Ajakovski/GrowHub/Documentation/growhub_design_v2.pdf

: : dts, g V\ : v.2 : : : : : ; | · · · · · · . . . . -~ . . . . f. -0~ l : n t W t( _i S t J ~ { ~0:--C :v f£ J:

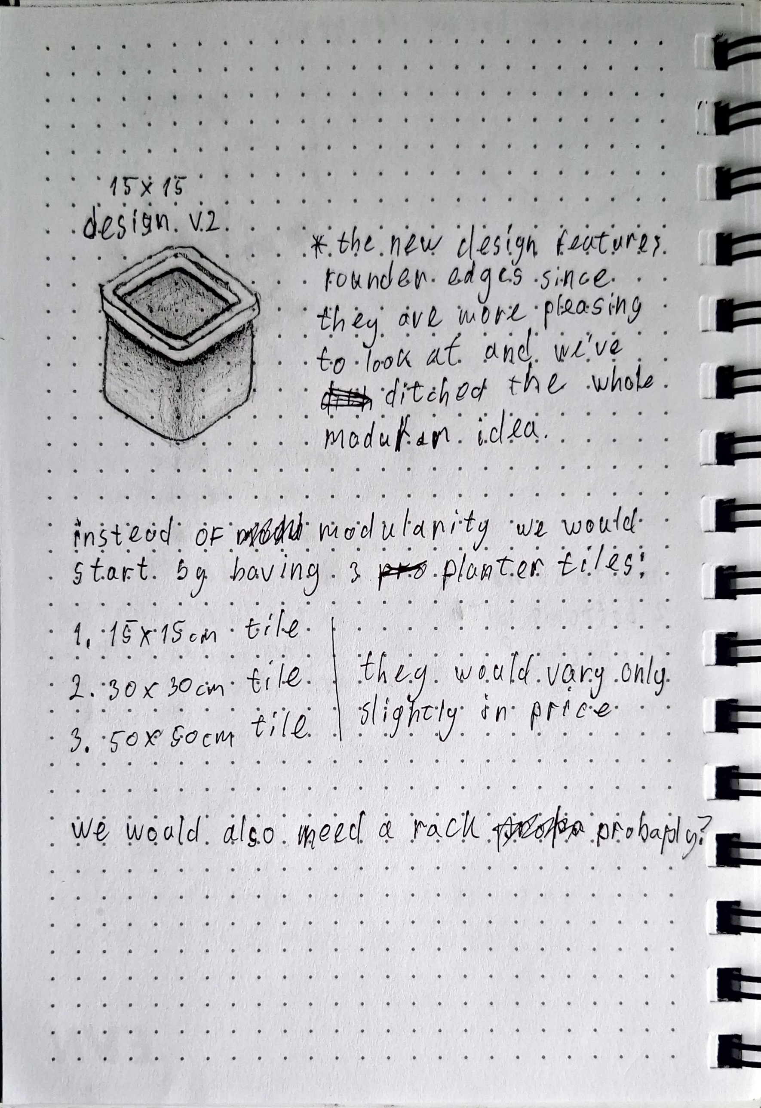
[picture p10: page 1]

- | t | • | t | • | | • • • •
I | • | • | I | •
- | a | • | I | e | t | I | 4 | I | ' | • • • • • • •
| ' | , . . . . • | • | • | • | • | • | • | • | • | It | • | • | • | • • • • • • • , . . . .
- · · 1s-x1t- · · · · · · · · · · · · · · · · · · ·
- • r-ot;_nJtt'• a-J3 LS .5;.ne,e,, . ..
. . | ' : t,h ?:i ~v ~ °W ~ rf, : rr~~£ 1:h~ : . . -f:-o . I o-rJ t{ (/..,t ,cl. n { \11 ,( V f . .
: : . | · k •di-tch 12rf tn t,; -W~ri!A .

## | ·~- ... . : ivi;d~f.Lrt : i:dJ~. : : : : : I

# . ~~0c~t: ~: ~~v:n~ :~ r.:P'.tJ~~~~~1:I?'. : -~

# 1 f • f f x• 15 G ~ • fJ / r~ • ' • • • ~ • , |

" | • | I | • | • | •

~ j
~-J

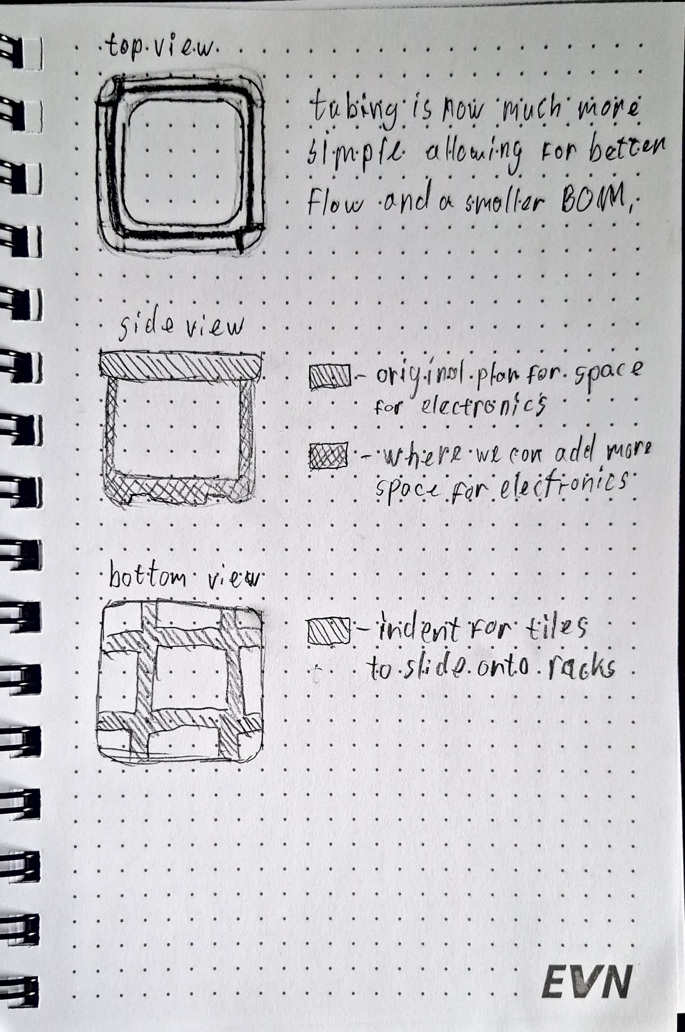
[picture p11: page 2]

~J
J
LI
~ ]
~
~
t:.11
~
~
~
~
t;a
t;;1
~

- • • • • • • • • • • • • • • • • •
| , . . . . ' . . . . .
t~ ~t~.'j J ~ ~Do/ : ri1:u ~~ :~or,: ~ i ·(Vl· p r 1- Q /.fr,~ i-Yl J tor b tt"t."fl F,:~ :0-~J; ~:V'1~1;.1; 66~,: | | . | . | J. | . | . | . | . | . | . | . | . | .
t | I

### - 5• .Q v,~vJ · · ·

. ~~~~ . . .

,;
·-
~-- oti ~-[ riof -p/,,-~ f '1 r - fipo.a
- • ' f o ( fZ( l C-f f C>' nf cf |
ml · -· \V ~:t ¥' t · Wt t' o V{ ad el, r'4 6 r I
: : : : ffO~-L :f~r-<e{t (f~a~ t~S: |
- · bo t ·tol'-'I · v: t t.Jr · |

### ~ ·:-}~d ~~"t :r~r: ~H ~ ~ . . . . '~ . . i a -sf.; Jp. onto . fLtG~

. . . | | EVN

I
