Ajakovski/GrowHub/Firmware/website/frontend/assets/img/growhub_render_v2.png

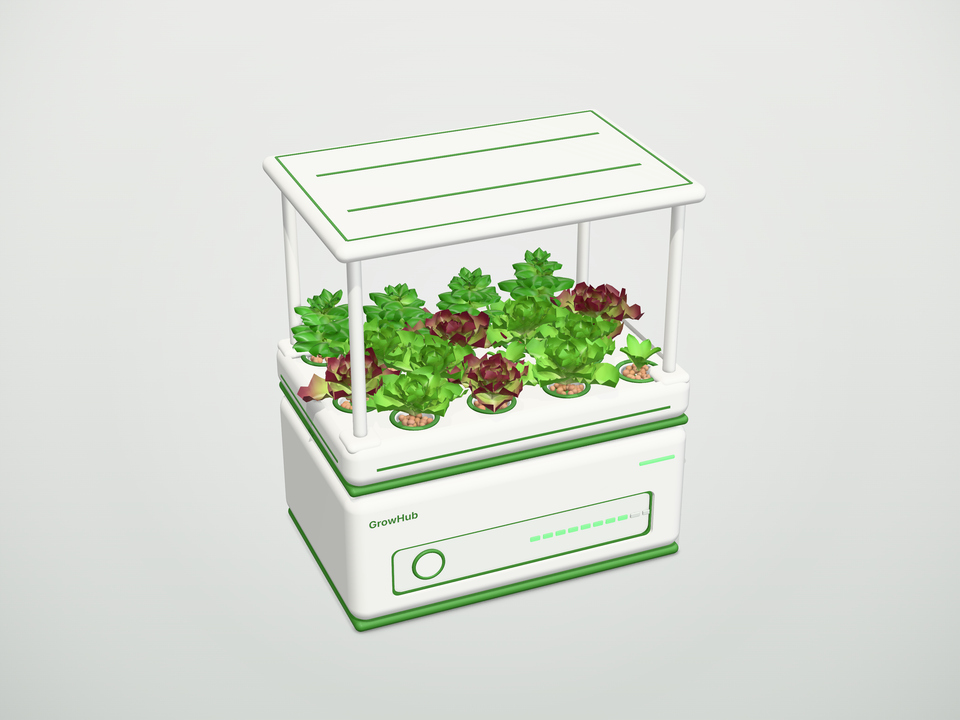
Firmware/website/frontend/assets/img/growhub_render_v2.png
