Ajakovski/GrowHub/Firmware/website/frontend/assets/img/growhub_tile_render_v1.png

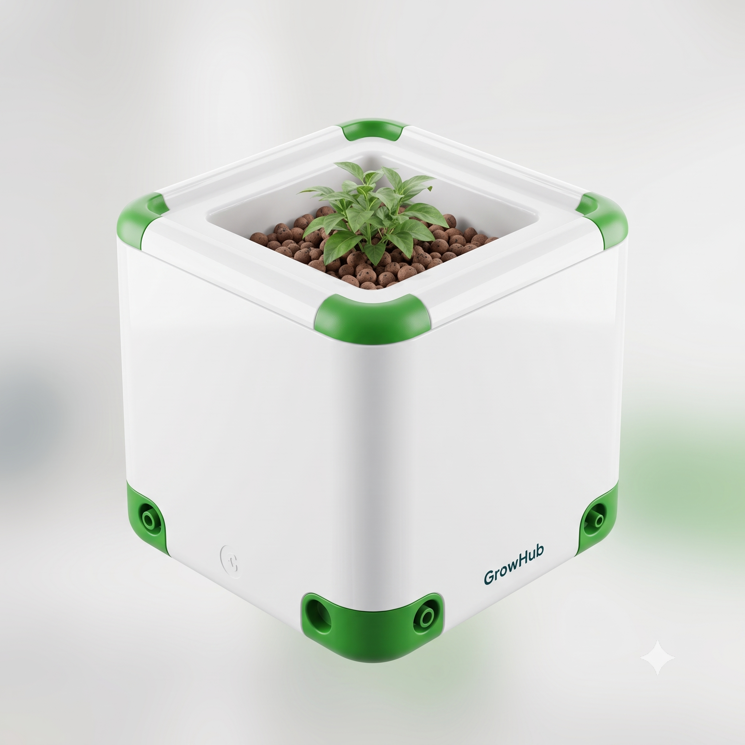
Firmware/website/frontend/assets/img/growhub_tile_render_v1.png
