Ajakovski/GrowHub/Software/website/frontend/assets/img/growhub_stack_poster.jpg

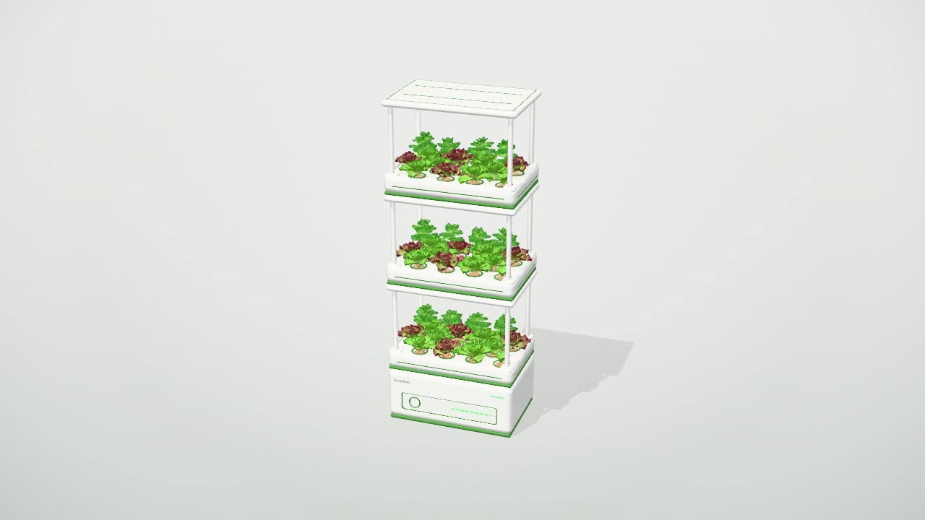
Software/website/frontend/assets/img/growhub_stack_poster.jpg
