Ajakovski/GrowHub/BOM/Floor.csv

'Reference' | 'Qty' | 'Value' | 'DNP' | 'Exclude from BOM' | 'Exclude from Board' | 'Footprint' | 'Datasheet'
'C21' | '1' | '10uF' | '' | '' | '' | 'Capacitor_SMD:C_0805_2012Metric' | ''
'C55,C60,C65,C67,C69,C71' | '6' | '1uF' | '' | '' | '' | 'Capacitor_SMD:C_0603_1608Metric' | ''
'C56,C64' | '2' | '10nF' | '' | '' | '' | 'Capacitor_SMD:C_0603_1608Metric' | ''
'C58,C59,C68,C70,C72,C77,C78,C85' | '8' | '100nF' | '' | '' | '' | 'Capacitor_SMD:C_0603_1608Metric' | ''
'C73,C74' | '2' | '220uF' | '' | '' | '' | 'Capacitor_SMD:CP_Elec_10x10.5' | ''
'C75,C76' | '2' | '1uF' | '' | '' | '' | 'Capacitor_SMD:C_0805_2012Metric' | ''
'D24,D25,D26,D45' | '4' | 'ESD5Z3.3T1G' | '' | '' | '' | 'Diode_SMD:D_SOD-523' | 'https://www.onsemi.com/pdf/datasheet/esd5z2.5t1-d.pdf'
'D27,D28,D29' | '3' | 'ESD5Z6.0T1G' | '' | '' | '' | 'Diode_SMD:D_SOD-523' | 'https://www.onsemi.com/pdf/datasheet/esd5z2.5t1-d.pdf'
'D30,D31' | '2' | 'SS25' | '' | '' | '' | 'Diode_SMD:D_SMA' | 'https://www.vishay.com/docs/88748/ss22.pdf'
'D32,D33' | '2' | 'SS25' | 'DNP' | '' | '' | 'Diode_SMD:D_SMA' | 'https://www.vishay.com/docs/88748/ss22.pdf'
'FB1' | '1' | 'Ferrite 0603 (or 0R)' | '' | '' | '' | 'Inductor_SMD:L_0603_1608Metric' | ''
'J3' | '1' | 'Light plate (Micro-Fit 1x5)' | '' | '' | '' | 'Connector_Molex:Molex_Micro-Fit_3.0_43650-0500_1x05_P3.00mm_Horizontal' | ''
'J6' | '1' | 'Micro-Fit 3.0 2x6 (43045-1213)' | '' | '' | '' | 'GrowHub:0430451213' | 'https://www.digikey.co.uk/en/product-highlight/m/molex-connector/micro-fit-3-interconnect-system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 | amp | amp | gad_source=1&amp | amp | amp | gad_campaignid=23539656616&amp | amp | amp | gbraid=0AAAAADrbLlhEA6_HtBJubkeKUiYNoxpfo&amp | amp | amp | gclid=CjwKCAiAt'
'J7' | '1' | 'Tray electrode (JST PH 2p)' | '' | '' | '' | 'Connector_JST:JST_PH_B2B-PH-K_1x02_P2.00mm_Vertical' | ''
'J20' | '1' | 'AS7341 breakout (Adafruit 4698)' | '' | '' | '' | 'GrowHub:Adafruit_4698_AS7341_Breakout' | ''
'Q12,Q13' | '2' | 'BSS138BK-215' | '' | '' | '' | 'Package_TO_SOT_SMD:SOT-23' | 'https://assets.nexperia.com/documents/data-sheet/BSS138BK.pdf'
'Q14,Q15' | '2' | 'DMN4035L-7' | '' | '' | '' | 'Package_TO_SOT_SMD:SOT-23' | 'https://www.diodes.com/assets/Datasheets/DMN4035L.pdf'
'Q16,Q17' | '2' | 'DMN4035L-7' | 'DNP' | '' | '' | 'Package_TO_SOT_SMD:SOT-23' | 'https://www.diodes.com/assets/Datasheets/DMN4035L.pdf'
'R96' | '1' | '47K' | '' | '' | '' | 'Resistor_SMD:R_0603_1608Metric' | ''
'R99,R105,R125,R126' | '4' | '10K' | '' | '' | '' | 'Resistor_SMD:R_0603_1608Metric' | ''
'R101,R113,R114,R127,R128,R129,R130' | '7' | '100K' | '' | '' | '' | 'Resistor_SMD:R_0603_1608Metric' | ''
'R103' | '1' | '1K' | '' | '' | '' | 'Resistor_SMD:R_0603_1608Metric' | ''
'R104,R106' | '2' | '2.2K' | '' | '' | '' | 'Resistor_SMD:R_0603_1608Metric' | ''
'R107,R108' | '2' | '0' | 'DNP' | '' | '' | 'Resistor_SMD:R_0603_1608Metric' | ''
'R109,R110' | '2' | '4.7K' | '' | '' | '' | 'Resistor_SMD:R_0603_1608Metric' | ''
'R111,R112' | '2' | '33' | '' | '' | '' | 'Resistor_SMD:R_0603_1608Metric' | ''
'R115,R116' | '2' | '33' | 'DNP' | '' | '' | 'Resistor_SMD:R_0603_1608Metric' | ''
'R117,R118' | '2' | '100K' | 'DNP' | '' | '' | 'Resistor_SMD:R_0603_1608Metric' | ''
'U13' | '1' | 'SHT4XI-DIGITAL' | '' | '' | '' | 'GrowHub:SHT4XI-DIGITAL' | ''
'U14,U17' | '2' | 'TPS7A2033PDBVR' | '' | '' | '' | 'Package_TO_SOT_SMD:SOT-23-5' | ''
'U15' | '1' | '74AHCT125' | '' | '' | '' | 'Package_SO:SOIC-14_3.9x8.7mm_P1.27mm' | 'https://www.ti.com/lit/ds/symlink/sn74ahct125.pdf'
'U16' | '1' | 'ADS1115IDGSR' | '' | '' | '' | 'ADS1115IDGSR:SOP50P490X110-10N' | ''
'U18' | '1' | 'DS28E07Q_T' | '' | '' | '' | 'Package_DFN_QFN:Maxim_TDFN-6-1EP_3x3mm_P0.95mm_EP1.5x2.3mm' | ''
'U19' | '1' | 'PCA9685BS_118' | '' | '' | '' | 'Package_DFN_QFN:QFN-28-1EP_6x6mm_P0.65mm_EP4.25x4.25mm' | ''
'U20' | '1' | 'P82B96D' | '' | '' | '' | 'Package_SO:SOIC-8_3.9x4.9mm_P1.27mm' | ''
