Ajakovski/GrowHub/BOM/GrowHub_Elec.csv

'Reference' | 'Qty' | 'Value' | 'DNP' | 'Exclude from BOM' | 'Exclude from Board' | 'Footprint' | 'Datasheet' | 'STANDARD' | 'SnapEDA_Link' | 'THERMAL_PAD' | 'UNIT'
'C1,C5,C7,C10,C12,C15,C17,C22,C26,C27,C28,C35,C37,C47,C48,C49,C50,C79,C80,C81,C83,C84' | '22' | '100nF' | '' | '' | '' | 'Capacitor_SMD:C_0603_1608Metric' | '' | '' | '' | '' | ''
'C2,C9,C14,C33,C46' | '5' | '1uF' | '' | '' | '' | 'Capacitor_SMD:C_0603_1608Metric' | '' | '' | '' | '' | ''
'C3,C38,C39,C41,C42,C51,C52,C53,C54' | '9' | '22uF' | '' | '' | '' | 'Capacitor_SMD:C_1206_3216Metric' | '' | '' | '' | '' | ''
'C4,C6,C16,C18,C20,C57' | '6' | '10nF' | '' | '' | '' | 'Capacitor_SMD:C_0603_1608Metric' | '' | '' | '' | '' | ''
'C8,C44' | '2' | '10uF' | '' | '' | '' | 'Capacitor_SMD:C_0805_2012Metric' | '' | '' | '' | '' | ''
'C11' | '1' | '330pF' | '' | '' | '' | 'Capacitor_SMD:C_0603_1608Metric' | '' | '' | '' | '' | ''
'C13,C34,C40' | '3' | '47nF' | '' | '' | '' | 'Capacitor_SMD:C_0603_1608Metric' | '' | '' | '' | '' | ''
'C19' | '1' | '1nF' | '' | '' | '' | 'Capacitor_SMD:C_0603_1608Metric' | '' | '' | '' | '' | ''
'C23,C32,C45' | '3' | '220nF' | '' | '' | '' | 'Capacitor_SMD:C_0603_1608Metric' | '' | '' | '' | '' | ''
'C24' | '1' | '4.7nF' | '' | '' | '' | 'Capacitor_SMD:C_0603_1608Metric' | '' | '' | '' | '' | ''
'C25' | '1' | '22nF' | '' | '' | '' | 'Capacitor_SMD:C_0603_1608Metric' | '' | '' | '' | '' | ''
'C29' | '1' | '10uF' | '' | '' | '' | 'Capacitor_SMD:C_1210_3225Metric' | '' | '' | '' | '' | ''
'C30,C43' | '2' | '100nF' | '' | '' | '' | 'Capacitor_SMD:C_0805_2012Metric' | '' | '' | '' | '' | ''
'C31' | '1' | '4.7uF' | '' | '' | '' | 'Capacitor_SMD:C_1210_3225Metric' | '' | '' | '' | '' | ''
'C36' | '1' | '220uF' | '' | '' | '' | 'Capacitor_SMD:CP_Elec_10x10.5' | '' | '' | '' | '' | ''
'C82' | '1' | '10uF' | '' | '' | '' | 'Capacitor_SMD:C_1206_3216Metric' | '' | '' | '' | '' | ''
'D1,D2,D5,D6,D7,D17,D18,D39,D40,D42,D43' | '11' | 'ESD5Z3.3T1G' | '' | '' | '' | 'Diode_SMD:D_SOD-523' | 'https://www.onsemi.com/pdf/datasheet/esd5z2.5t1-d.pdf' | '' | '' | '' | ''
'D3' | '1' | 'SS34' | '' | '' | '' | 'Diode_SMD:D_SMA' | 'https://www.vishay.com/docs/88751/ss32.pdf' | '' | '' | '' | ''
'D4,D37,D38' | '3' | 'SK6812' | '' | '' | '' | 'GrowHub:LED_SK6812' | '' | 'Manufacturer Recommendations' | 'https://www.snapeda.com/parts/SK6812/Opsco/view-part/?ref=snap' | '' | ''
'D8,D9,D13,D14,D19,D20,D22,D41,D44' | '9' | 'ESD5Z6.0T1G' | '' | '' | '' | 'Diode_SMD:D_SOD-523' | 'https://www.onsemi.com/pdf/datasheet/esd5z2.5t1-d.pdf' | '' | '' | '' | ''
'D16,D34,D35,D36' | '4' | 'SS16' | '' | '' | '' | 'Diode_SMD:D_SMA' | 'https://www.vishay.com/docs/88746/ss12.pdf' | '' | '' | '' | ''
'D21' | '1' | '1N4148W' | '' | '' | '' | 'Diode_SMD:D_SOD-123' | 'https://www.vishay.com/docs/85748/1n4148w.pdf' | '' | '' | '' | ''
'D23' | '1' | 'SMBJ33A' | '' | '' | '' | 'Diode_SMD:D_SMB' | '' | 'IPC 7351B' | 'https://www.snapeda.com/parts/SMBJ33A-13-F/Diodes+Inc./view-part/?ref=snap' | '' | ''
'F1' | '1' | '3A Slo-Blo 125V' | '' | '' | '' | 'Fuse:Fuse_Littelfuse-NANO2-451_453' | '' | '' | '' | '' | ''
'IC1' | '1' | '74AHCT125D,118' | '' | '' | '' | 'Package_SO:SOIC-14_3.9x8.7mm_P1.27mm' | 'https://assets.nexperia.com/documents/data-sheet/74AHC_AHCT125.pdf' | '' | '' | '' | ''
'J1' | '1' | 'USB-C 2495155-1' | '' | '' | '' | 'GrowHub:TE_2495155-1' | '' | 'Manufacturer Recommendations' | 'https://www.snapeda.com/parts/2495155-1/TE+Connectivity/view-part/?ref=snap' | '' | 'mm'
'J2' | '1' | 'Pump P1 (Micro-Fit 1x4)' | '' | '' | '' | 'Connector_Molex:Molex_Micro-Fit_3.0_43650-0400_1x04_P3.00mm_Horizontal' | '' | '' | '' | '' | ''
'J4,J14,J15' | '3' | 'Micro-Fit 3.0 2x6 (43045-1213)' | '' | '' | '' | 'GrowHub:0430451213' | 'https://www.digikey.co.uk/en/product-highlight/m/molex-connector/micro-fit-3-interconnect-system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 | amp | amp | gad_source=1&amp | amp | amp | gad_campaignid=23539656616&amp | amp | amp | gbraid=0AAAAADrbLlhEA6_HtBJubkeKUiYNoxpfo&amp | amp | amp | gclid=CjwKCAiAt' | '' | '' | '' | ''
'J5' | '1' | 'KPJX-4S (PSU DIN)' | '' | '' | '' | 'GrowHub:KYCON_KPJX-4S' | '' | 'Manufacturer Recommendations' | 'https://www.snapeda.com/parts/KPJX-4S/Kycon/view-part/?ref=snap' | '' | ''
'J8,J9,J10' | '3' | 'VALVE(G88MPB02002C1EU)' | '' | '' | '' | 'GrowHub:AMPHENOL_G88MPB02002C1EU' | '' | 'Manufacturer Recommendations' | 'https://www.snapeda.com/parts/G88MPB02002C1EU/Amphenol/view-part/?ref=snap' | '' | ''
'J11' | '1' | 'Load cell (JST PH 5p)' | '' | '' | '' | 'Connector_JST:JST_PH_B5B-PH-K_1x05_P2.00mm_Vertical' | '' | '' | '' | '' | ''
'J12' | '1' | 'Base leak electrode (JST PH 2p)' | '' | '' | '' | 'Connector_JST:JST_PH_B2B-PH-K_1x02_P2.00mm_Vertical' | '' | '' | '' | '' | ''
'J13' | '1' | 'Float S11 (JST PH 2p)' | '' | '' | '' | 'Connector_JST:JST_PH_B2B-PH-K_1x02_P2.00mm_Vertical' | '' | '' | '' | '' | ''
'L1' | '1' | '8.2uH' | '' | '' | '' | 'Inductor_SMD:L_Coilcraft_XAL1010-XXX' | '' | '' | '' | '' | ''
'L2' | '1' | '6.8uH' | '' | '' | '' | 'Inductor_SMD:L_Coilcraft_XAL7070-XXX' | '' | '' | '' | '' | ''
'PS1' | '1' | 'LMR33610ADDAR' | '' | '' | '' | 'Package_SO:Texas_HSOP-8-1EP_3.9x4.9mm_P1.27mm_ThermalVias' | 'http://www.ti.com/lit/ds/symlink/lmr33610.pdf' | '' | '' | '' | ''
'Q1,Q2,Q3,Q4,Q5,Q6,Q7,Q8,Q9' | '9' | 'BSS138BK-215' | '' | '' | '' | 'Package_TO_SOT_SMD:SOT-23' | 'https://assets.nexperia.com/documents/data-sheet/BSS138BK.pdf' | '' | '' | '' | ''
'Q10' | '1' | 'FDB3632' | '' | '' | '' | 'GrowHub:TO254P1524X483-3N' | '' | 'IPC-7351B' | 'https://www.snapeda.com/parts/FDB3632/Onsemi/view-part/?ref=snap' | '' | ''
'Q11' | '1' | 'FDMS86101' | '' | '' | '' | 'GrowHub:FDMS86252' | 'https://www.onsemi.com/pub/Collateral/FDMS86101-D.PDF' | '' | '' | '' | ''
'Q18,Q19,Q20' | '3' | 'AO3422' | '' | '' | '' | 'Package_TO_SOT_SMD:SOT-23' | 'http://aosmd.com/res/data_sheets/AO3422.pdf' | '' | '' | '' | ''
'Q21' | '1' | 'N-FET 60V >=10A <=20mR@4.5V' | '' | '' | '' | 'GrowHub:FDMS86252' | 'https://www.onsemi.com/pdf/datasheet/fdms86500l-d.pdf' | '' | '' | '' | ''
'R3,R16,R21,R24,R29,R30,R31,R48,R61,R80,R82,R88,R89,R90,R95,R96,R131,R134,R135,R136,R137,R138,R139' | '23' | '10K' | '' | '' | '' | 'Resistor_SMD:R_0603_1608Metric' | '' | '' | '' | '' | ''
'R4,R9,R40,R42,R51,R84,R85' | '7' | '4.7K' | '' | '' | '' | 'Resistor_SMD:R_0603_1608Metric' | '' | '' | '' | '' | ''
'R5,R6' | '2' | '0' | '' | '' | '' | 'Resistor_SMD:R_0603_1608Metric' | '' | '' | '' | '' | ''
'R10,R11,R12,R18,R19,R20,R27,R33,R44,R66,R75,R78,R83,R93,R97,R122,R123,R124,R132' | '19' | '100K' | '' | '' | '' | 'Resistor_SMD:R_0603_1608Metric' | '' | '' | '' | '' | ''
'R13,R14,R81,R119,R120,R121' | '6' | '100' | '' | '' | '' | 'Resistor_SMD:R_0603_1608Metric' | '' | '' | '' | '' | ''
'R15,R23' | '2' | '5.1K' | '' | '' | '' | 'Resistor_SMD:R_0603_1608Metric' | '' | '' | '' | '' | ''
'R17,R67,R91,R92' | '4' | '10' | '' | '' | '' | 'Resistor_SMD:R_0603_1608Metric' | '' | '' | '' | '' | ''
'R22' | '1' | '47' | '' | '' | '' | 'Resistor_SMD:R_0603_1608Metric' | '' | '' | '' | '' | ''
'R25' | '1' | '220' | '' | '' | '' | 'Resistor_SMD:R_0603_1608Metric' | '' | '' | '' | '' | ''
'R26,R32,R35,R36,R37,R38,R39,R54,R63,R133' | '10' | '1K' | '' | '' | '' | 'Resistor_SMD:R_0603_1608Metric' | '' | '' | '' | '' | ''
'R28' | '1' | '8.2K' | '' | '' | '' | 'Resistor_SMD:R_0603_1608Metric' | '' | '' | '' | '' | ''
'R34' | '1' | '5.6K' | '' | '' | '' | 'Resistor_SMD:R_0603_1608Metric' | '' | '' | '' | '' | ''
'R41' | '1' | '1.2K' | '' | '' | '' | 'Resistor_SMD:R_0603_1608Metric' | '' | '' | '' | '' | ''
'R43' | '1' | '820' | '' | '' | '' | 'Resistor_SMD:R_0603_1608Metric' | '' | '' | '' | '' | ''
'R45' | '1' | '4.87K' | '' | '' | '' | 'Resistor_SMD:R_0603_1608Metric' | '' | '' | '' | '' | ''
'R46,R47,R55,R56,R68,R69' | '6' | '22K' | '' | '' | '' | 'Resistor_SMD:R_0603_1608Metric' | '' | '' | '' | '' | ''
'R49,R50,R57,R58,R71,R72' | '6' | '0' | 'DNP' | '' | '' | 'Resistor_SMD:R_0603_1608Metric' | '' | '' | '' | '' | ''
'R52,R53,R64,R65,R76,R77' | '6' | '2.2K' | '' | '' | '' | 'Resistor_SMD:R_0603_1608Metric' | '' | '' | '' | '' | ''
'R59' | '1' | '243K' | '' | '' | '' | 'Resistor_SMD:R_0603_1608Metric' | '' | '' | '' | '' | ''
'R60' | '1' | '6.04K' | '' | '' | '' | 'Resistor_SMD:R_0603_1608Metric' | '' | '' | '' | '' | ''
'R62' | '1' | '1M' | '' | '' | '' | 'Resistor_SMD:R_0603_1608Metric' | '' | '' | '' | '' | ''
'R70' | '1' | '5m 1% 1W' | '' | '' | '' | 'Resistor_SMD:R_Shunt_Vishay_WSK2512_6332Metric_T1.19mm' | '' | '' | '' | '' | ''
'R73' | '1' | '115K' | '' | '' | '' | 'Resistor_SMD:R_0603_1608Metric' | '' | '' | '' | '' | ''
'R74' | '1' | '4.99K' | '' | '' | '' | 'Resistor_SMD:R_0603_1608Metric' | '' | '' | '' | '' | ''
'R79' | '1' | '24.9K' | '' | '' | '' | 'Resistor_SMD:R_0603_1608Metric' | '' | '' | '' | '' | ''
'R94' | '1' | '43.2K' | '' | '' | '' | 'Resistor_SMD:R_0603_1608Metric' | '' | '' | '' | '' | ''
'R140,R141,R142,R143,R144,R145' | '6' | '1K' | '' | '' | '' | 'Resistor_SMD:R_2010_5025Metric' | '' | '' | '' | '' | ''
'SW1' | '1' | 'RESET (optional)' | '' | '' | '' | 'Button_Switch_SMD:SW_SPST_TL3342' | '' | '' | '' | '' | ''
'SW2' | '1' | 'BOOT/SETUP (optional)' | '' | '' | '' | 'Button_Switch_SMD:SW_SPST_TL3342' | '' | '' | '' | '' | ''
'TP1' | '1' | 'IO-0' | '' | '' | '' | 'TestPoint:TestPoint_Pad_D1.5mm' | '' | '' | '' | '' | ''
'TP2' | '1' | 'U0TXD' | '' | '' | '' | 'TestPoint:TestPoint_Pad_D1.5mm' | '' | '' | '' | '' | ''
'TP3' | '1' | 'U0RXD' | '' | '' | '' | 'TestPoint:TestPoint_Pad_D1.5mm' | '' | '' | '' | '' | ''
'TP4' | '1' | 'EN' | '' | '' | '' | 'TestPoint:TestPoint_Pad_D1.5mm' | '' | '' | '' | '' | ''
'TP5' | '1' | 'IO3' | '' | '' | '' | 'TestPoint:TestPoint_Pad_D1.5mm' | '' | '' | '' | '' | ''
'TP6' | '1' | 'IO10' | '' | '' | '' | 'TestPoint:TestPoint_Pad_D1.5mm' | '' | '' | '' | '' | ''
'TP7' | '1' | 'LED_DOUT' | '' | '' | '' | 'TestPoint:TestPoint_Pad_D1.5mm' | '' | '' | '' | '' | ''
'TP8' | '1' | 'MUX_SD3-7' | '' | '' | '' | 'TestPoint:TestPoint_Pad_D1.5mm' | '' | '' | '' | '' | ''
'TP9' | '1' | 'MUX_SC3-7' | '' | '' | '' | 'TestPoint:TestPoint_Pad_D1.5mm' | '' | '' | '' | '' | ''
'TP10,TP11' | '2' | 'GND' | '' | '' | '' | 'TestPoint:TestPoint_Pad_D1.5mm' | '' | '' | '' | '' | ''
'TP12' | '1' | '+3V3' | '' | '' | '' | 'TestPoint:TestPoint_Pad_D1.5mm' | '' | '' | '' | '' | ''
'TP13' | '1' | '+5V' | '' | '' | '' | 'TestPoint:TestPoint_Pad_D1.5mm' | '' | '' | '' | '' | ''
'TP14' | '1' | '+24V' | '' | '' | '' | 'TestPoint:TestPoint_Pad_D1.5mm' | '' | '' | '' | '' | ''
'TP15' | '1' | 'VIN' | '' | '' | '' | 'TestPoint:TestPoint_Pad_D1.5mm' | '' | '' | '' | '' | ''
'U1' | '1' | 'USBLC6-2P6' | '' | '' | '' | 'Package_TO_SOT_SMD:SOT-666' | '' | 'IPC 7351B' | 'https://www.snapeda.com/parts/USBLC6-2P6/STMicroelectronics/view-part/?ref=snap' | '' | ''
'U2' | '1' | 'VEML7700-TT' | '' | '' | '' | 'GrowHub:XDCR_VEML7700-TT' | '' | 'Manufacturer Recommendations' | 'https://www.snapeda.com/parts/VEML7700-TT/Vishay/view-part/?ref=snap' | '' | ''
'U3' | '1' | 'NAU7802SGI' | '' | '' | '' | 'Package_SO:SOIC-16_3.9x9.9mm_P1.27mm' | '' | 'IPC-7.51B' | 'https://www.snapeda.com/parts/NAU7802SGI/Nuvoton/view-part/?ref=snap' | '' | ''
'U4' | '1' | 'TPS27S100BPWPR' | '' | '' | '' | 'GrowHub:IC_TPS27S100BPWPR' | '' | '' | 'https://www.snapeda.com/parts/TPS27S100BPWPR/Texas+Instruments/view-part/?ref=snap' | '' | ''
'U5,U7,U9' | '3' | 'PCA9600DPZ' | '' | '' | '' | 'Package_SO:TSSOP-8_3x3mm_P0.65mm' | 'PCA9600DPZ' | '' | '' | '' | ''
'U6' | '1' | 'ESP32-S3-WROOM-1U-N16R8' | '' | '' | '' | 'GrowHub:XCVR_ESP32-S3-WROOM-1U-N16R8' | '' | 'Manufacturer Recommendations' | 'https://www.snapeda.com/parts/ESP32-S3-WROOM-1U-N16R8/Espressif+Systems/view-part/?ref=snap' | '' | ''
'U8' | '1' | 'LTC4364IS-2_PBF' | '' | '' | '' | 'Package_SO:SOIC-16_3.9x9.9mm_P1.27mm' | '' | '' | 'https://www.snapeda.com/parts/LTC4364IS-2%23PBF/Analog+Devices/view-part/?ref=snap' | '' | ''
'U10' | '1' | 'LMR33630ADDA' | '' | '' | '' | 'Package_SO:Texas_HSOP-8-1EP_3.9x4.9mm_P1.27mm_ThermalVias' | '' | '' | 'https://www.snapeda.com/parts/LMR33630ADDA/Texas+Instruments/view-part/?ref=snap' | '' | ''
'U11' | '1' | 'INA226AIDGSR' | '' | '' | '' | 'Package_SO:TSSOP-10_3x3mm_P0.5mm' | '' | 'IPC-7351B' | 'https://www.snapeda.com/parts/INA226AIDGSR/Texas+Instruments/view-part/?ref=snap' | '' | ''
'U12' | '1' | 'TCA9548APWR' | '' | '' | '' | 'Package_SO:TSSOP-24_4.4x7.8mm_P0.65mm' | '' | 'IPC-7351B' | 'https://www.snapeda.com/parts/TCA9548APWR/Texas+Instruments/view-part/?ref=snap' | '' | ''
'Z1,Z2' | '2' | 'DDZ9702T-7' | '' | '' | '' | 'Diode_SMD:D_SOD-523' | 'https://www.diodes.com/assets/Datasheets/ds30553.pdf' | '' | '' | '' | ''
