Ajakovski/GrowHub/Hardware/CAD_designs/growhub_design_v4.1-main_pcb_compartment.stl.step

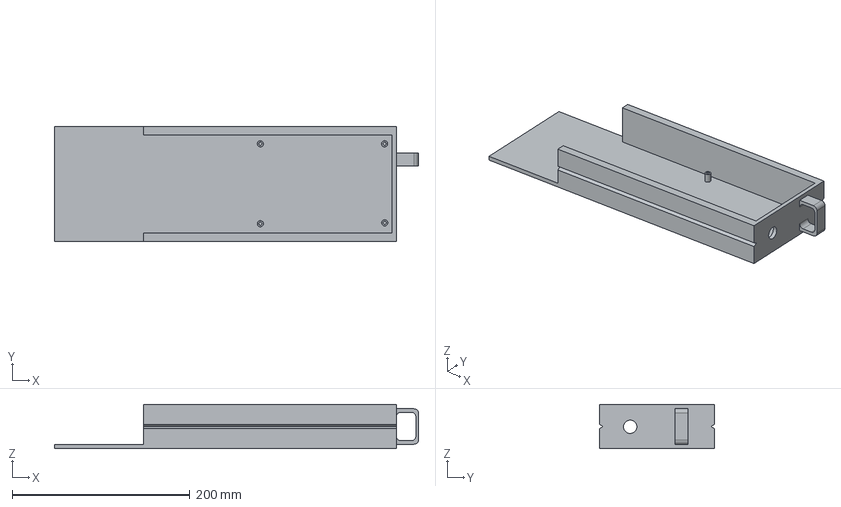
[picture p15: CAD file, 2026-11-08]
Hardware/CAD_designs/growhub_design_v4.1-main_pcb_compartment.stl.step
410.0 x 130.0 x 50.0 mm
