Ajakovski/GrowHub/Hardware/CAD_designs/Main_PCB.step

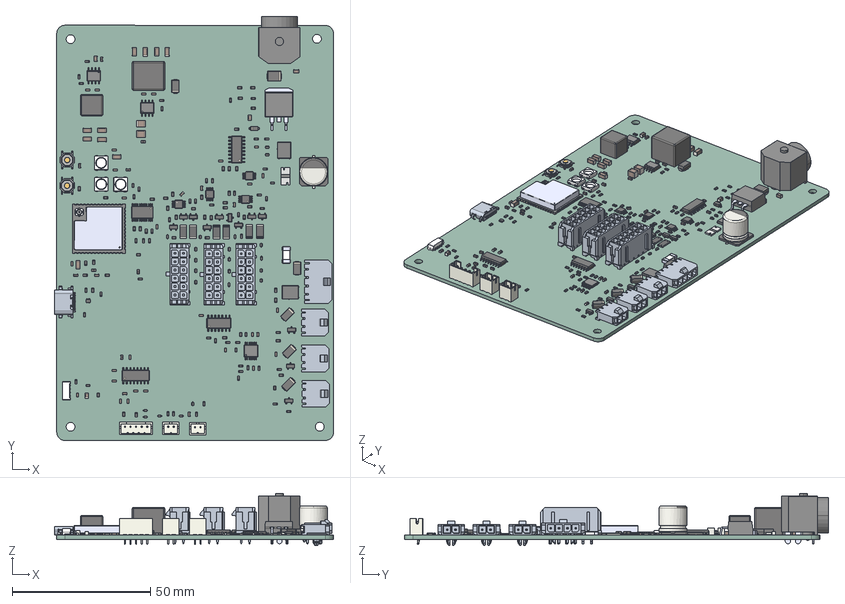
[picture p16: CAD file, 2026-11-07]
Hardware/CAD_designs/Main_PCB.step
100.8 x 153.1 x 18.8 mm
SK6812--3DModel-STEP-1 x 3
R_0603_1608Metric x 99
D_SOD-523 x 22
C_0603_1608Metric x 43
SOT-23 x 12
.step 1.16 x 3
C_1206_3216Metric x 10
R_2010_5025Metric x 6
TSSOP-8_3x3mm_P0.65mm x 3
JST_PH_B5B-PH-K_1x05_P2.00mm_Vertical
D_SMA x 5
VEML7700-TT--3DModel-STEP-269445
SOT-666
.step 1.59
JST_PH_B2B-PH-K_1x02_P2.00mm_Vertical x 2
FDMS86101A x 2
L_Coilcraft_XAL7070-XXX
WSK25125L000FEA
G88MPB02002C1EU--3DModel-STEP-533182 x 3
2340901-1--3DModel-STEP-78480
TSSOP-10_3x3mm_P0.5mm
ESP32-S3-WROOM-1U-N16R8--3DModel-STEP-56544
D_SMB
LMR33610ADDAR
SOIC-16_3.9x9.9mm_P1.27mm x 2
C_1210_3225Metric x 2
SOIC-14_3.9x8.7mm_P1.27mm
TSSOP-24_4.4x7.8mm_P0.65mm
CP_Elec_10x10.5
SW_SPST_TL3342 x 2
KPJX-4S
C_0805_2012Metric x 4
LMR33630ADDA
FDB3632
D_SOD-123
L_Coilcraft_XAL1010-XXX
TPS27S100BPWPR
0454003.MR
GrowHub_Elec_PCB
