Ajakovski/GrowHub/Hardware/CAD_designs/growhub_design_v4.1-planter_box_v1.1.step

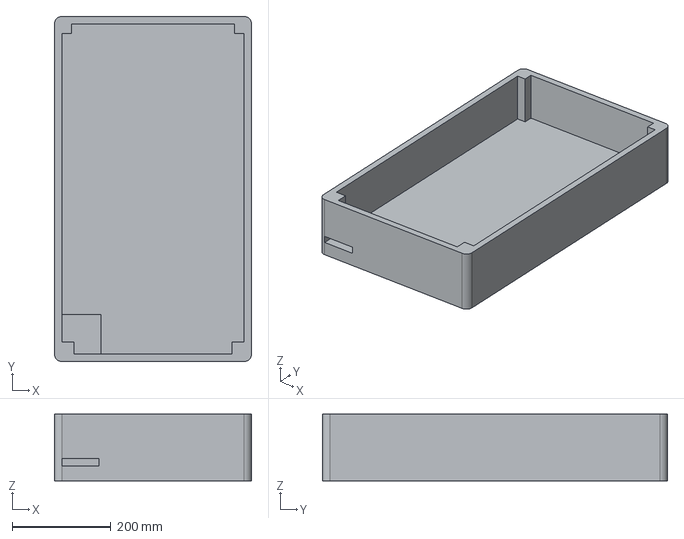
[picture p17: CAD file, 2026-11-10]
Hardware/CAD_designs/growhub_design_v4.1-planter_box_v1.1.step
400.0 x 700.0 x 135.0 mm
