Ajakovski/GrowHub/Hardware/CAD_designs/growhub_design_v4.1-floor_pcb_compartment.step

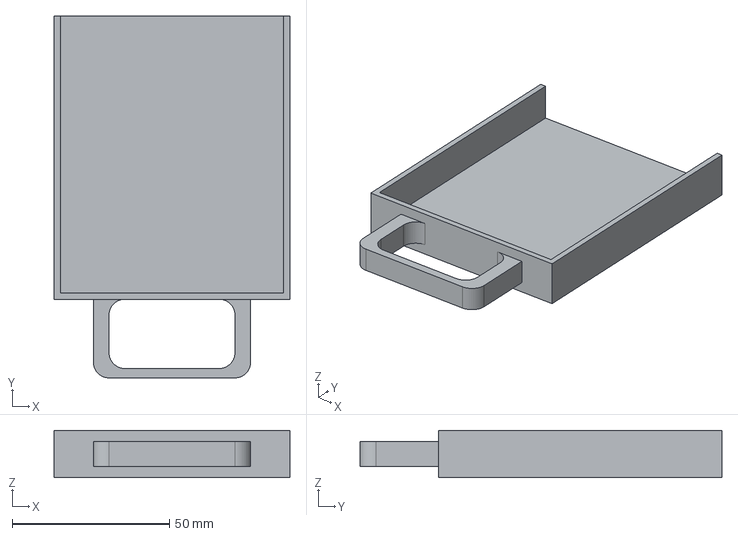
[picture p18: CAD file, 2026-11-10]
Hardware/CAD_designs/growhub_design_v4.1-floor_pcb_compartment.step
75.0 x 115.0 x 15.0 mm
