Ajakovski/GrowHub/Hardware/CAD_designs/growhub_design_v4.1-planter_box.step

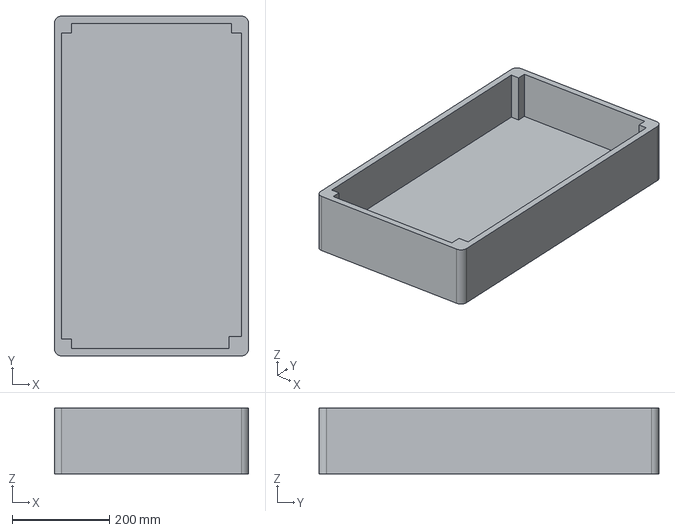
[picture p19: CAD file, 2026-11-08]
Hardware/CAD_designs/growhub_design_v4.1-planter_box.step
400.0 x 700.0 x 135.0 mm
