Ajakovski/GrowHub/Hardware/CAD_designs/growhub_design_v4.1-lights.step

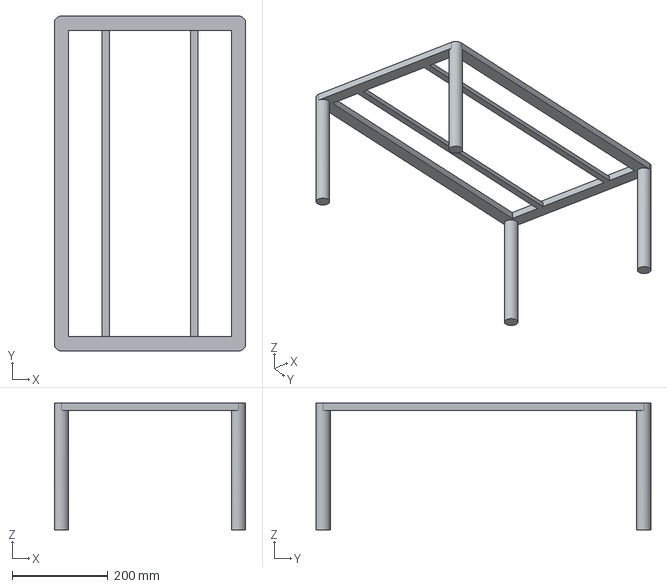
[picture p20: CAD file, 2026-11-08]
Hardware/CAD_designs/growhub_design_v4.1-lights.step
400.0 x 700.0 x 265.0 mm
