Ajakovski/GrowHub/Hardware/CAD_designs/growhub_design_v4.1-planter_grid.step

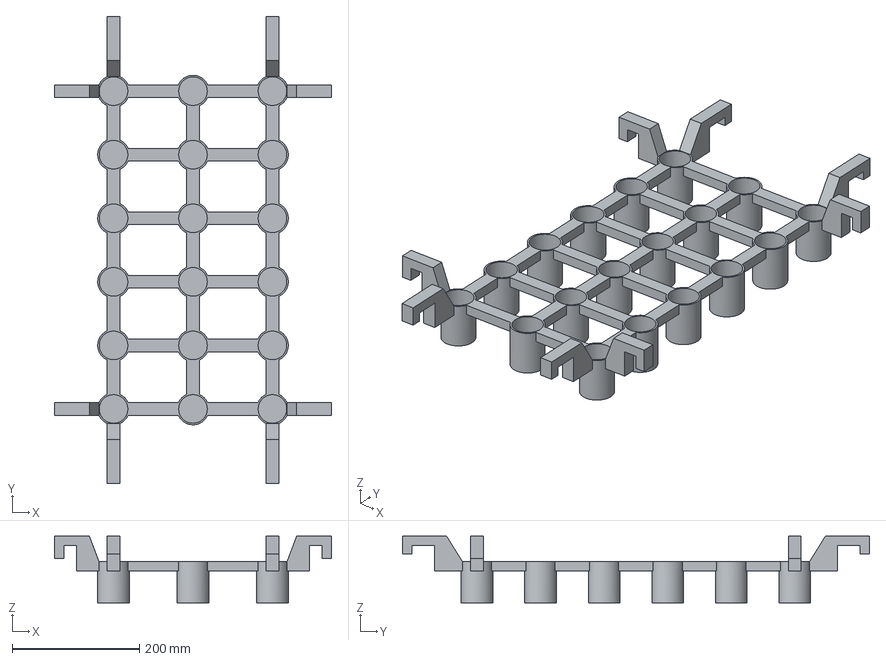
[picture p21: CAD file, 2026-11-08]
Hardware/CAD_designs/growhub_design_v4.1-planter_grid.step
435.8 x 734.7 x 105.0 mm
