Ajakovski/GrowHub/Hardware/CAD_designs/growhub_design_v4.1-reservoir_v2.step

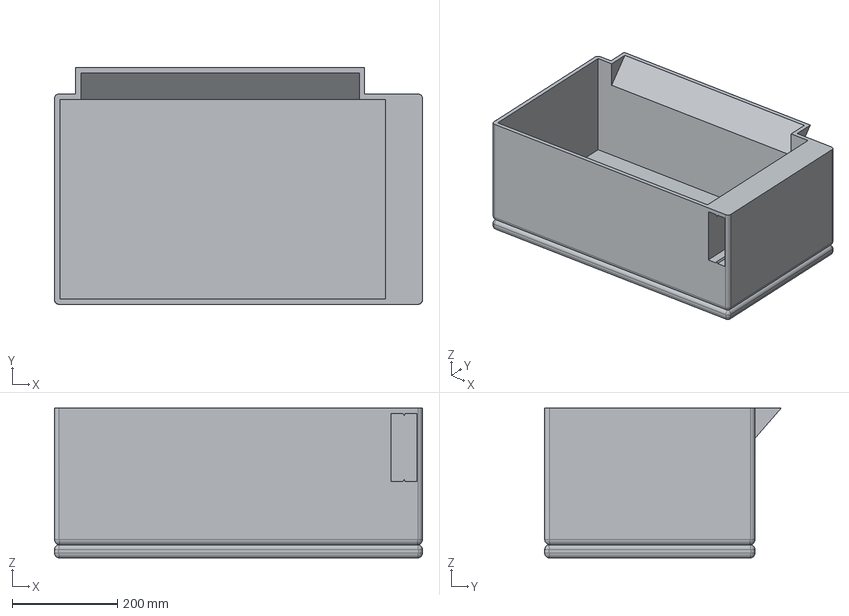
[picture p22: CAD file, 2026-11-08]
Hardware/CAD_designs/growhub_design_v4.1-reservoir_v2.step
700.0 x 450.0 x 285.0 mm
