Ajakovski/GrowHub/Hardware/CAD_designs/Floor_PCB.step

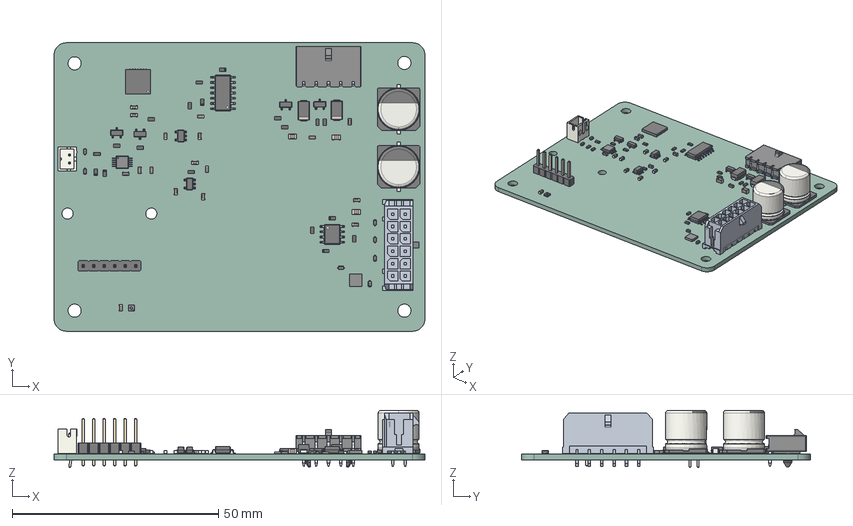
[picture p23: CAD file, 2026-11-07]
Hardware/CAD_designs/Floor_PCB.step
90.0 x 70.0 x 13.9 mm
C_0603_1608Metric x 16
R_0603_1608Metric x 19
CP_Elec_10x10.5 x 2
D_SMA x 2
D_SOD-523 x 7
C_0805_2012Metric x 3
JST_PH_B2B-PH-K_1x02_P2.00mm_Vertical
2157602005--3DModel-STEP-510211
.step 1.26
DS28E07Q+T
SOT-23 x 4
QFN-28-1EP_6x6mm_P0.65mm_EP4.25x4.25mm
SOIC-14_3.9x8.7mm_P1.27mm
SOT-23-5 x 2
L_0603_1608Metric
Body001 (Mirror #1) x 5
XY-plane x 12
X-axis x 12
SHT40I-AD1B-R2--3DModel-STEP-269445
PinHeader_1x06_P2.54mm_Vertical
SOIC-8_3.9x4.9mm_P1.27mm
Floor_PCB
