Ajakovski/GrowHub/Hardware/CAD_designs/growhub_design_v4.1.FCStd

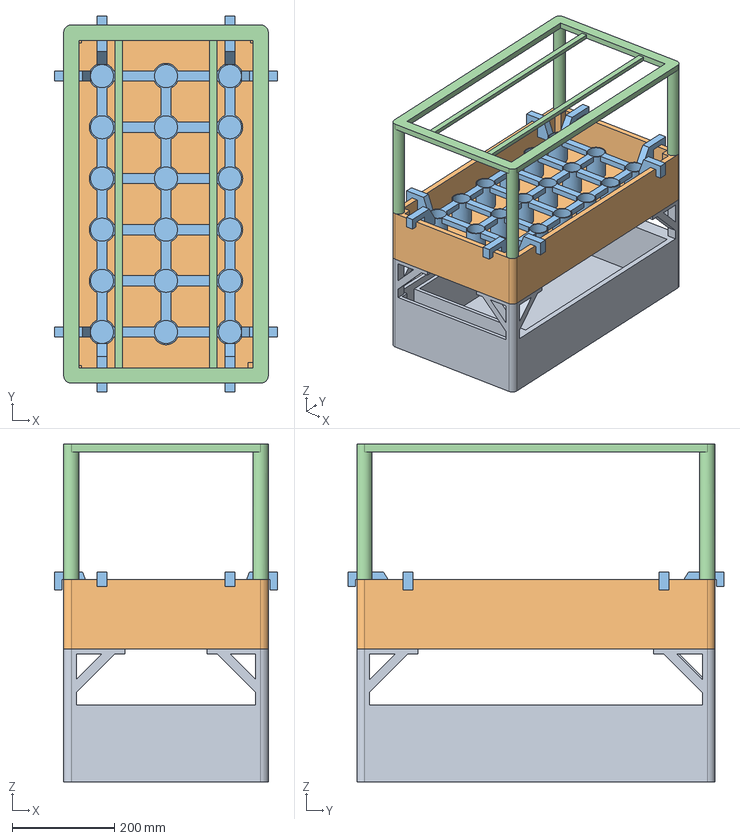
[picture p24: CAD file, 2026-10-11]
Hardware/CAD_designs/growhub_design_v4.1.FCStd
435.8 x 734.7 x 660.0 mm
reservoir
planter_box
planter_grid
lights
