Ajakovski/GrowHub/Hardware/CAD_designs/growhub_design_v4.FCStd

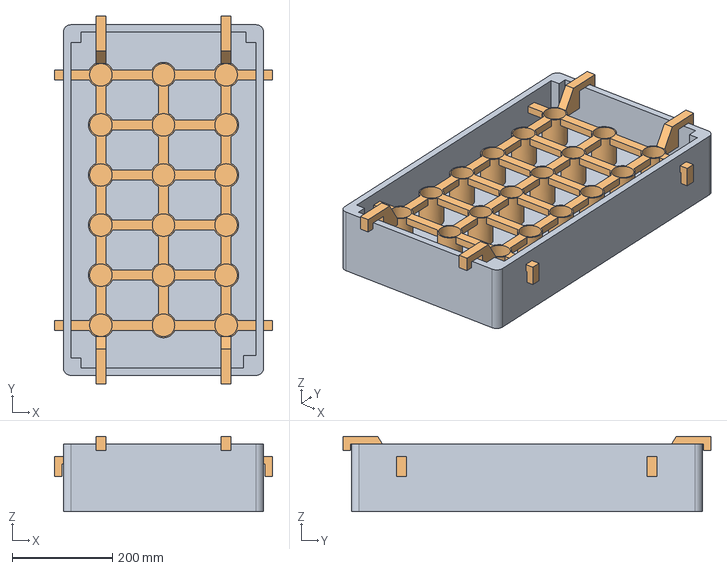
[picture p25: CAD file, 2026-10-04, an earlier design]
Hardware/CAD_designs/growhub_design_v4.FCStd
435.8 x 734.7 x 150.0 mm
planter_box
planter_grid
