Ajakovski/GrowHub/AJ_JOURNAL.md

# GrowHub - Journal

- Author: ajakovski07

---

## 34. Timelapse 11.11.2026

We've finally shipped the project as functional!!!

it is ready for review and I hope that it passes first try so that we can claim our rewards :)))

It was an amazing project to work with my partner and we sacrificed a lot during these 2 months in order to make this functional.

There is still more to work on but this can also be accounted for fully functional and anything else would only be an upgrade.

---

## 33. Timelapse 07.11.2026

I will keep it short considering that i am still having crazy fatigues and nausea due to my illness.

README and Repo sorting is DONE...

The README lacks only Firmware configuration and that will be done in week 9

Otherwise everything else is set to be sorted out by the end of week 9 where we will finally ship it as a functional project. YIPPIEEEE

I am following on how to prepare a README from my previous shipped project back in Fallout where it got approved  and i remember following every rule back then for having a nice README. So i hope it is what its supposed to be and if not we will quickly fix it in order to get approved :)

Also sorry for timelapsing on VSCode it was only for the purpose of creating folders into the repository because i find it easier that way xD

---

## 32. Timelapse 06.11.2026

Bruhhh i am getting so sick i can barely work on the project....

Im lowkey trying to survive while i work on the project but here i am. Tomorrow i will do around 1:30 hours more and im done for week 8.

---

**What I did:**

- Worked on the README file.
- Researched the BOM for the project and how to assemble it.

---

**Probmes that occured:**

- A lot of BOM components for which i will just use AI. I really think that it wont be againts the rules o generate a .md table with AI because i feel like a fraud tipying it out manually and then i will just find the links and prices for them.

---

**Whats next:**

- Finish off the README
- Sort out the files in the repository
- Help my partner with the firmware

Once again nothing much i can screenshot honestly. 

---

## 31. Timelapse 05.11.2026

Were getting close to the end and so is the work with the project.

I am running late on time for the firmware so thats why my partner started it.

But i am also assigned for the whole README so while he does the code i will just sort out the READMEE i guess.

---

**What I did:**

- Created every file needed from KiCad
- Fixed minor PCB errors
- Imported a missing .step file
- Started the README

---

**Problems that i've had:**

- My laptop crashed a couple times which is due to low RAM sadly its a 2019 500$ laptop so it does need an upgrade [sideye] i suppose that why im working on thirdspace :)))
- A lot of files were created but its fine github loves files

---

**Whats next:**

- Finish the README. It is quite a big task so it might lowkey be only that untill the end of week 8.
- Help on the firmware
- Sort out the repo for shipping

About pictures... There is nothing much except the amount of files that i've created but that will be available soon when i commit it.

---

## 30. Timelapse 04.11.2026

Forgot to journal for yesterday so ill do it real quick now.

I finished every DRC error, remove via in pads and optimised the Plane Fills.
I also improved wiring and i need to focus on that a little bit more.

Im lowkey soo sick i can barely thug out this week :////

---

## 29. Timelapse 03.11.2026

I lowkey speedran the floor PCB

Maybe because of the previous PCB being so complex this one felt extrordinarily easy.

**What i did:**

- Finished the floor PCB
- Assigned all .step files

---

**Problems that occured:**

- Nothing much except my irl sickness

---

**What's next:**

- Do a DRC on the floor PCB
- Do a visual revision on both PCBs
- Write the documentation
- Start the firmware


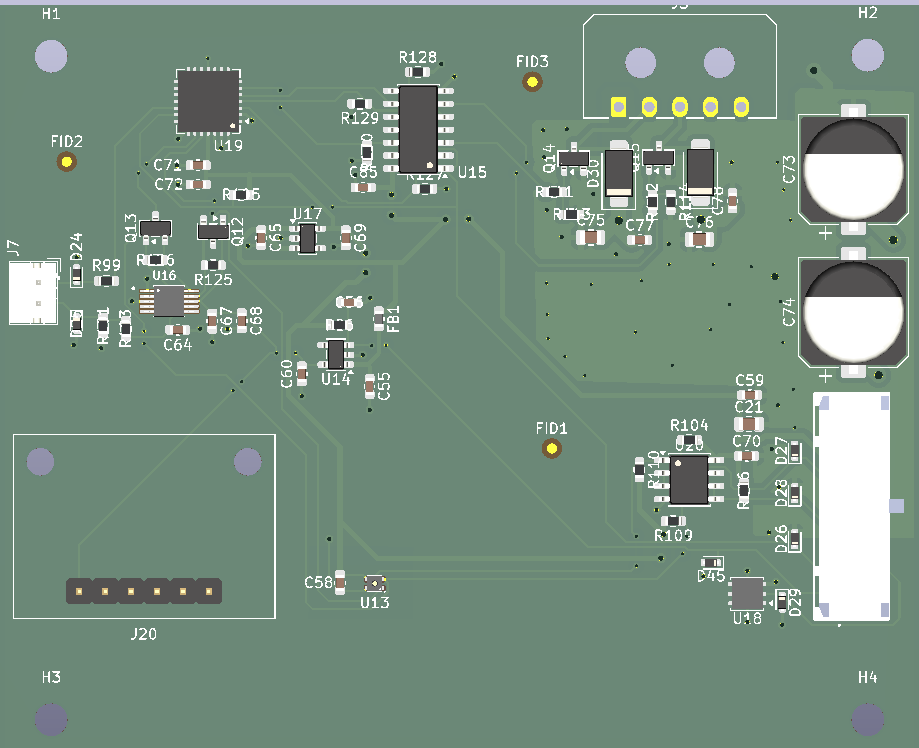
[picture p26: Documentation/Pictures/Journal_AJ/Image69.png]


---

## 28. Timelapse 2.11.2026

Bruhh i feel like having a period:////

I tried to work a bit but im having such a horrible stomach ache i might lowkey die.

I lowkey did not do anything significant so i will just let this journal as it is because i really dont have the power if polishing it i gotta drink some medications and go to sleep.

---

## 27. Timelapse 1.11.2026

Crazy multitasking today but i did my +10 hours still...

The Floor PCB is halfway done. Firmware production is getting close and so is the end of this YSWS :((

---

**What i did:**

- Halfway done Floor PCB
- Added a couple 3D models

---

**Problems that occured:**

- Nothing much except the fact that i was perma disturbed by something irl

---

**Next step:**

- Finish off the PCB
- Do a full DRC and visual check on both boards
- Start the firmware

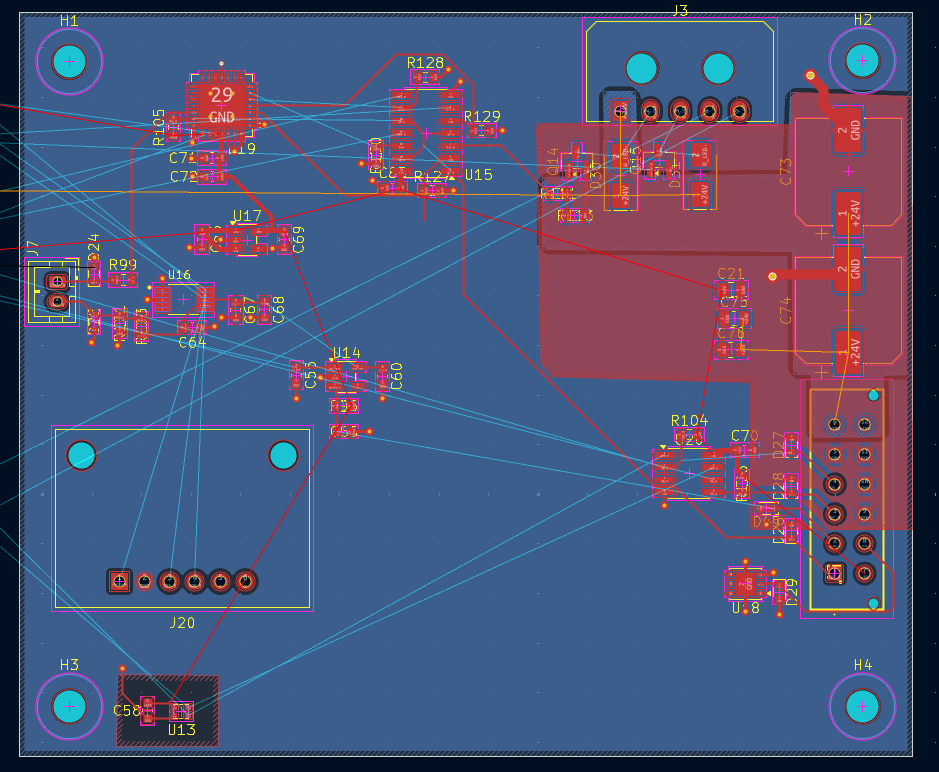
[picture p27: Documentation/Pictures/Journal_AJ/Image66.png]

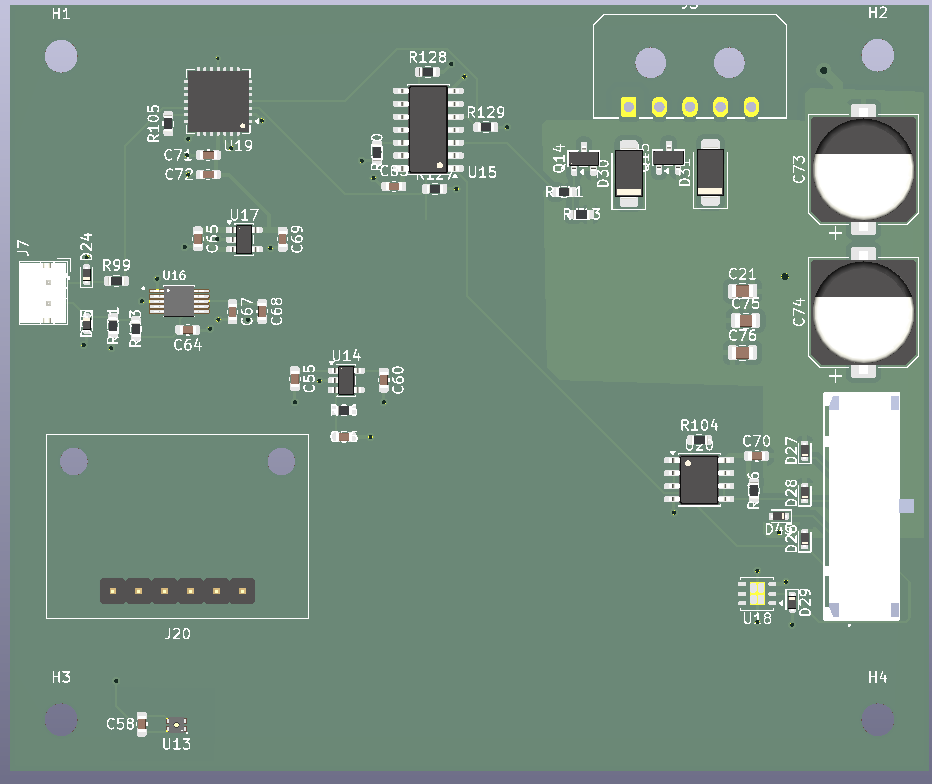
[picture p28: Documentation/Pictures/Journal_AJ/Image67.png]


---

## 26. Timelapse 31.10.2026

Spooky scary skeletons. I grinded a bit today...

Soo i am finally done with the main PCB and SUPRISINGLY I HAD BARELY ANY DRC ERRORS.

There are some that i need to research whether they are crucial or not but we will see.

---

**What i did:**

- Finished the main PCB
- Enhanced it with return current
- Fixed DRC 80%
- Started the Floor PCB

---

**Problems that i had:**

- I barely managed to get myself out with the wiring issues but at the end i did it
- My eyes hurt

---

**What's next:**

- Finish the Floor PCB
- Finish DRC for both boards
- Review them once again
- Start the Firmware


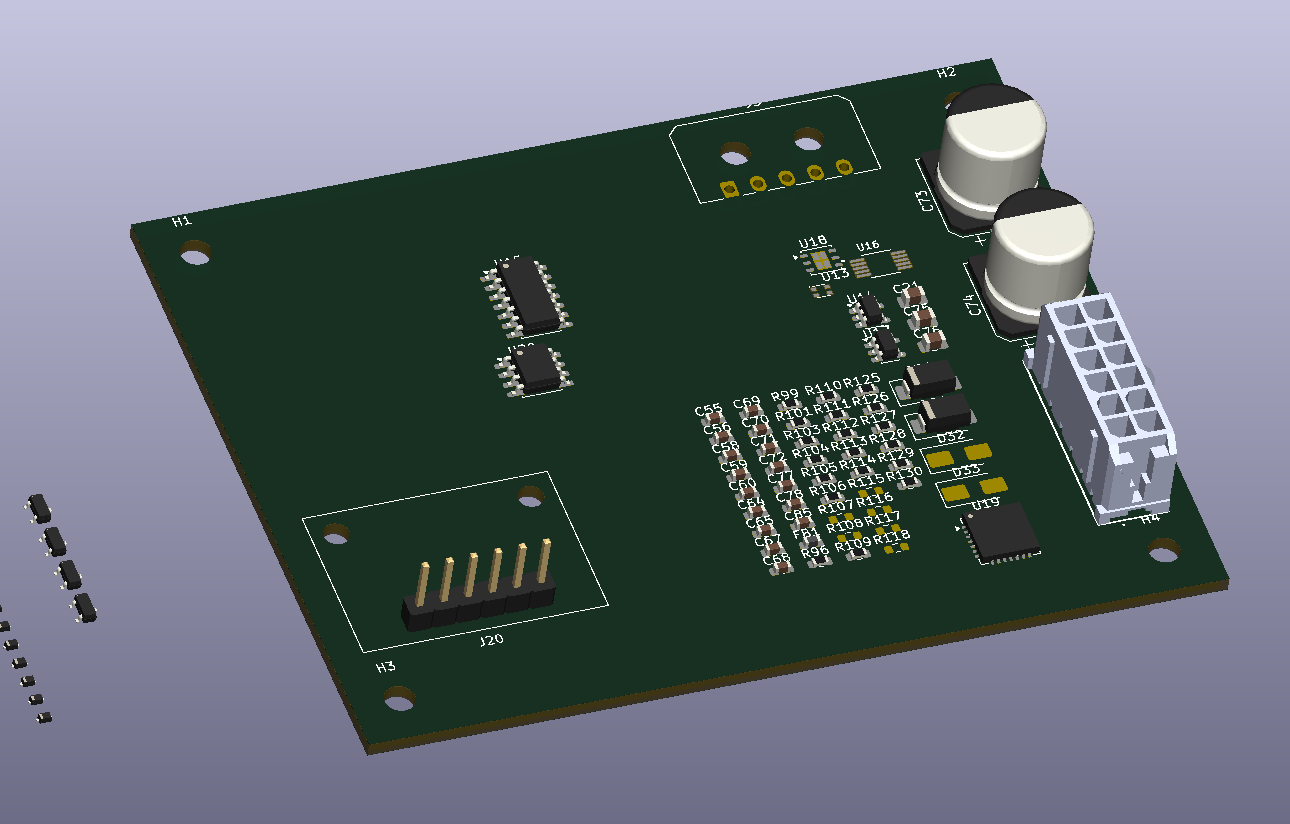
[picture p29: Documentation/Pictures/Journal_AJ/Image63.png]

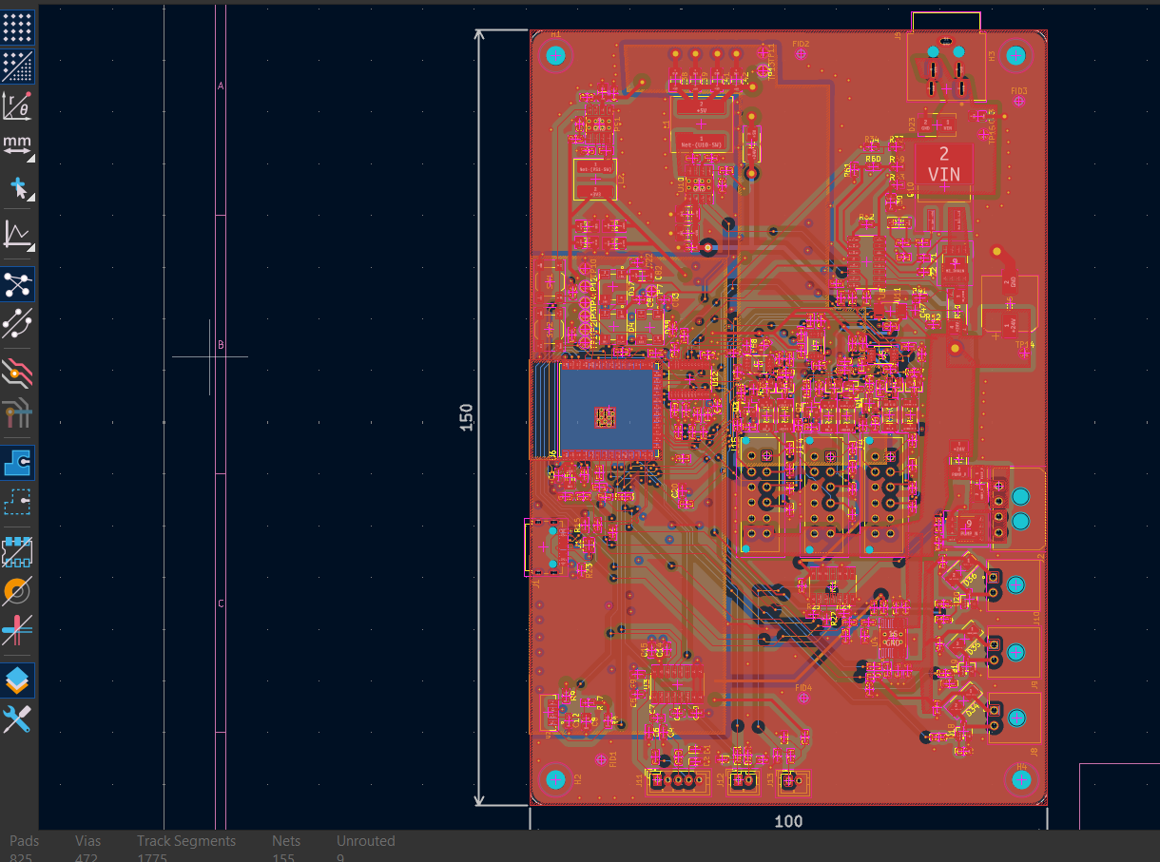
[picture p30: Documentation/Pictures/Journal_AJ/Image64.png]

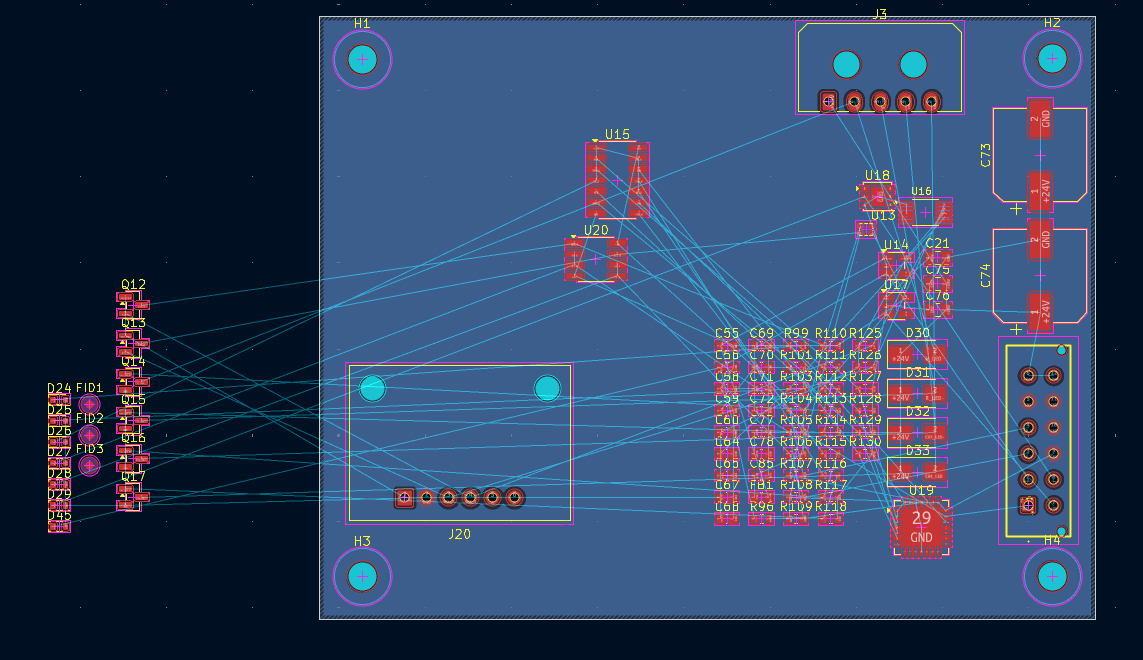
[picture p31: Documentation/Pictures/Journal_AJ/Image65.png]


---

## 25. Timelapse 30.10.2026

I am cooked...

The middle connection sector is so cramped up that i might not even have a functional PCB anymore...

There is a high chance of a rework on that part because EMF and signal integrity is going crazy rn.

Anyways i have placed 99% of the components.

---

**What i did:**

- Placed every chip on the PCB
- Finished 99% of the peripheral wiring
- Realised that i cramped up too much

---

**Problems that i had:**

- Its lowkey so complicated for a highschooler idek if this works
- TOO MUCH WIRRINGGG

---

**Whats next:**

- Finish off the PCB
- And fix the connector sector
- Start the DRC

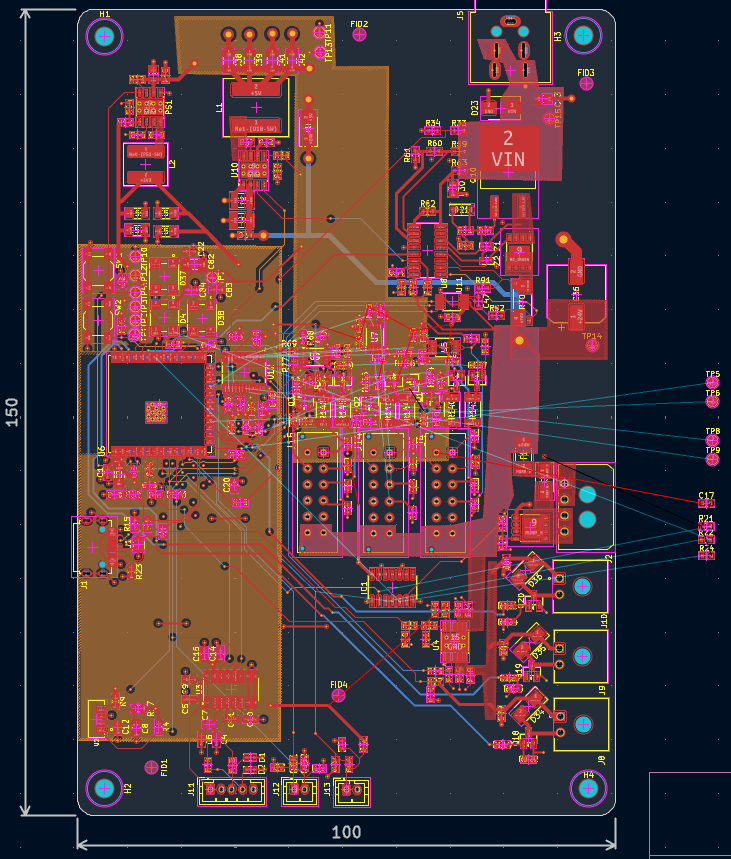
[picture p32: Documentation/Pictures/Journal_AJ/Image59.png]

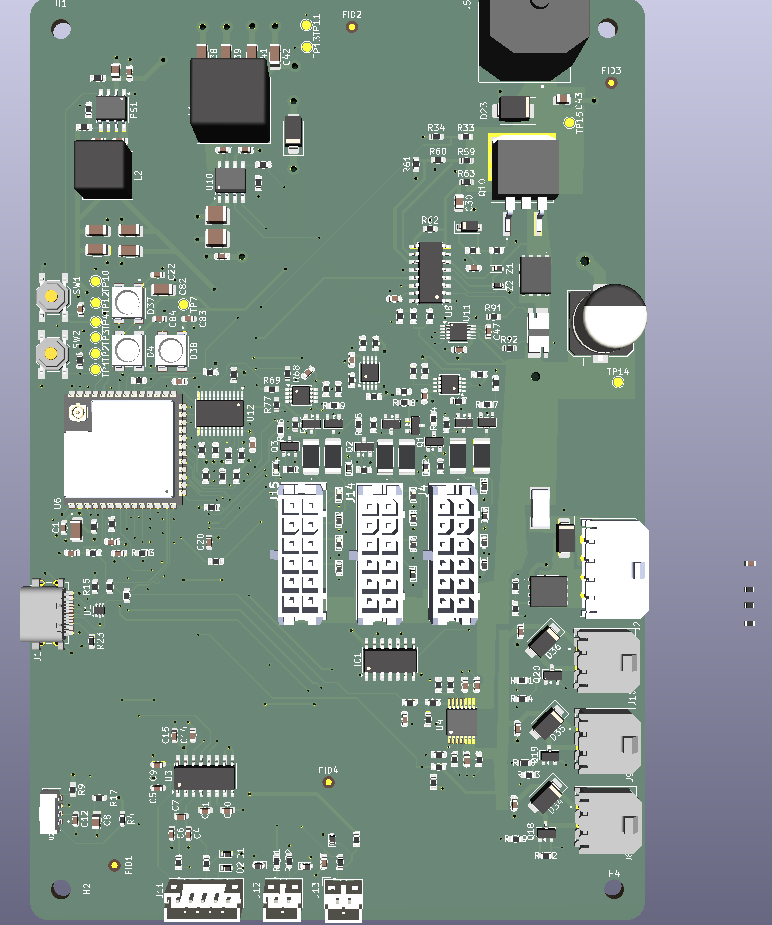
[picture p33: Documentation/Pictures/Journal_AJ/Image60.png]

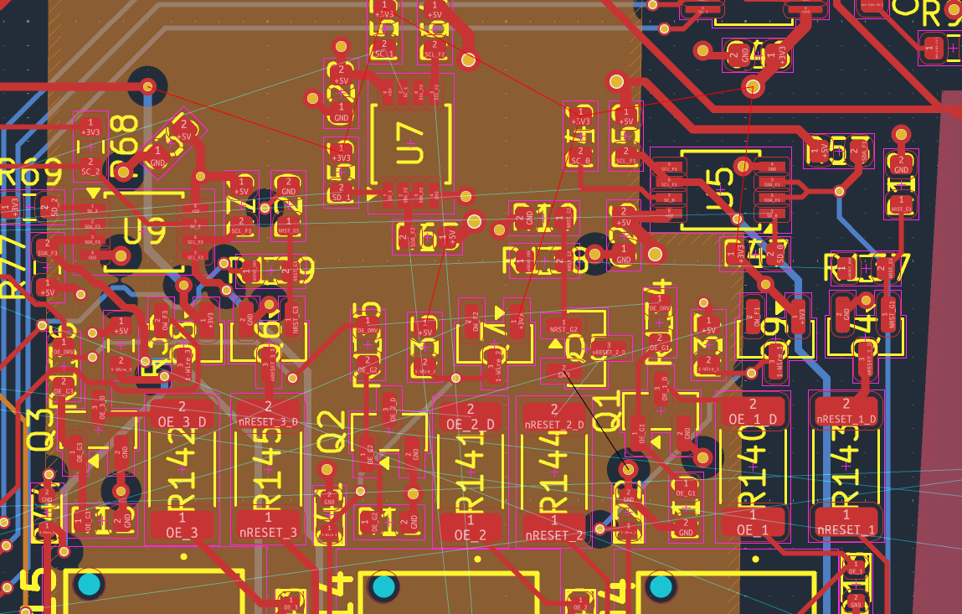
[picture p34: Documentation/Pictures/Journal_AJ/Image61.png]


---

## 24. Timelapse 28.10.2026

I might be cooked.

So i continued my work on the PCB and im very close to the finish but i might be far from finishing :(((

The middle section with the controllers got SOOOOO CRAMPED UP. Also the fact that it is so close to the +24V fill is scaring me.

---

**What i did:**

- Fixed USB_D-/USB_D+ wiring
- Added a couple GND vias for return current
- Continued workig on the connector sector
- Moved arounda couple of sectors so that i get more space

---

**Problems that occured:**

- Not enough space on the middle section of the board
- Possible signal integrity errors
- Via under pad issues

---

**Next step**

- I hope that i finish the PCB this week so that atleast i can fix DRC
- Start firmware by next week

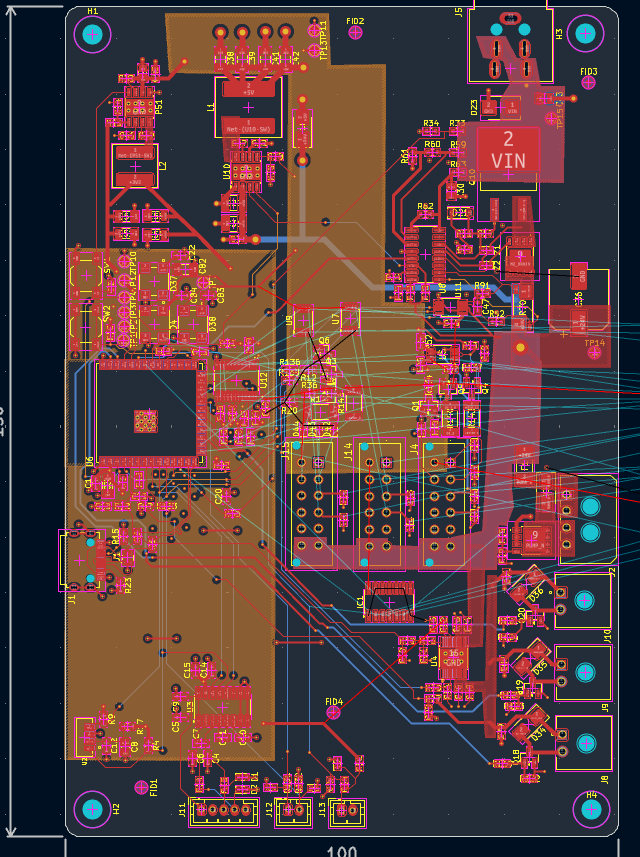
[picture p35: Documentation/Pictures/Journal_AJ/Image57.png]

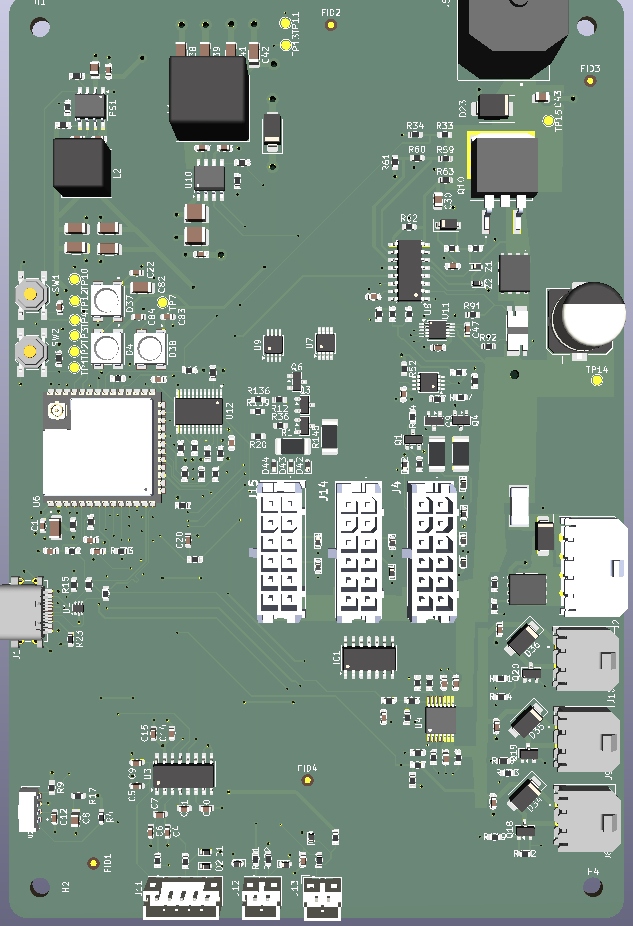
[picture p36: Documentation/Pictures/Journal_AJ/Image58.png]


---

## 23. Timelapse 23.10.2026

HOLLY LOCK IN... I had to stretch out before starting to write the journal xDDD

I had to grind out the remaining hours for this week because i wont be able to do them on the weekend and thats why i grinde out almost 5:30 hours in one day and it was hella productive.

I  am almost done with the PCB also!!! I just need to finish off the floor connector section in the middle and its done!

At the end tho it really started to get messy and i had to start doing some rookie mistakes because room around the MCU is really running low like i am going insane from connecting tracks. I'VE CONNECTED 1022 TRACKS SO FAR AND IM STILL NOT DONE.

---

**What i did:**

- Finished +24V Sector
- Finished +5V/+3V3 Sector
- Finished Actuator Sector
- Finished Analog Sector
- Started Floor Connector and Bus

---

**Problems that i faced:**

- Im lacking free space around the MCU. I made a mistake by putting the LEDs and Switches too close which resulted into the lack of space for wiring and passive components which makes the upper part of the MCU a signal madness.
- The 24V sector is a bit scary also

---

**What's next:**

- Finish off the PCB. Considering that this is the first week of making the PCB im super excited that by next week i will finish the PCB and move on to firmware :))))
- Double check everything and DRC CHECKKKK. That will probably take 3-4 hours also but it is what it is i hope i am doing a good job for my future self.

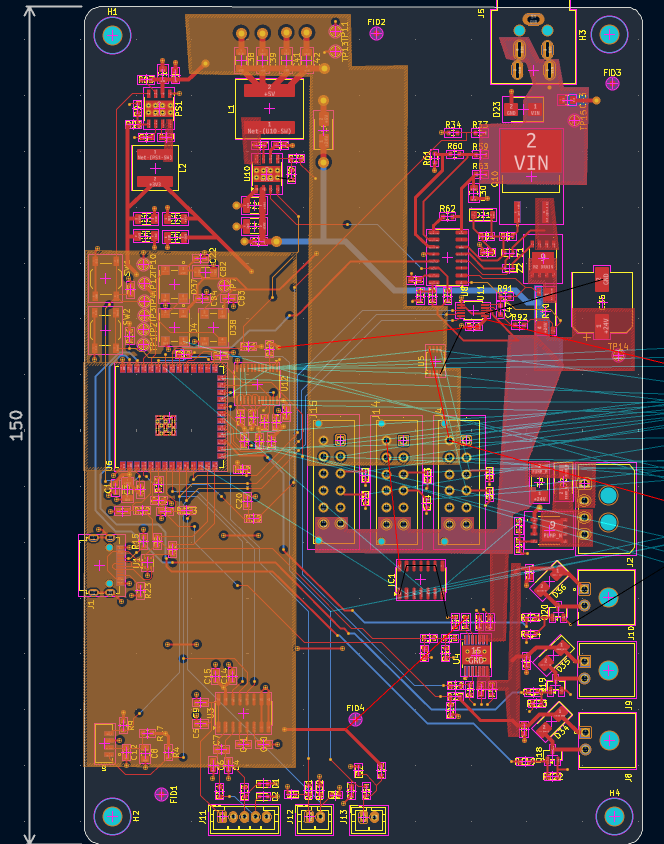
[picture p37: Documentation/Pictures/Journal_AJ/Image53.png]

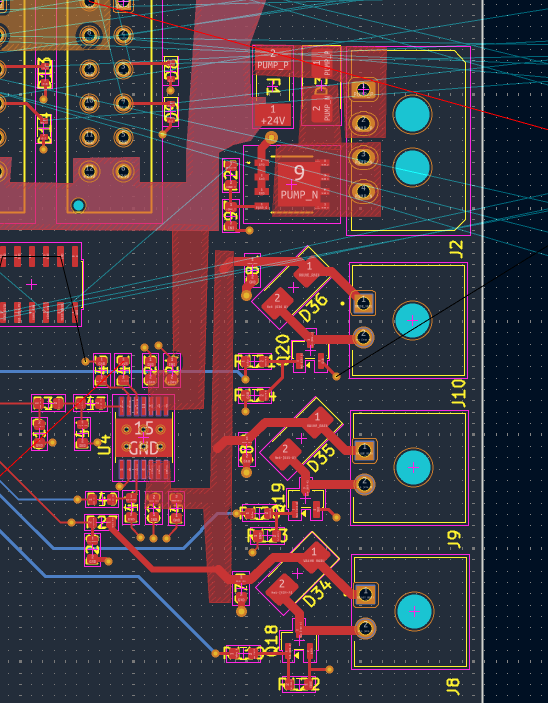
[picture p38: Documentation/Pictures/Journal_AJ/Image54.png]

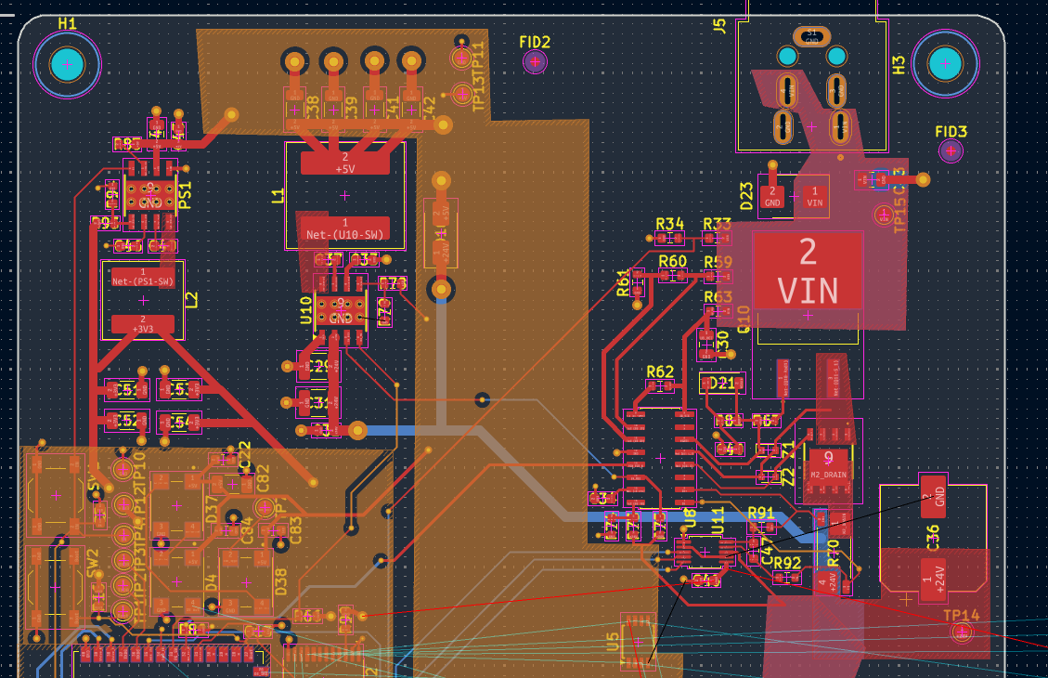
[picture p39: Documentation/Pictures/Journal_AJ/Image55.png]

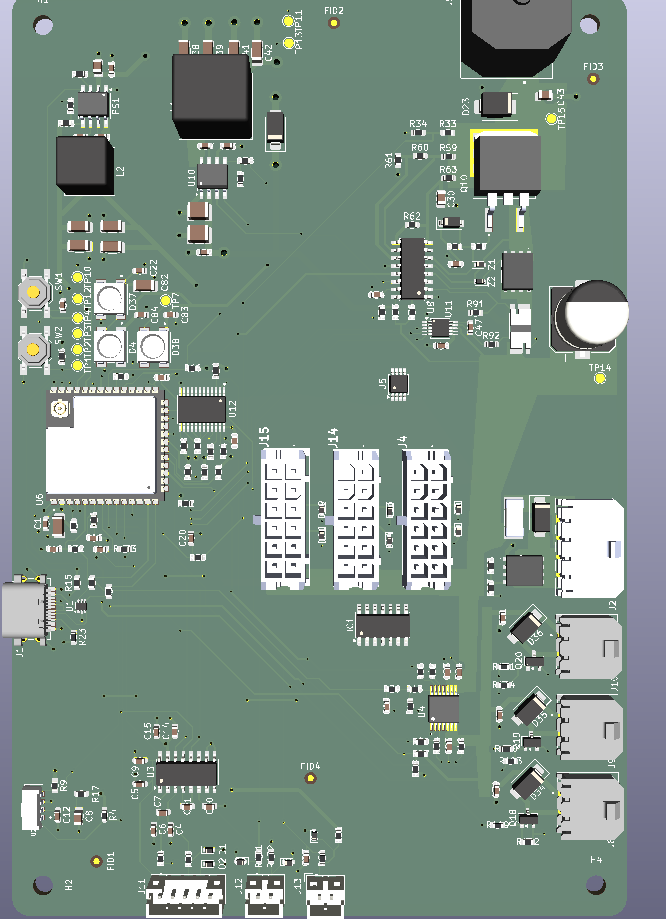
[picture p40: Documentation/Pictures/Journal_AJ/Image56.png]


---

## 22. Timelapse 22.10.2026

Made some nice progres if you ask me!

Finished the Analog section of the PCB and now i am headed onto the 24V input.

---

**What i did:**

- Implemented .step files
- Finished the Analog sector
- Started the VIN sector

---

**Problems that i've had:**

- A lot of wirringgggg
- A lot of mess has piled up around the MCU

---

**What next:**

-Continue working on the PCB :)

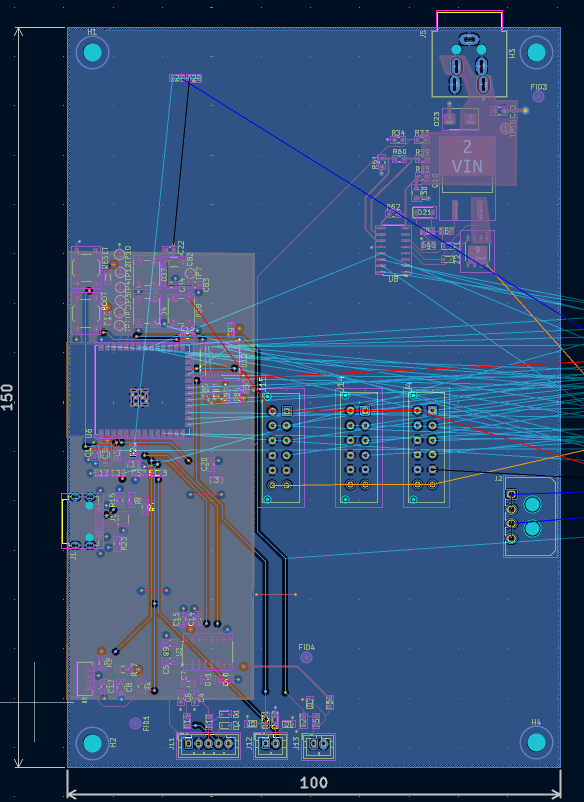
[picture p41: Documentation/Pictures/Journal_AJ/Image50.png]

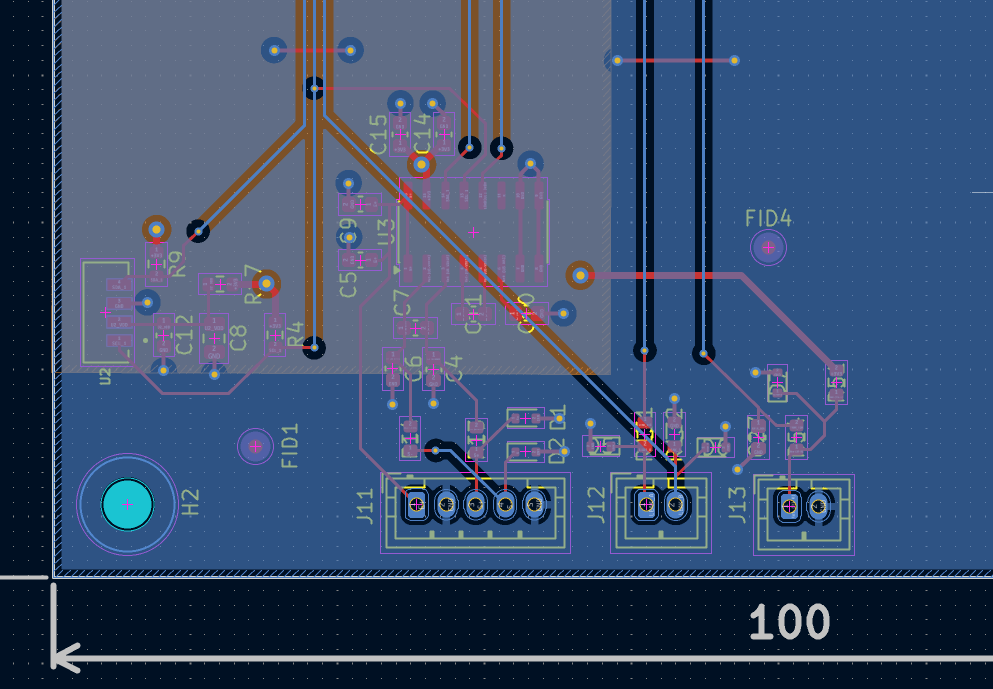
[picture p42: Documentation/Pictures/Journal_AJ/Image51.png]

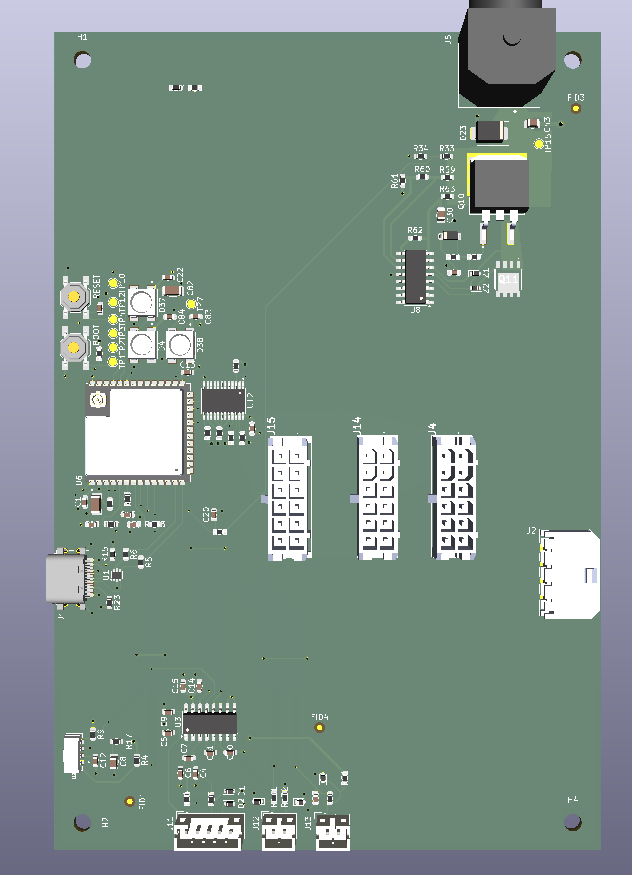
[picture p43: Documentation/Pictures/Journal_AJ/Image52.png]


---

## 21. Timelapse 19.10.2026

A fresh start in the new week.

The project is taking a sharp edge and is improving quickly considering of how easy it is to manage a nicely organized schematic into a PCB layout.

---

**What i did:**

- Placed components around the MCU area
- Defined fill zones in MCU region
- Connected their peripherals
- Inserted 3D .step files

---

**Problems that occured:**

- None tbh im just slowly grinding with music

---

**Whats next:**

- Continue with the grind
- Relocate to a different region on the board

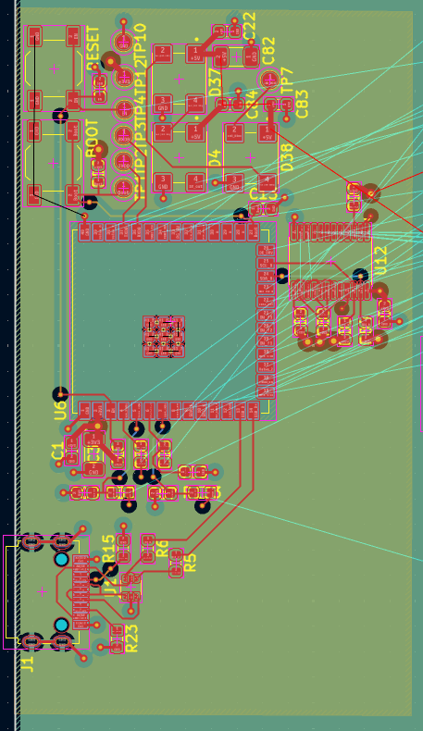
[picture p44: Documentation/Pictures/Journal_AJ/Image48.png]

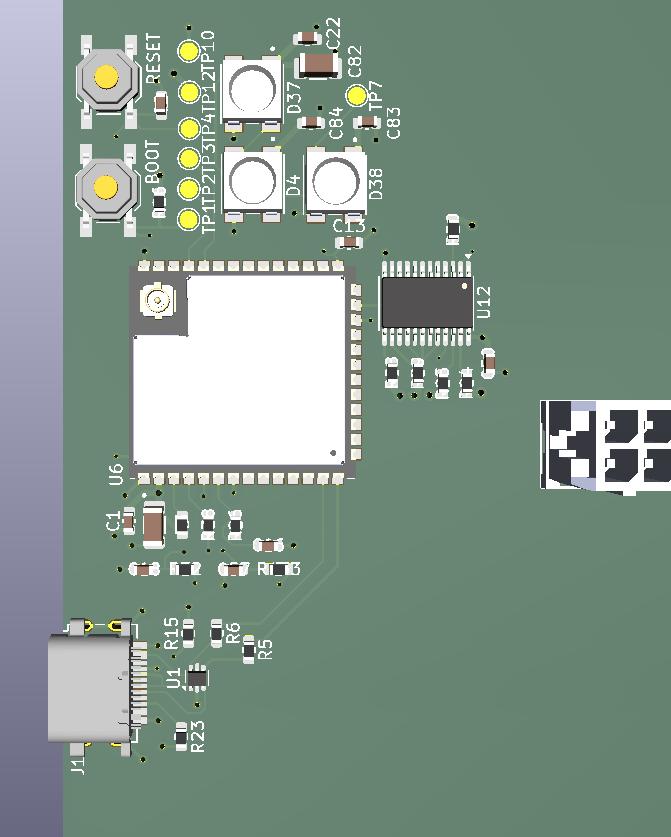
[picture p45: Documentation/Pictures/Journal_AJ/Image49.png]


---

## 20. Timelapse 18.10.2026

Quick one. My laptop crashed due to only having 8GB of ram and a lot of stuff running.....

That's why im participating in this ysws tho!!! Can't wait to see my Thinkpad X1 Gen 7 :)))

---

**What i did:**

- Component placement
- Established the USB-C wiring
- A little of 3D .step file imports

--- 

**Next step:**

- Continue the PCB around the MCU

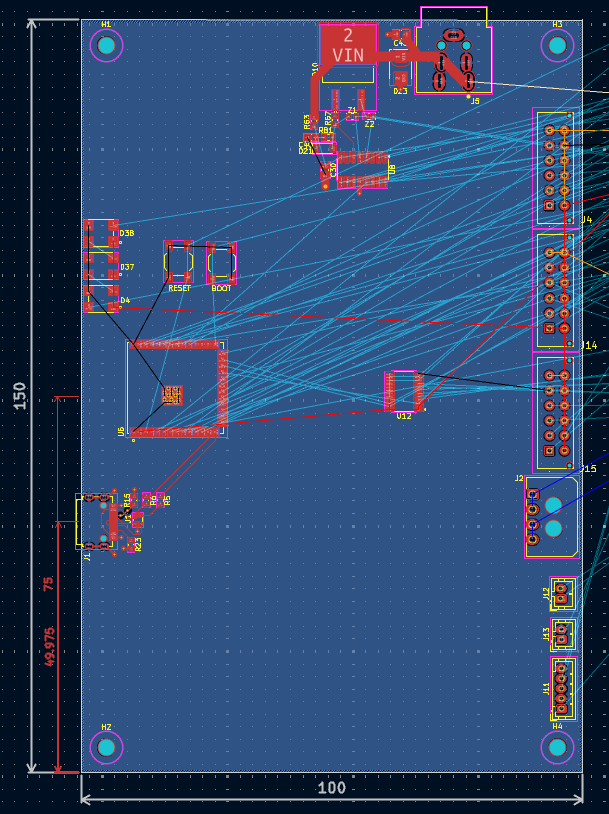
[picture p46: Documentation/Pictures/Journal_AJ/Image47.png]


---

## 19. Timelapse 17.10.2026

Grindy day!

I finally started the PCB!!!

After commiting the schematics i started the PCB and it is a headache...

850 PADS!!! That need to be connected will take a while.

---

**What I did:**

- Commit the schematic
- Started placing components on the PCB
- Occasionally assigned .step components
- Applied net classes and restrictions

---

**Problems that appeared:**

- The cost of producing the PCB increases a lot after 100x100mm but it is impossible to fit everything and keep signal integrity
- A lot of components that i need to place around

---

**Next step:**

-Continue with the PCB trenches

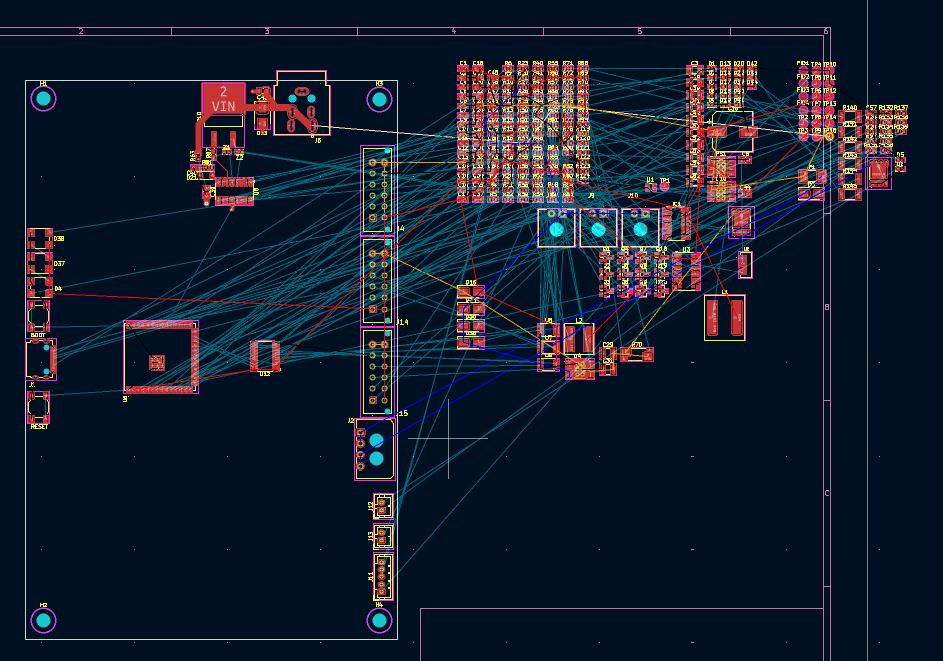
[picture p47: Documentation/Pictures/Journal_AJ/Image44.png]

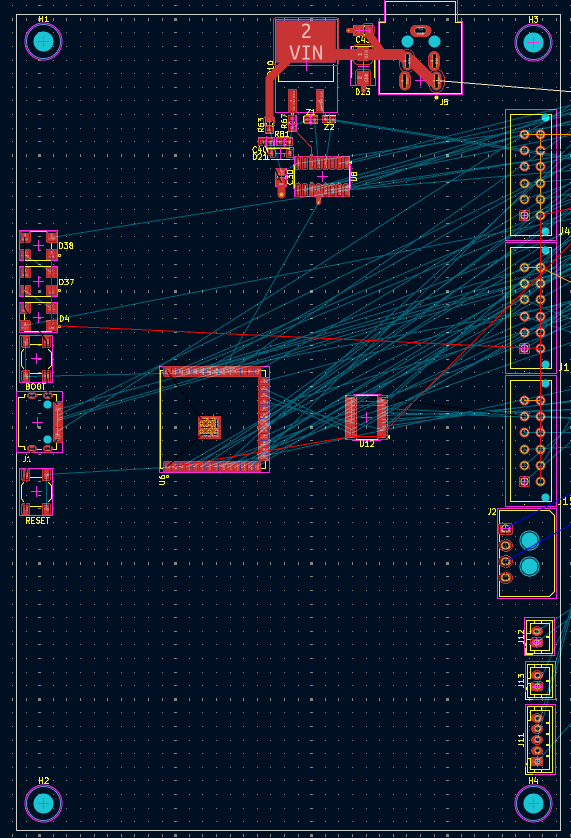
[picture p48: Documentation/Pictures/Journal_AJ/Image45.png]

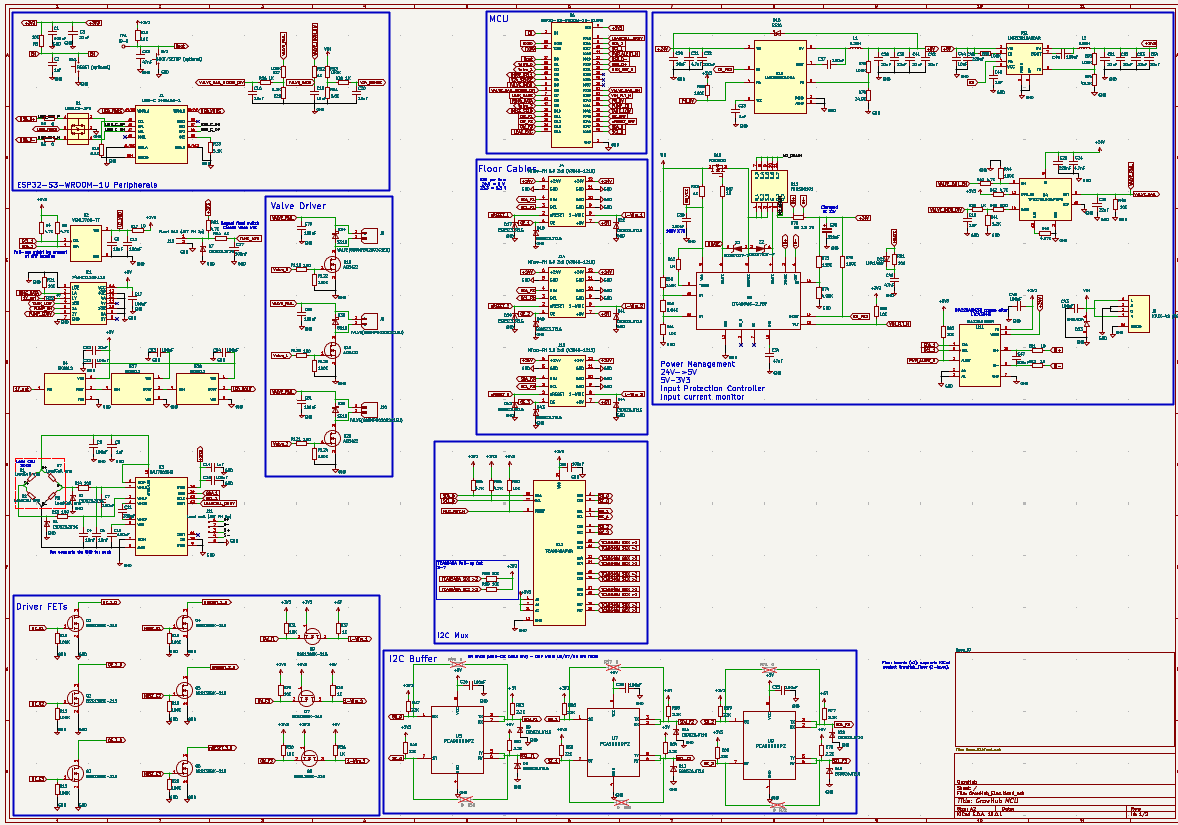
[picture p49: Documentation/Pictures/Journal_AJ/Image46.png]


---

## 18. Timelapse 16.10.2026

Im lowkey writting this while im outside at my grandparents house cuz i want to get 5 hrs of timelapse today and im running llow on time xDDD

I also timelapsed yesterday but after having a break my laptop went asleep, booted it up again and when it loaded up i came to the information that my wifi module stopped working. I wasted an hour trying to fix that and today i am back on track for this week.

Today I revised once again the schematic due to an experienced friend of mine who reviewed my schematic before starting the PCB. A lot of it got fixed and honestly without his help it wouldnt even been possible to make a functional PCB. He studies on University of St. Kiryl and Metodii so that is his speciality.

And mid work i realise that i forgot to turn on timelapse so RIP 30 minutes....

---

**What I did:**

- Revised the schematic
- Fixed errors
- Grouped modules
- Sorted the schematics
- Added another sheet for utilities on the PCB

---

**Problems that i had:**

- A lot of numbers my eyes started twitching
- A lot of mistakes :(((

---

**Next step:**

- ERC Check
- Start the PCB
- Make a clear border on the main PCB for signal integrity

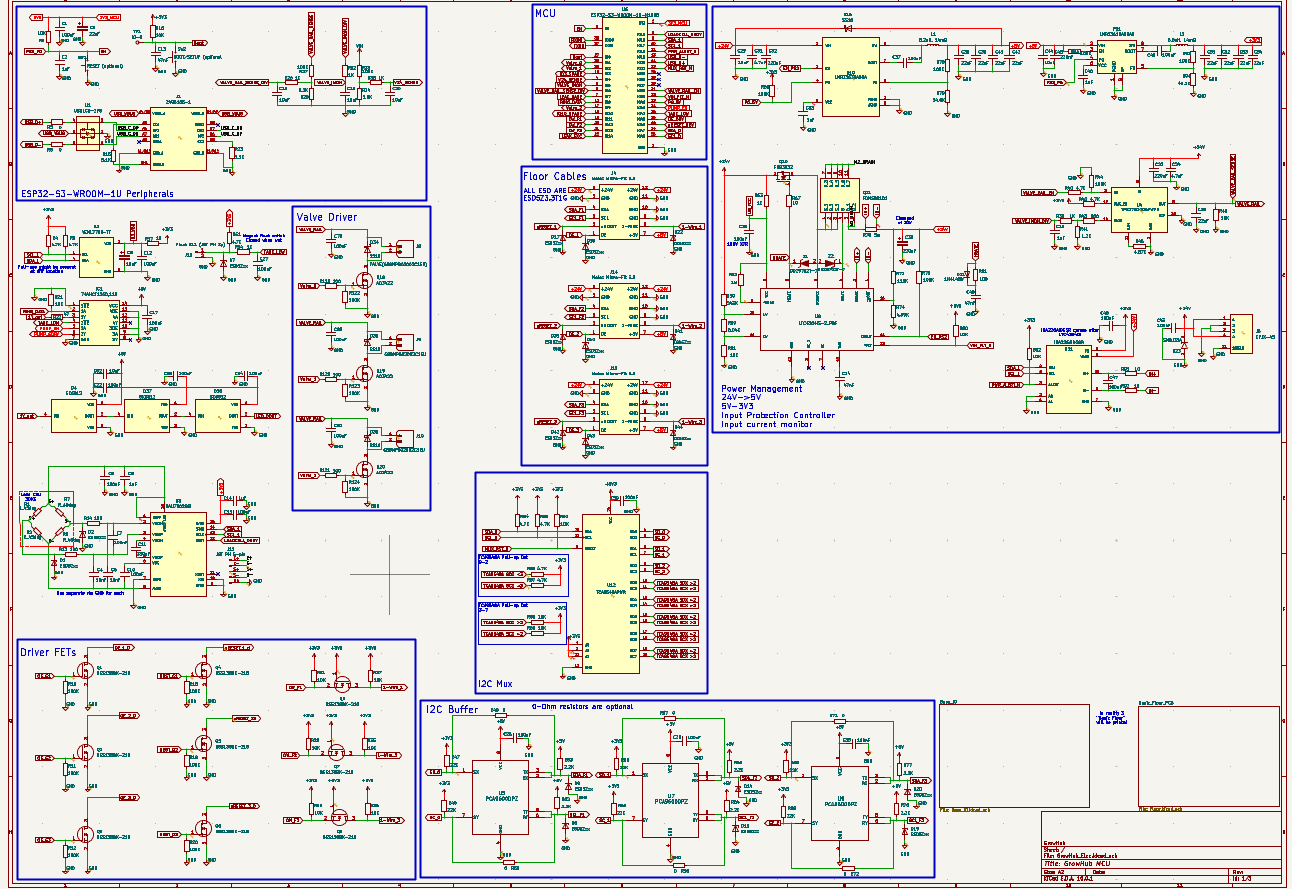
[picture p50: Documentation/Pictures/Journal_AJ/Image41.png]

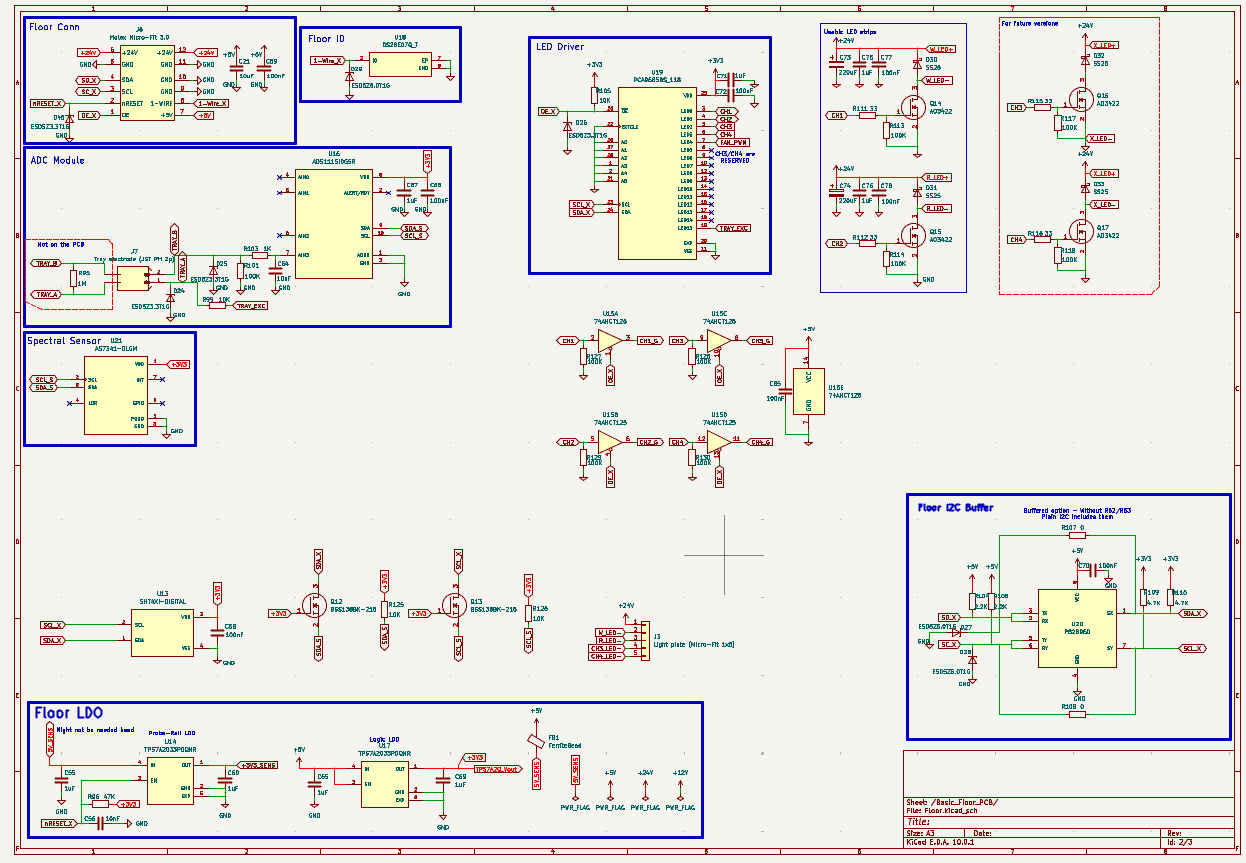
[picture p51: Documentation/Pictures/Journal_AJ/Image42.png]

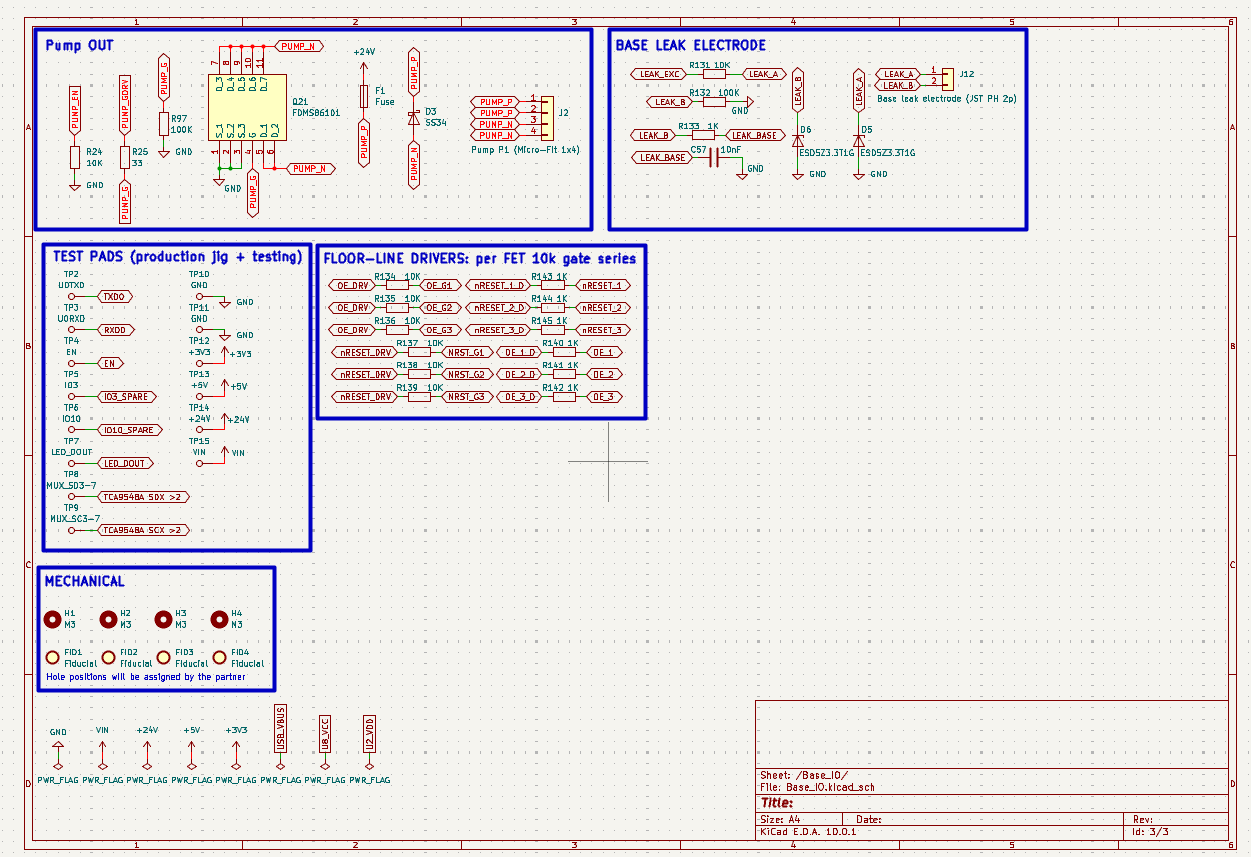
[picture p52: Documentation/Pictures/Journal_AJ/Image43.png]


---

## 17. Timelapse - 11.10.2026

I FKIN HATE MYSELFF

So basically i was doing my work as per usual and i decided to write in the README for a bit just so that i can update it. But i opened 2 github windows and not realising i closed the one in which i was writing it.... I LOST MY WORK WITHOUT COMMITING. It wasnt a lot of work but that is such a tedious work and i dont wanna think of doing it again.

---

**What i did:**

- I finished the schematic
- We changed the schematic according to a hydroponic lifestyle
- And finished everything except the last 2 MOSFETs which i need to research a bit but i dont have the time anymore for this week.
  
--- 

**Problems that i've had:**

- Well the fact that i had to change a lot of components due to the watering system.
- And my stupidity of closing the wrong window causing me to waste my time.

---

**What's next:**

- Well now i am prepared to start the PCB
- Start the PCB :)

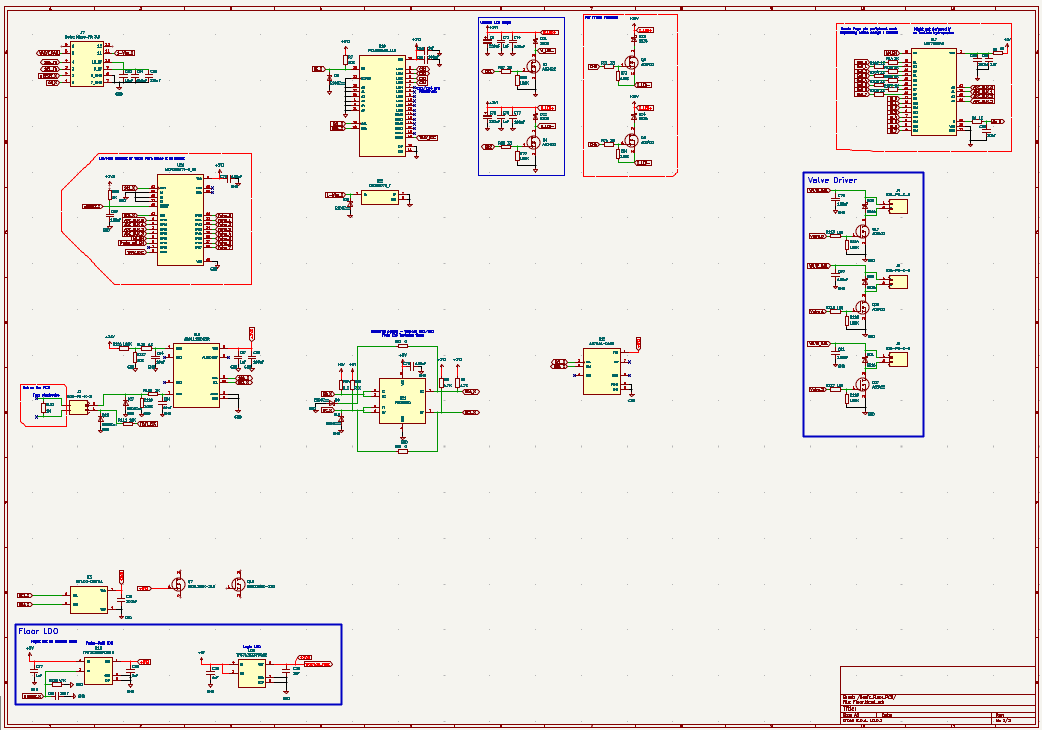
[picture p53: Documentation/Pictures/Journal_AJ/Image39.png]

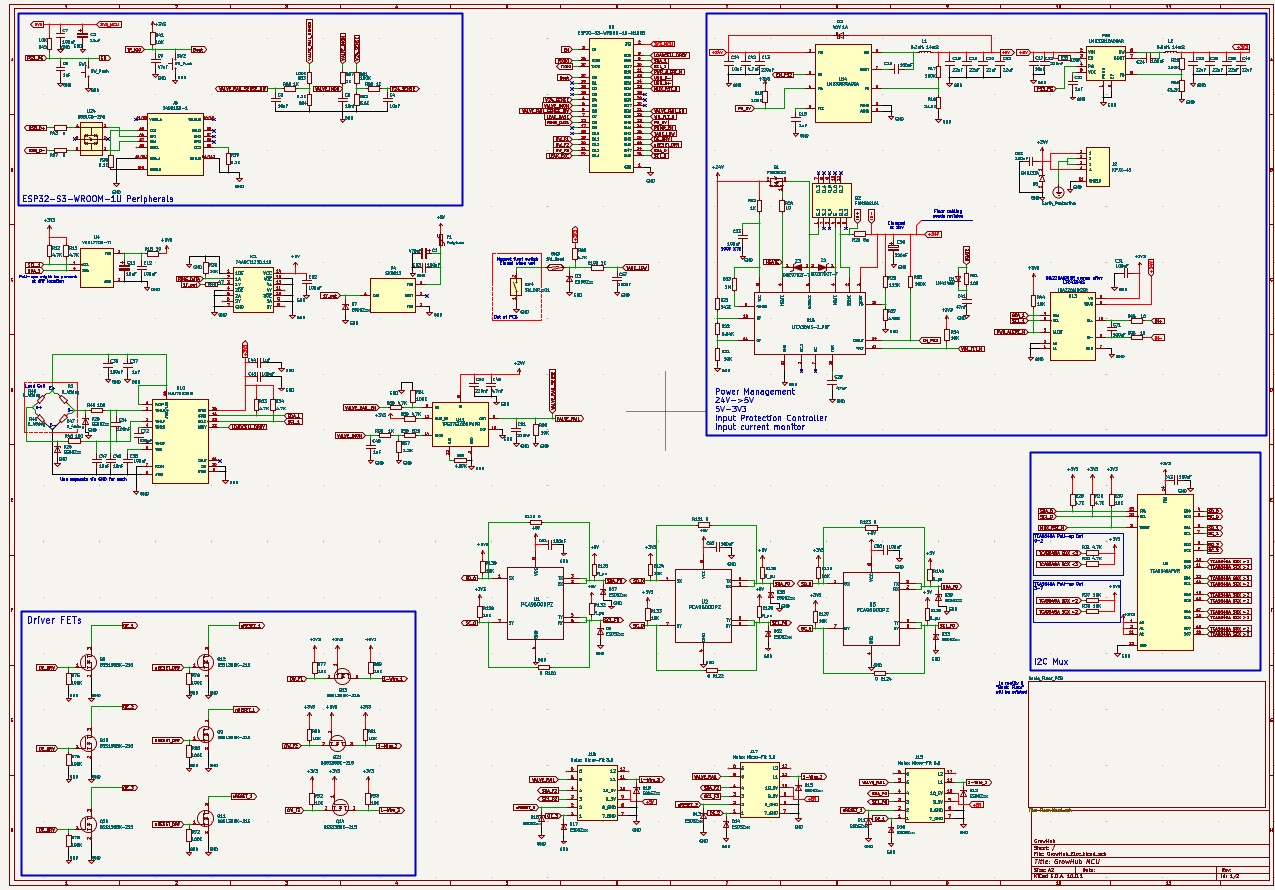
[picture p54: Documentation/Pictures/Journal_AJ/Image40.png]


---

## 16. Timelapse - 10.10.2026

Holy lock in... I just did 5 hours of timelapse on a normal day and its still 6PM!!! Now i lowkey have my whole afternoon free and i also finished 99% of the schematic and double checked everyhting. Thats sound that by tomorrow i will probably start the PCB as expected :)))

---

**What i did:**

- Soo i placed every single component needed and locked it in
- I finished every peripheral schematic
- I connected 99% of the component with each other
- I also started organizing the schematic so that is easier to review

**Problems that i had:**

- none :)

---

**Next Step:**

- I need to discuss with my partner whether we keep soil based tiling or hydroponics. If we adopt hydroponics then a lot of changes will be needed with the valve regulation...
- I need to finish that 1% on the schematic
- And if i am done with all of that i will prep the PCB for Week 5

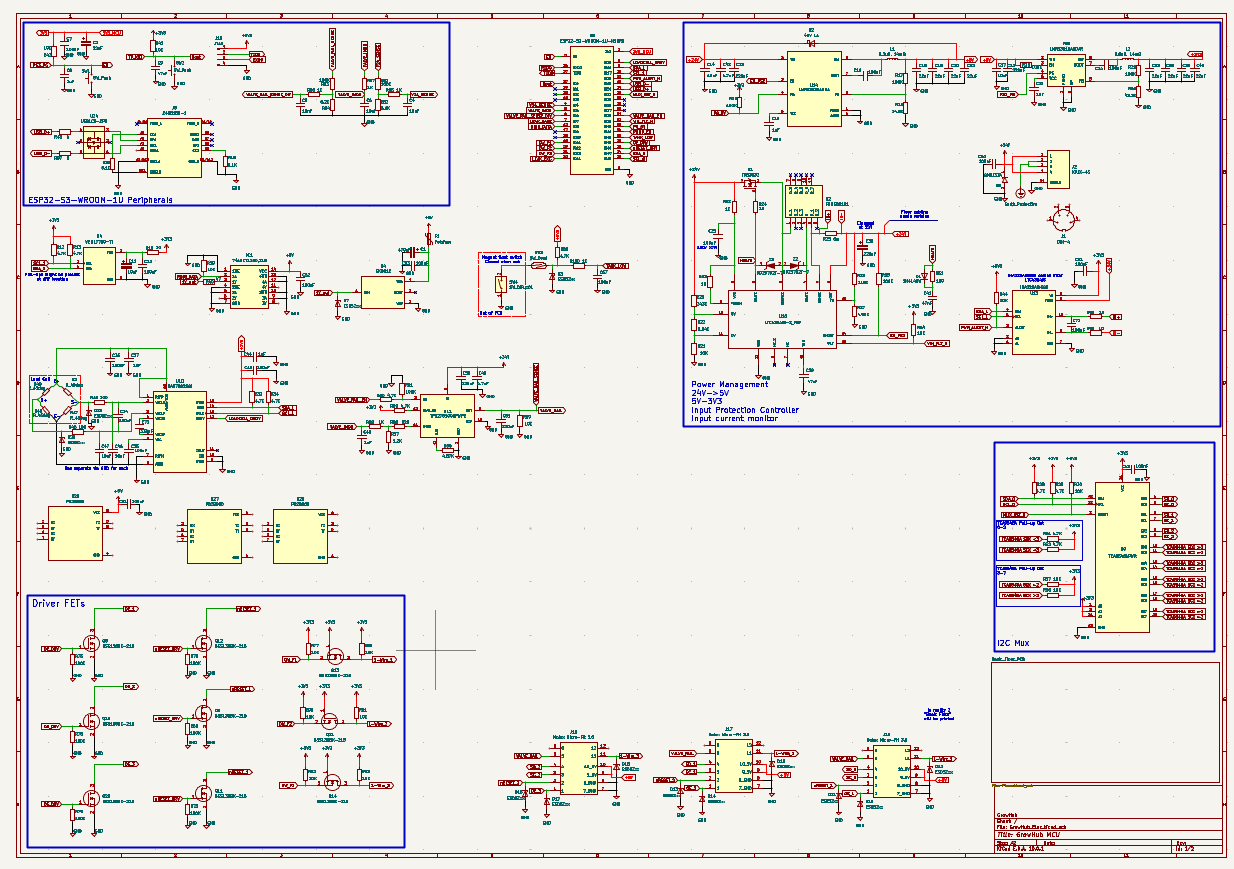
[picture p55: Documentation/Pictures/Journal_AJ/Image37.png]

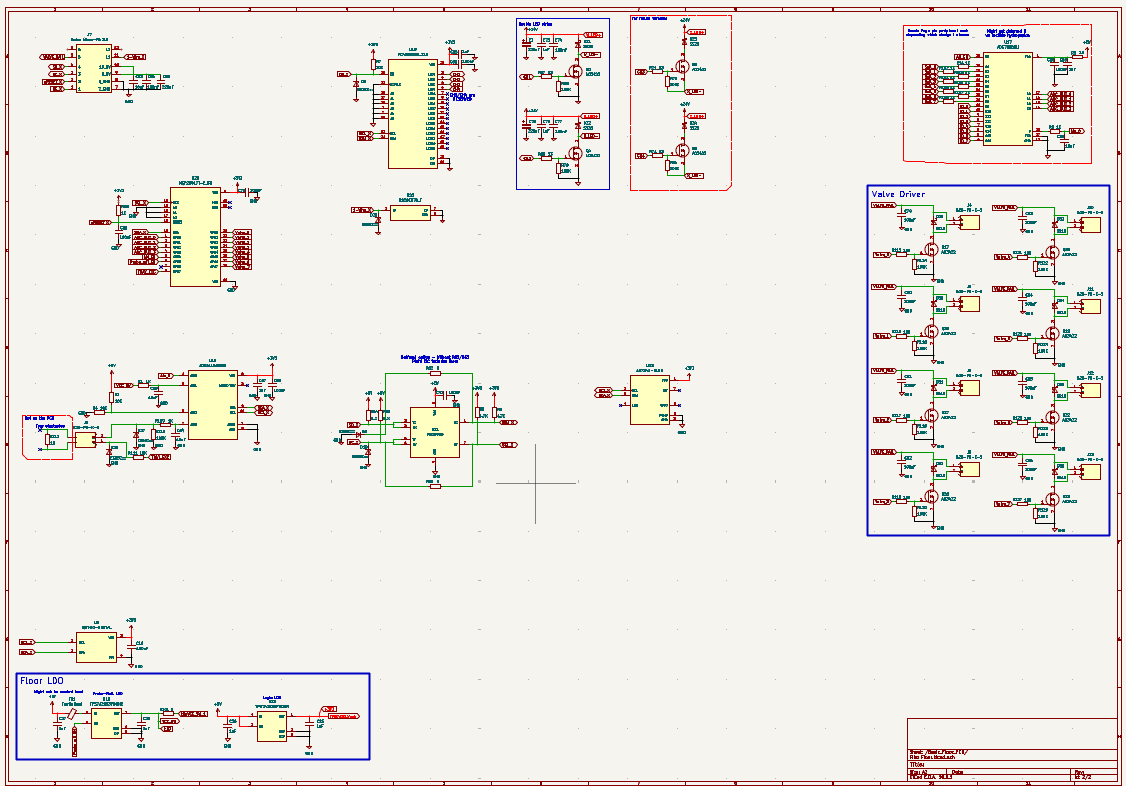
[picture p56: Documentation/Pictures/Journal_AJ/Image38.png]


Only 2 pictures but if you compare them to the previous day you could see that a lot has been changed.

--- 

## 15. TImelapse - 09.10.2026

Long time no see.... I had some personal issues both with my laptop and also other stuff that made me start this week all the way in Friday :/// Now i need to do atleast 11 hours by the end of Sunday. I hope that i am gonna achieve that because I am invited to 2 birthday parties.... Thats amusing right, IM GONNA OBLITERATE MYSELF.

Personally i think expressing my rage in journal is a fun thing if somebody ever decides to read it.

Anyways in this timelapse i FINALLY found the right MOSFETs and i started working on that logic section about the valves and LED control.

---

**What i did:**

- I had to make the main board schematic an A1 paper
- Added the needed MOSFETs
- Included other peripherals

---

**Problems that i've had:**

- Lagging on my PC which disrupted my work a couple times
- The schematic is getting messy now that i need to finalise everything

---

**Whats next:**

- I just need to finish off the connections on main board
- Finish off peripherals on Floor board

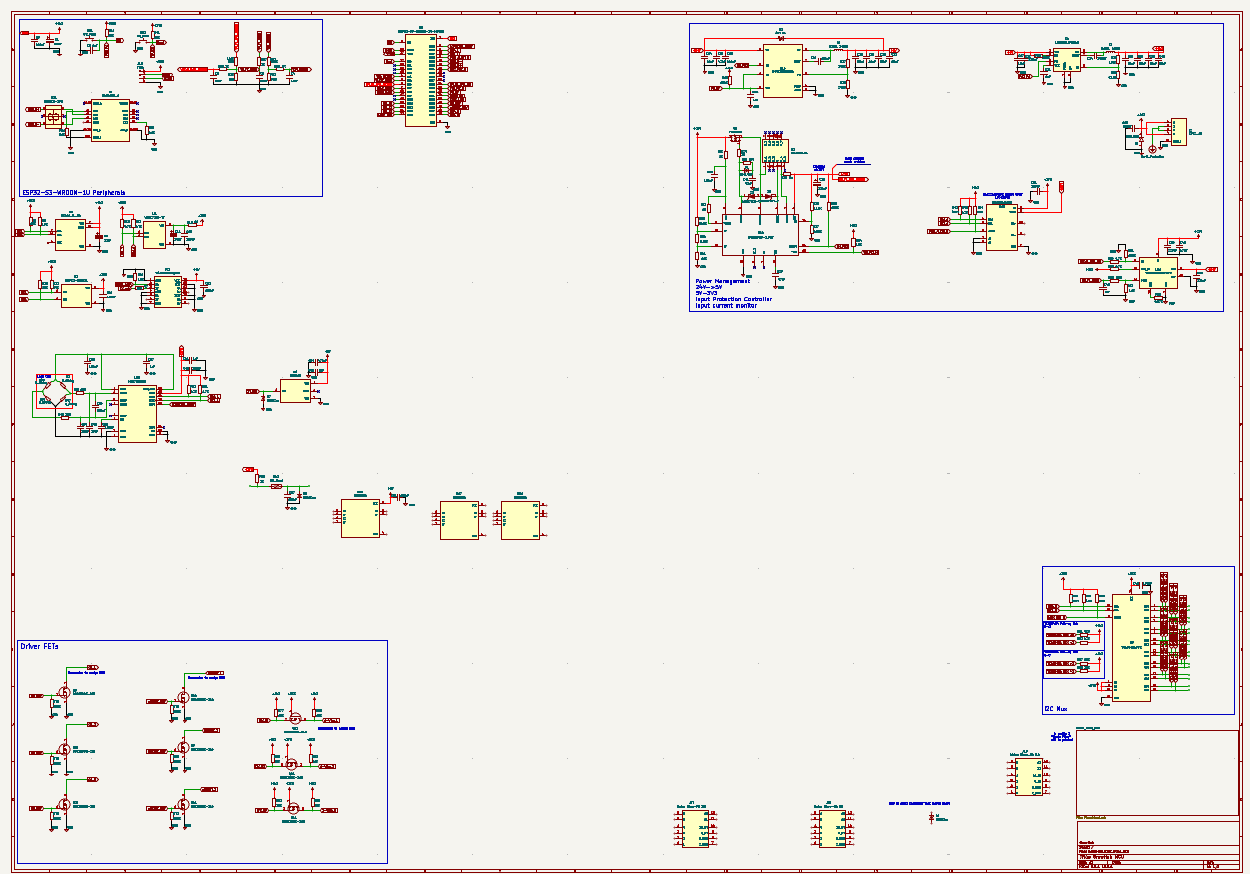
[picture p57: Documentation/Pictures/Journal_AJ/Image34.png]

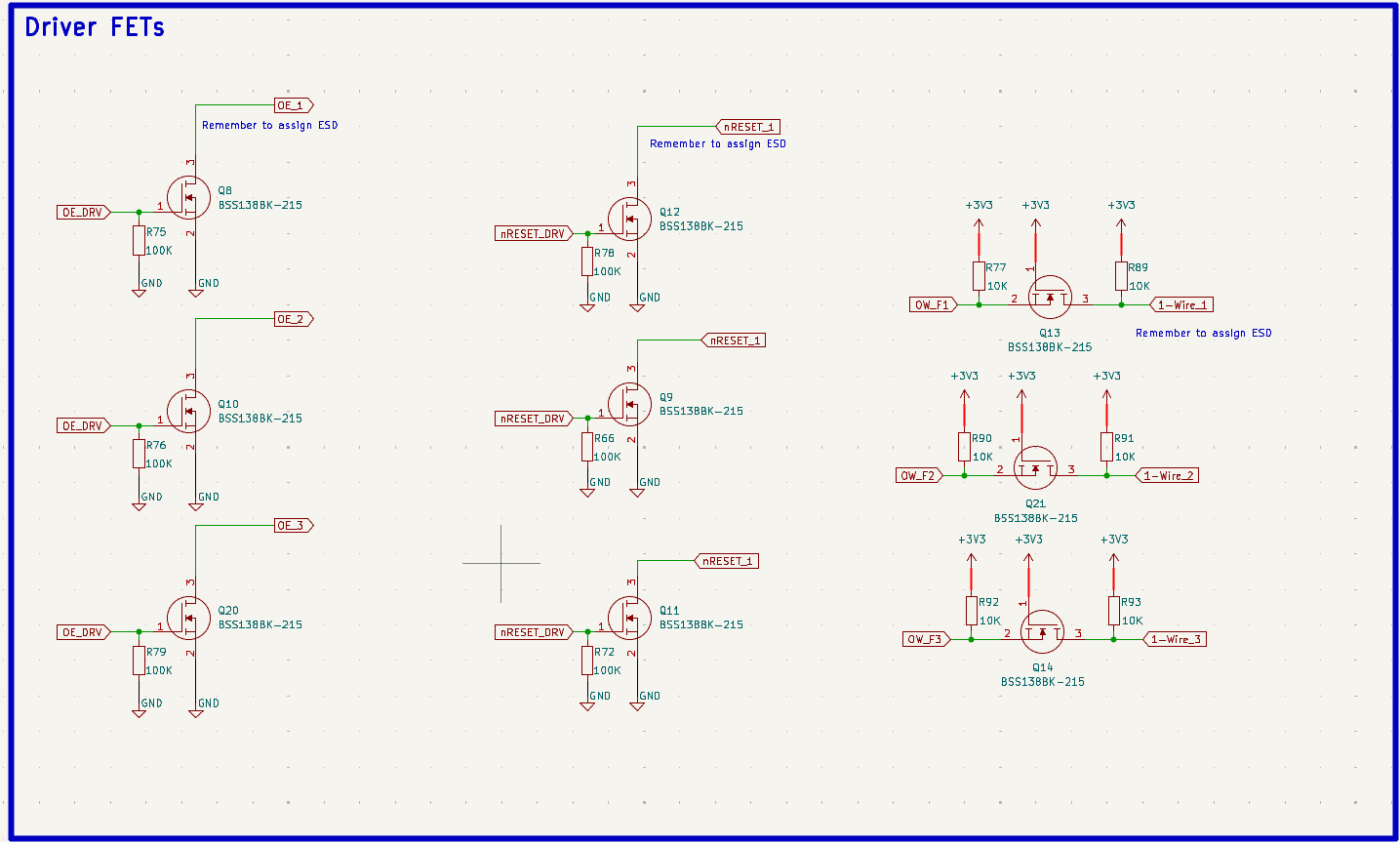
[picture p58: Documentation/Pictures/Journal_AJ/Image35.png]

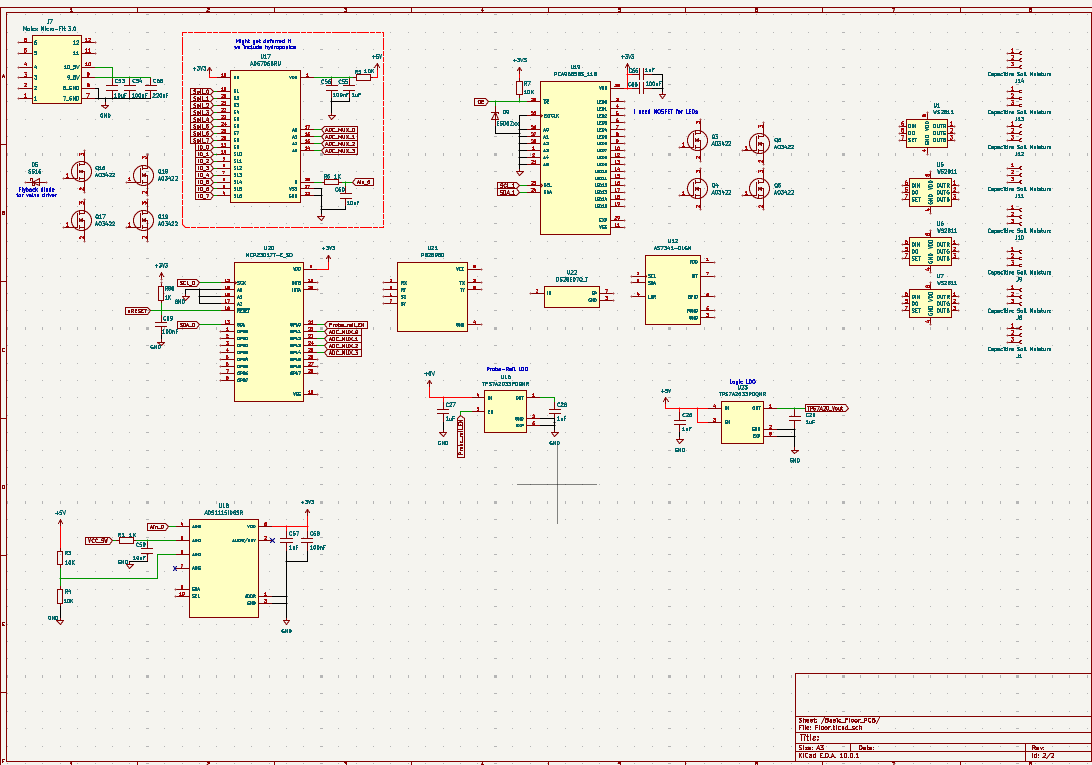
[picture p59: Documentation/Pictures/Journal_AJ/Image36.png]


---

## 14. Timelapse - 04.10.2026

Finally finished my tournament and came back home to sleep and go to school in the different city tomorrow again... Anyways i tried making some hours from my laptop and i managed to fix some previous confusions about powering this project. Also me and my partner are thinking of changing the path of this project towards hydroponics meaning i might remove some components.

**What i did:**

- Fixed the powering input confusion
- Finalised power management sector
- Added more peripheral components

---

**Problems that occured:**

- Nothing pretty much except the touchpad on my laptop that made me slow

---

**Next Step:**

- I'm kinda mad at myself about the fact that i didnt finish the schematic this week but i think its understandable because some parts are really confusing to me as a student who is not a real engineer and tries to make this complex monstrousity.
- I really need to finish the schematic next week.
- I also need to assign every single MOSFET im missing a lot of them

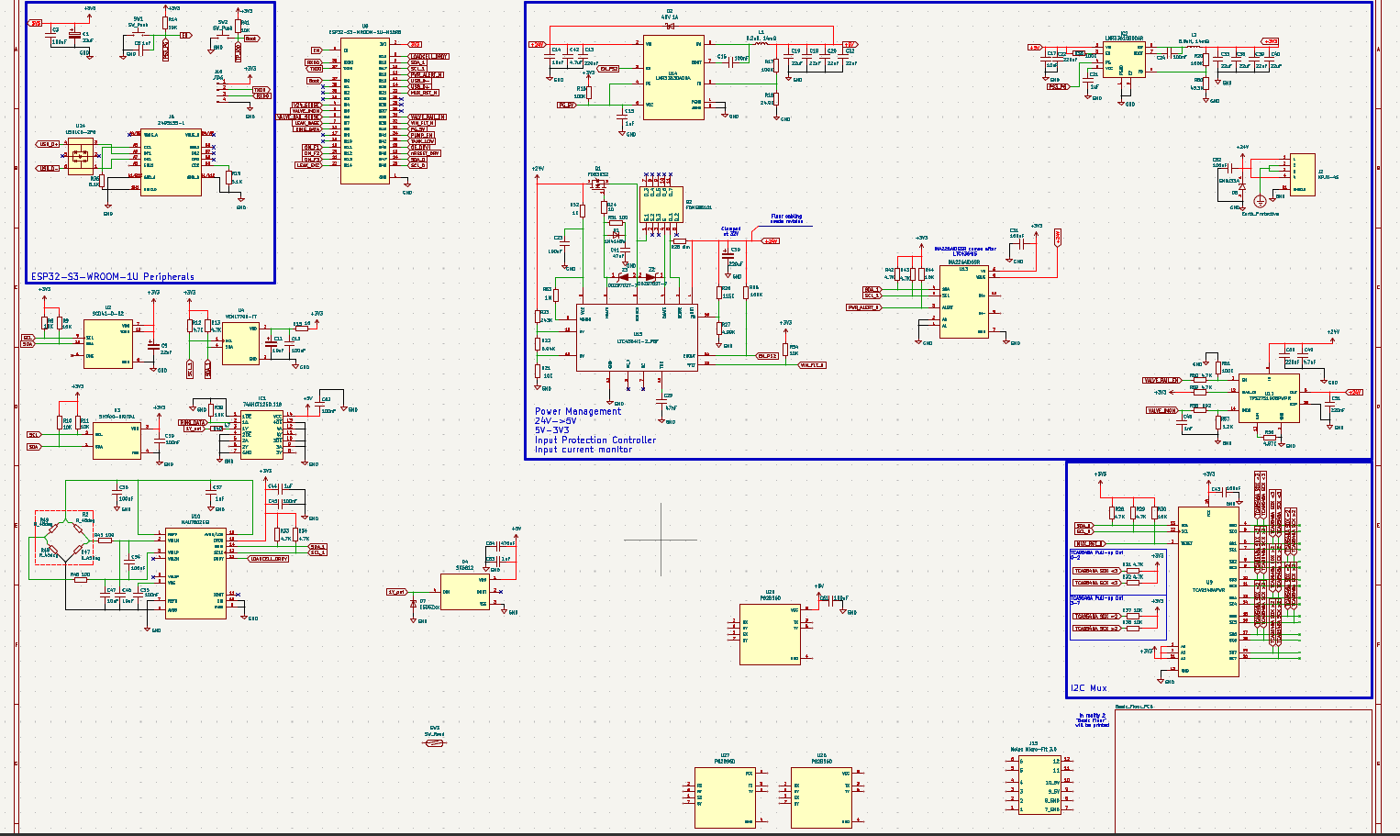
[picture p60: Documentation/Pictures/Journal_AJ/Image32.png]

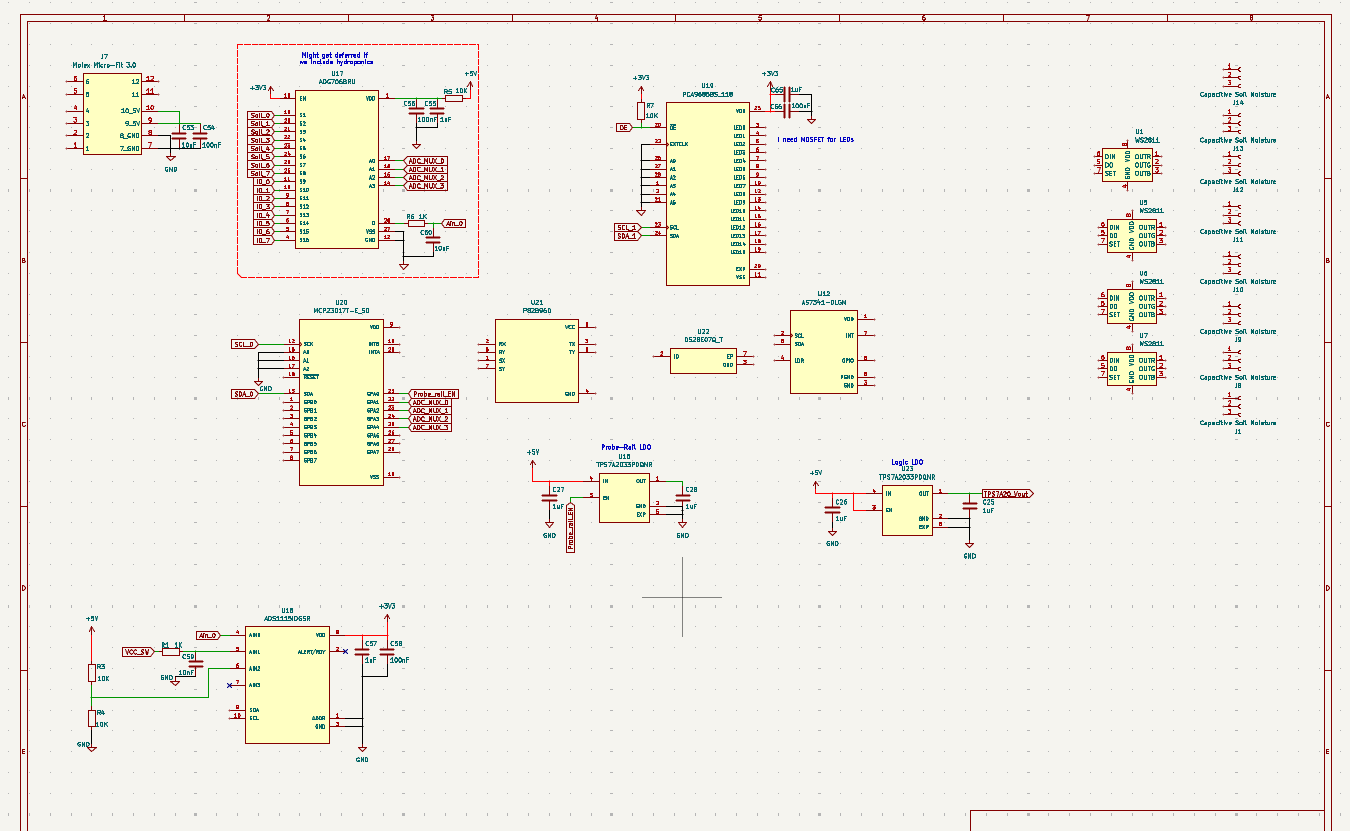
[picture p61: Documentation/Pictures/Journal_AJ/Image33.png]


---

## 13. Timelapse - 02.10.2026

Once again i am timelapsing late and sleepy but now with even worse condition and that was a bad WiFi....... I lowkey crashed out a couple times because the timelapse was running slow due to low internet connection and not being able to open anything. I did get a couple stuff sorted out tho :)))

---

**What i did:**

- I finally found good connectors. Honestly i had to search for them without timelapsing because i just couldnt find the appropriate one without taking too much time on timelapse.
- Improved the LDO for my basic floor.
- Added more wiring connections
- Added more peripherals

---

**Problems that i had:**

- The WiFi issues were SOOO ANNOYING. I hope that isnt a problem even though at the start it is super noticable that i ahd issues with loading pages.
- Because i am travelling its super hard for me to work like i am so tired.

--- 

**Whats next:**

- I think by the end of week i will have 90% done of the schematic which is amazing so that next week i can start the PCB as planned.
- We need to define the final way of water sourcing the floors and also to decide whether its hydroponics or basic watering system.

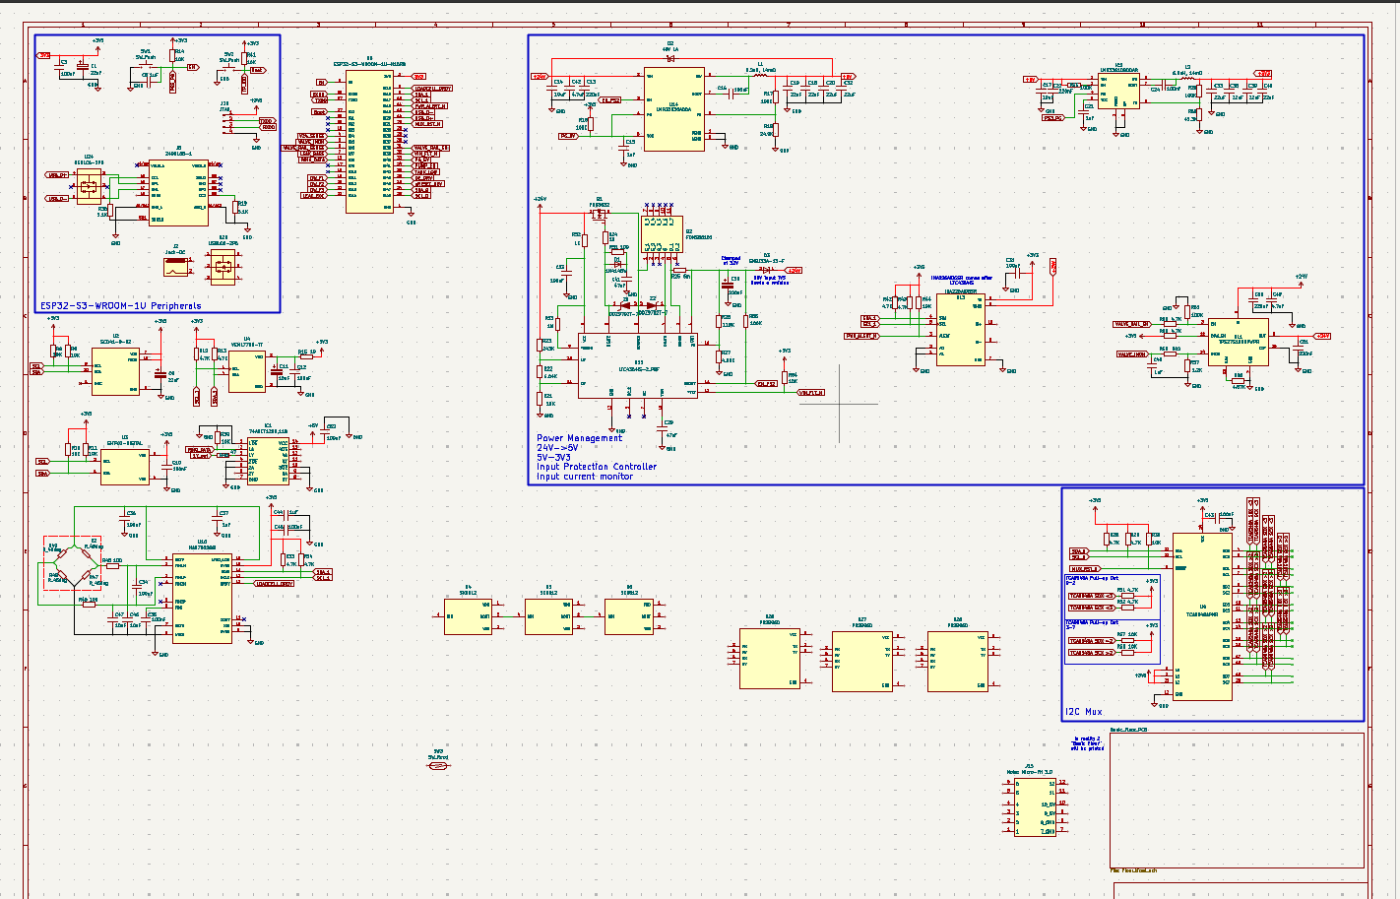
[picture p62: Documentation/Pictures/Journal_AJ/Image30.png]

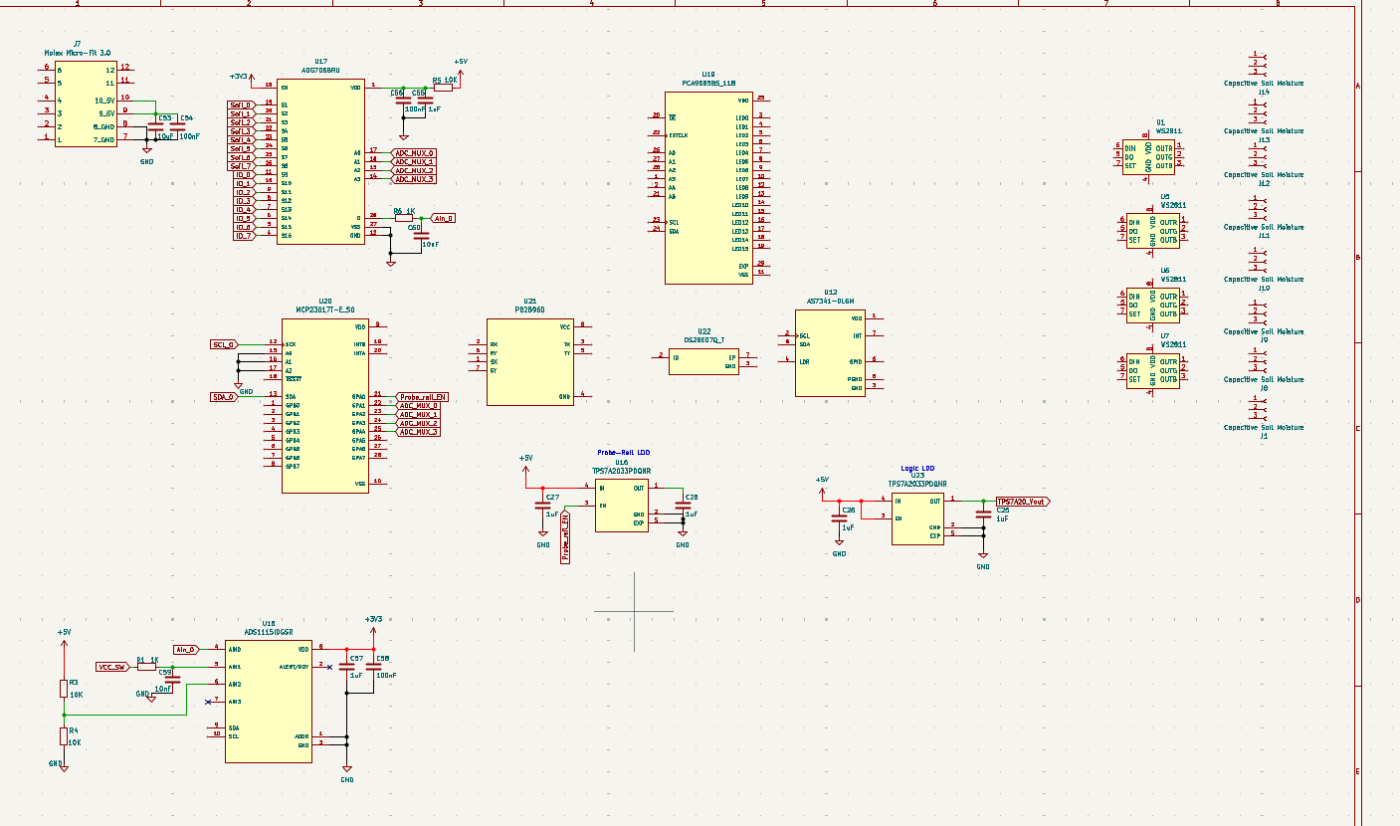
[picture p63: Documentation/Pictures/Journal_AJ/Image31.png]


---

## 12. Timelapse - 01.10.2026

Im soooo sleeeepy.... I mightve zoned out while timelapsing so i must rewatch my timelapse and edit it. Anyways i did a couple stuff today and in particular i nit picked a couple more components for the project and added other new peripheral components. The work is really repeatable but i must do it now and not in the PCB construction process.

I also FINALLY ASSIGNED the MCU pins. That way i can more clearly and easily wire other modules.

---

**What i did:**

- Assigned the whole MCU pinout
- Added a couple components
- Added their peripheral components

---

**Problems that i had:**

- Figuring which schematic to follow for my MCU
- I am super sleepy and its past 1AM (3 hours past my bedtime) so pls dont get angry on my jetlagging while reviewing.

---

**Next step:**

- Im getting very close to finishing off the main board so i should aim to close that task
- Overall finish the schematic

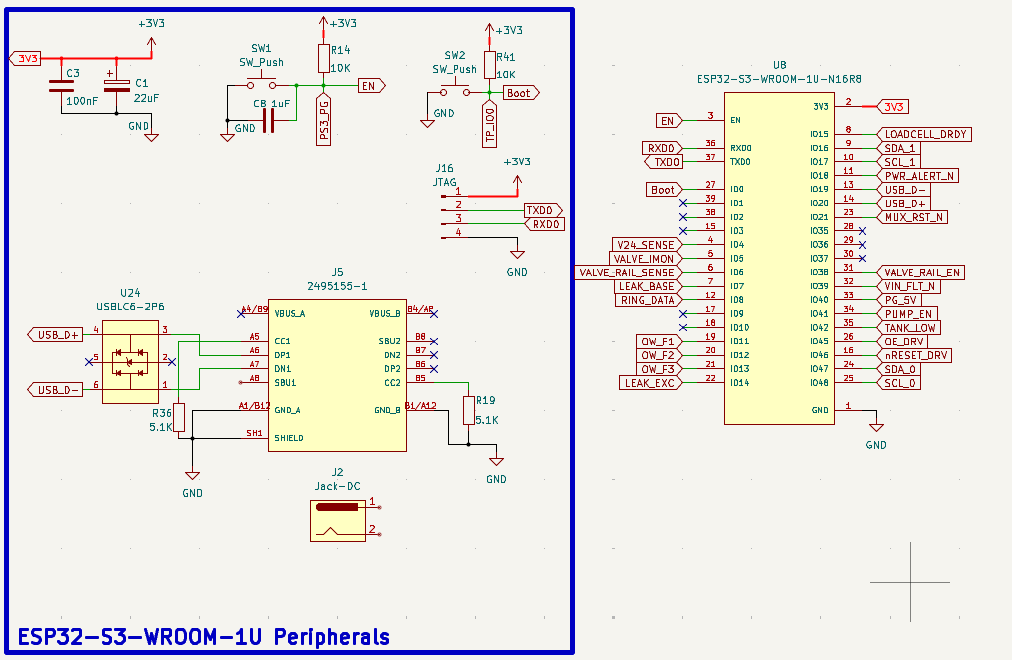
[picture p64: Documentation/Pictures/Journal_AJ/Image27.png]

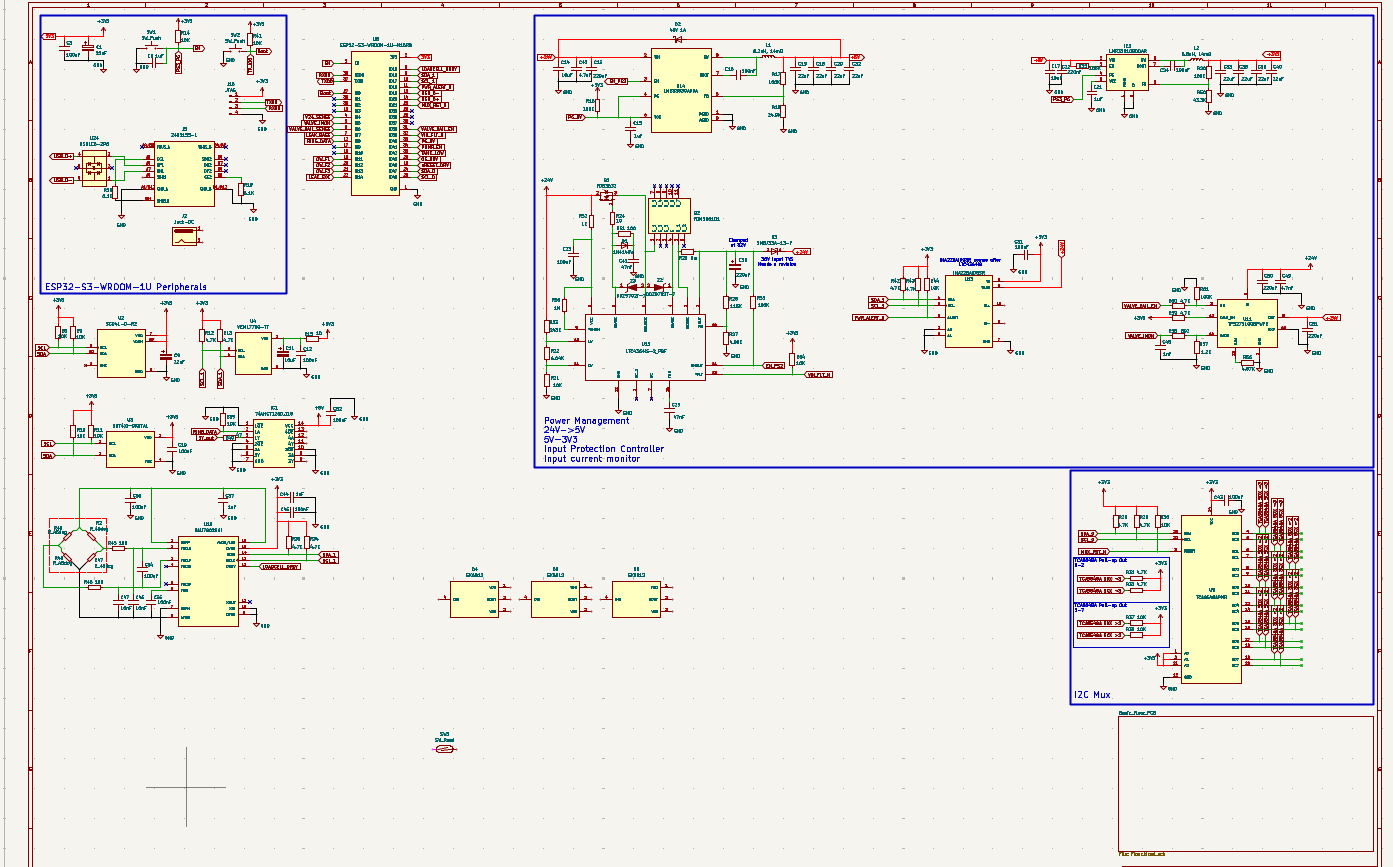
[picture p65: Documentation/Pictures/Journal_AJ/Image28.png]

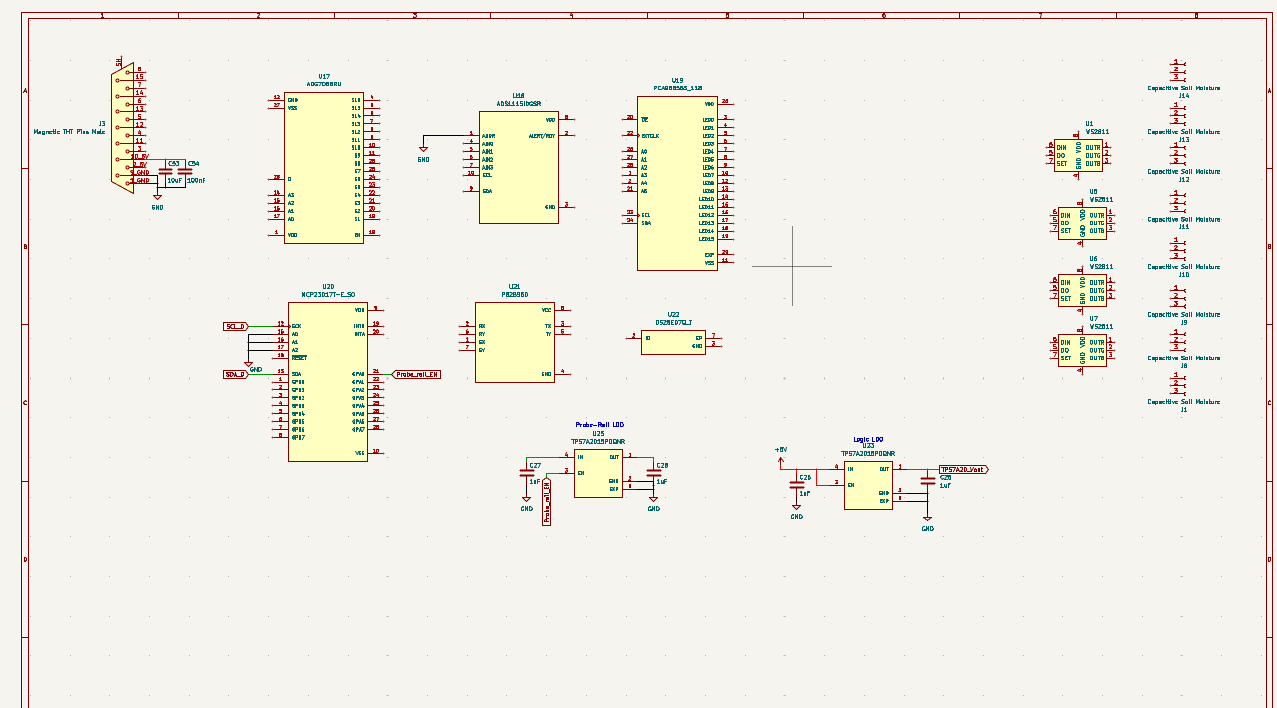
[picture p66: Documentation/Pictures/Journal_AJ/Image29.png]


---

## 11. Timelapse - 30.09.2026

A busy day but still managed to get in 3 hours of timelaspse. The work was kinda slow at some periods but i think its understandable that not a single teenager can sort out this much components and pins really fast, sometimes i start jet lagging and it looks like i am AFKing but instead i am thinking about a different module thats not on the screen. Anyways i did manage to get some progress and im getting very sleepy.

---

**What i did:**

- Upgraded a lot of modules with peripheral schematic
- Added some missing components
- Started assigning GPIO pins

---

**Problems that i had:**

- I am struggling with finding a nice usb-c port. I reckon i might be searching for something non-existent because i am a perfectionist but by tomorrow i will surely decide at some part.

---

**Next step:**

- Continue with what im doing lowkey

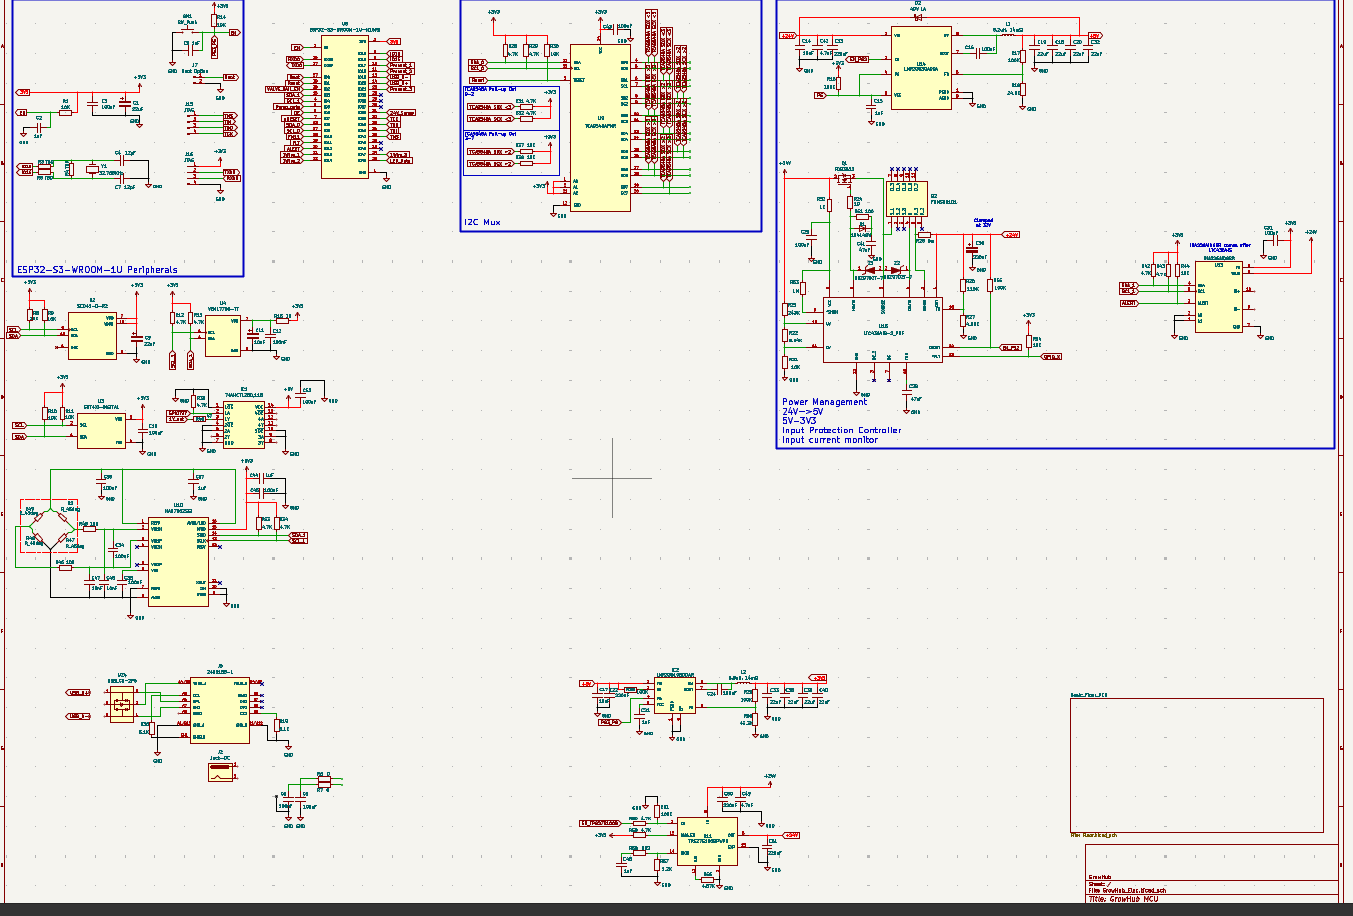
[picture p67: Documentation/Pictures/Journal_AJ/Image25.png]

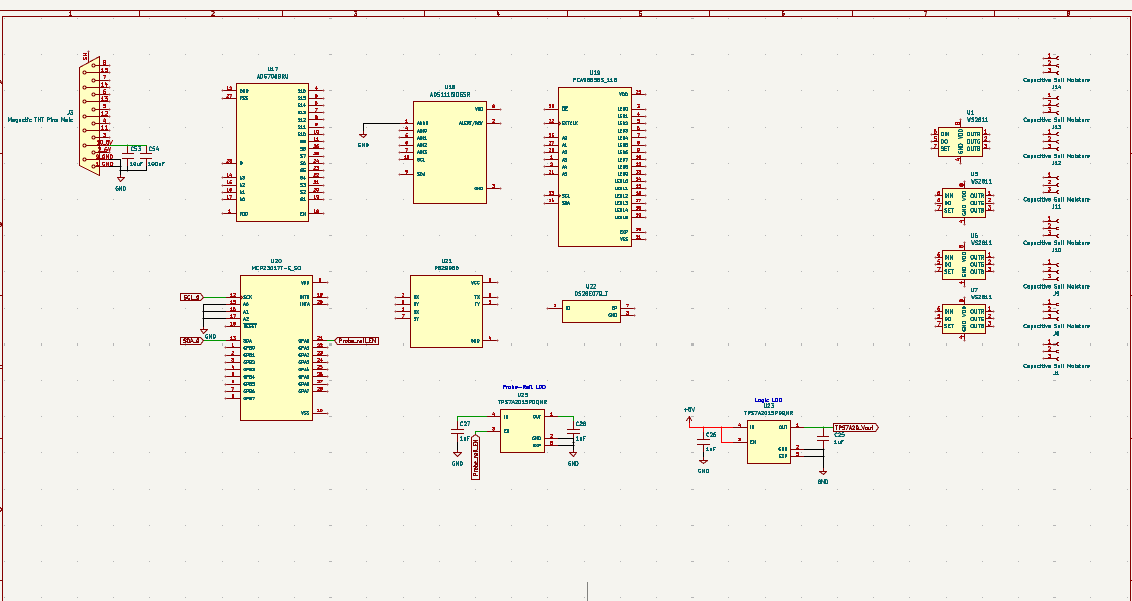
[picture p68: Documentation/Pictures/Journal_AJ/Image26.png]


---

## 10. Timelapse - 29.09.2026

After a long week I continue again with this project and in todays (midnight) timelapse even though i am super tired i clocked in some work and in particular i assigned some components and added their peripheral schematics. I also started assigning the GPIO Pins finally so once that is done and connected we will move on to PCBs.

---

**What i did:**

- Added 2 different LDOs for different purposes
- Improved MCU peripheral schematic
- Assigned MCU GPIOs

---

**Problems that i had:**

- Super exhausted and sleepy

---

**Next steps:**

- Finish off peripheral schematics
- Finish off GPIO assignments

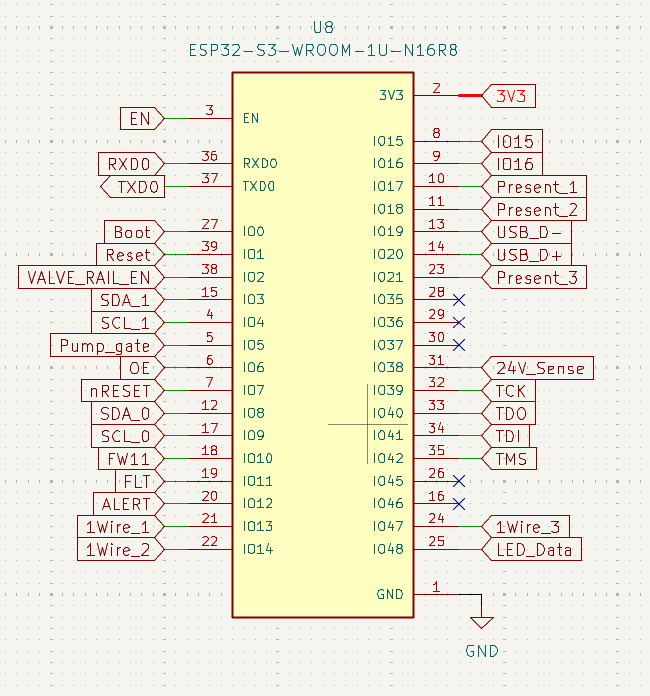
[picture p69: Documentation/Pictures/Journal_AJ/Image23.png]

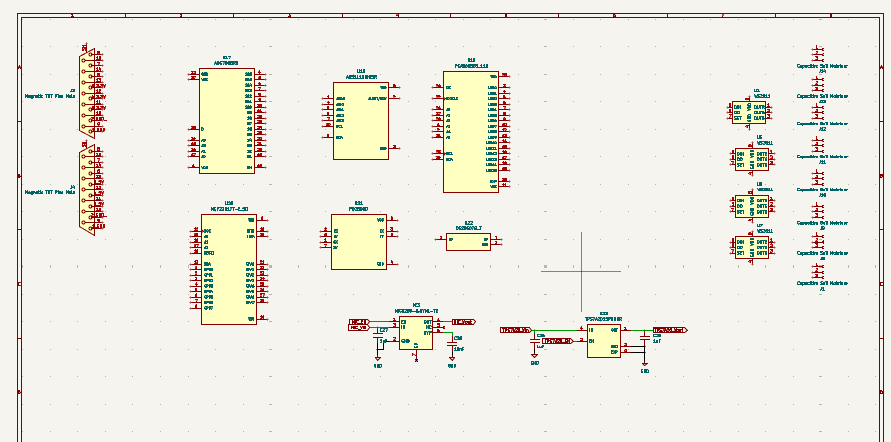
[picture p70: Documentation/Pictures/Journal_AJ/Image24.png]


---

## 9. Timelapse - 25.09.2026

Hooooly timelapse.... And lock in. I Cranked up 4 hours in one sitting which closes me out for this week hour requirement so that i can focus on school through out the weekend :)

A lot of stuff have improved today and most important improvement was the ***Input Protection Controller*** because HOOOLLLYYY WAS THAT A COMPLEX IC as it turned out. Behind timelapsing hours i decided to read the documentation and i found out that the recommendations are all flawed, like a lot. And because im a perfectionist i had to upgrade my IC operating efficiency.

This will probably be the last timelapse for Week 2 and so far i am happy of mine and overall our teams progress. For next week i plan on finishing the schematic so that i can start focusing on the Main_PCB 4-layer PCB.

I know it looks dull that i am working for so long on just the schematic but it really is a long process for such a big project.

---

**What i did:**

- Started working on Floor_PCB and added most of the components
- Finished a couple peripheral schematics
- Improved peripheral schematics
- Fixed a lot of errors that i've made previously

---

**Problems that i had:**

- A lot of issues that i had to fix
- Complex IC that required a lot of work
- A lot of multiplexers and expanders are needed

---

**Next step:**

- Continue implementing new components in Floor_PCB
- Finish the schematics in Main_PCB
- Upgrade or fix errors in previous modules

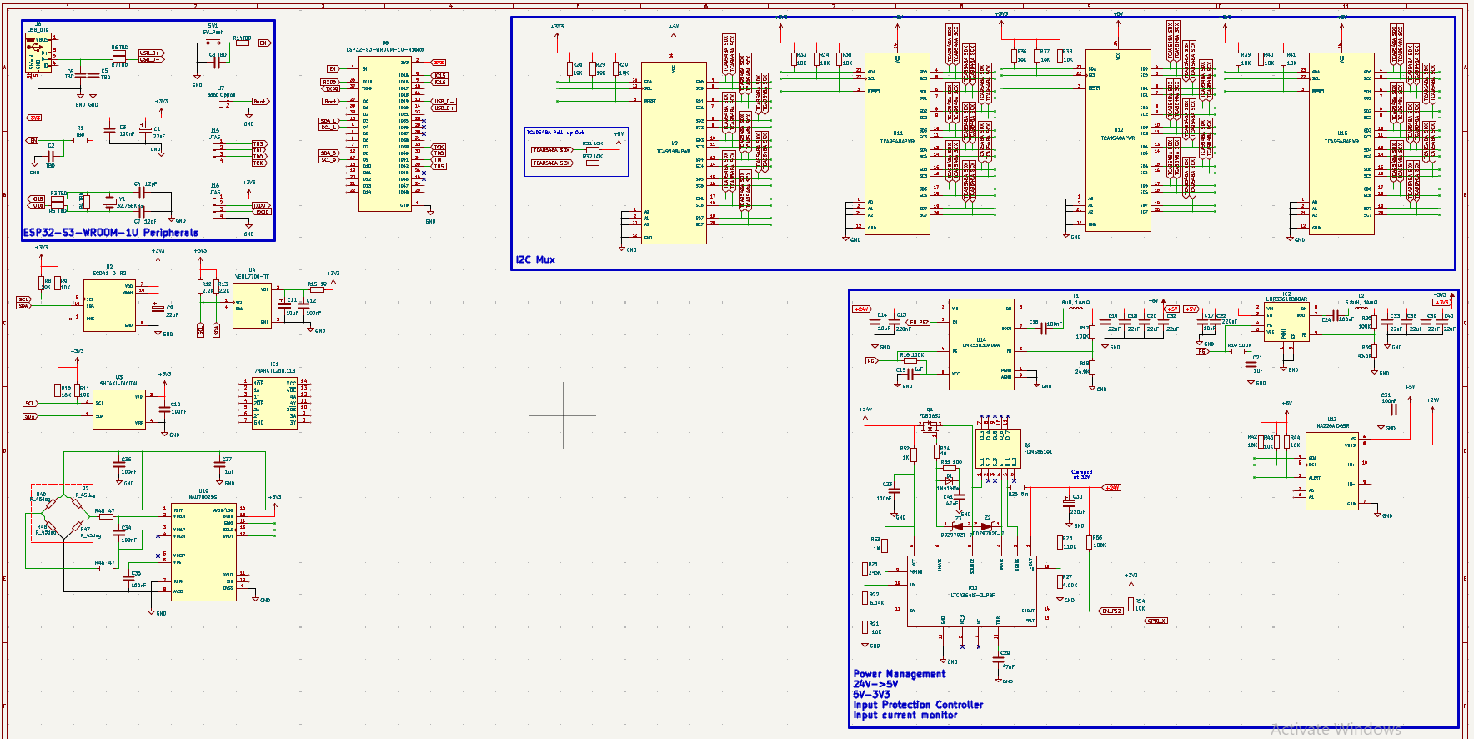
[picture p71: Documentation/Pictures/Journal_AJ/Image20.png]

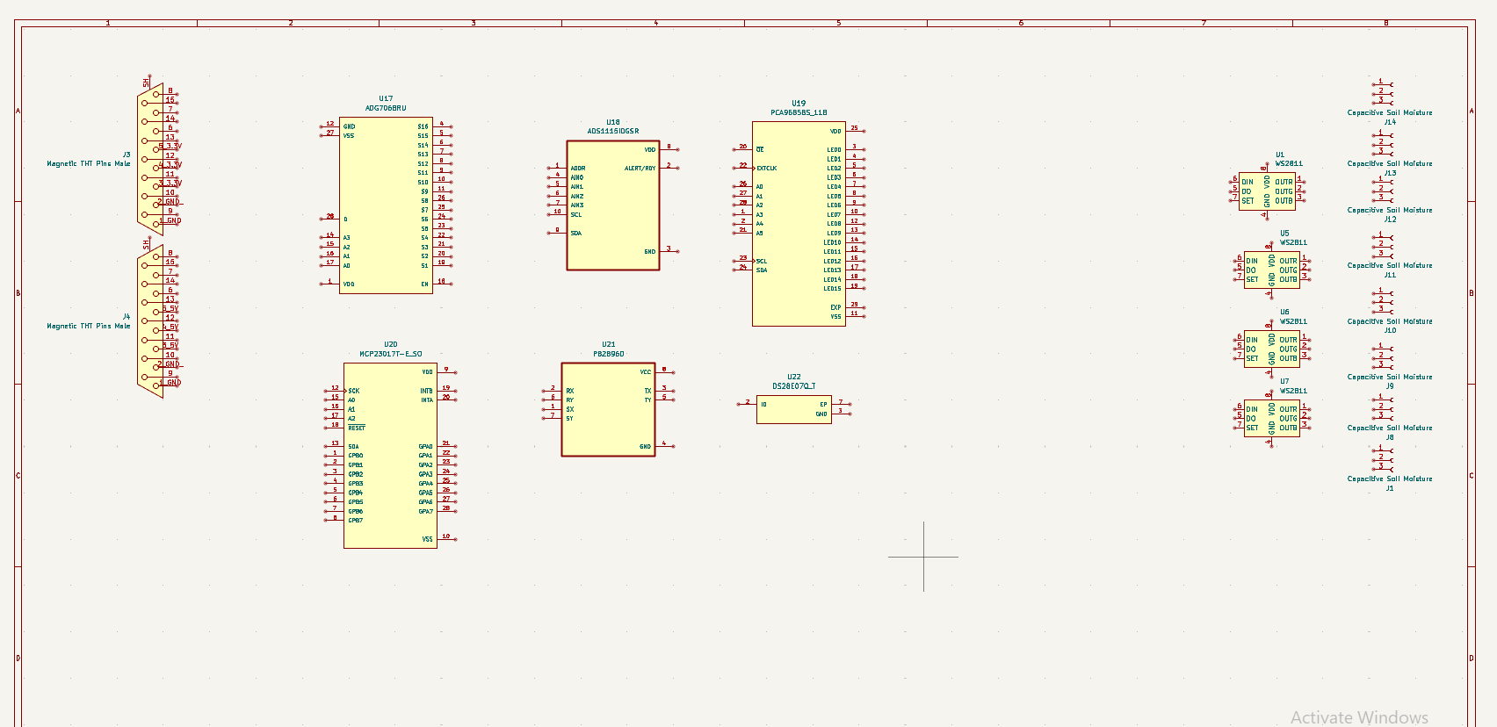
[picture p72: Documentation/Pictures/Journal_AJ/Image21.png]

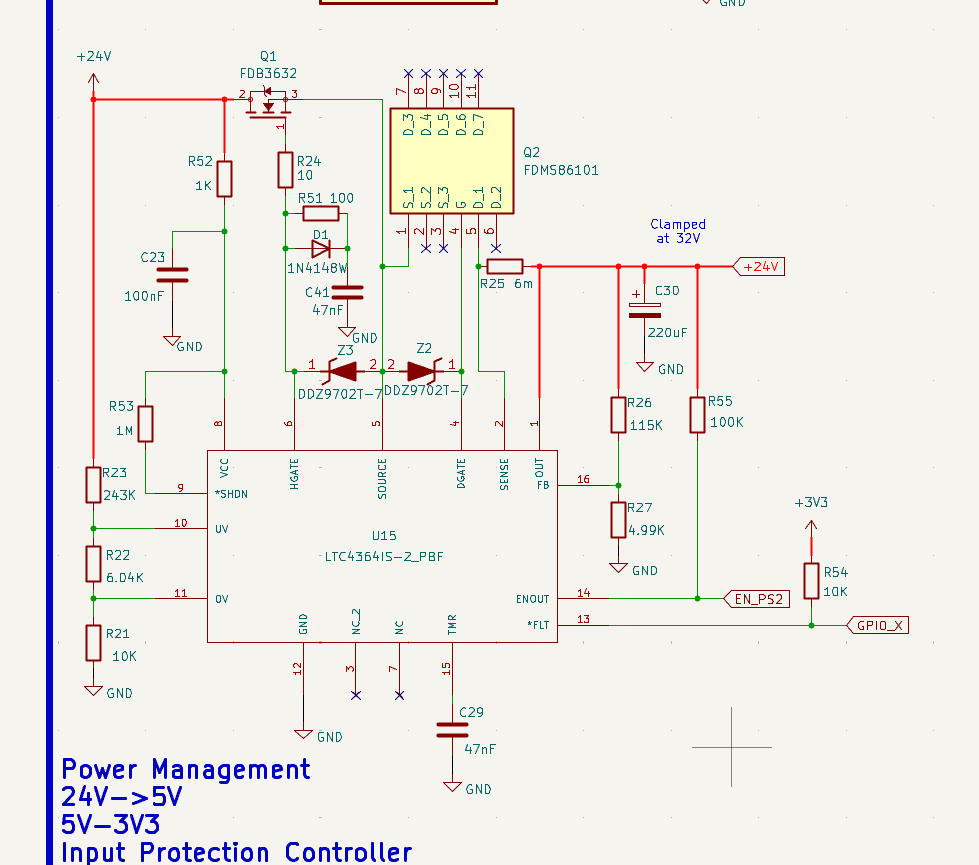
[picture p73: Documentation/Pictures/Journal_AJ/Image22.png]


---

## 8. Timelapse - 24.09.2026

Grinded up a bit and i implemented a lot of schematic features. I am still lacking a couple of components tht me and my partner mentioned for this project so i am both implementing and building their environment for efficient workflow.

Also the schematic is starting to recieve its own sections and by the end of it i hope everything is nicely organized and easily readable.

---

**What i did:**

- Added a lot of peripheral components for my modules
- Started implementing new sensors and modules for the project

---

**Problems that i had:**

- Because we are planning on really making this project functional it is hard to know what is too much expensive so i am very often getting lost into how much should i target efficiency or budget-friendly

---

**Next step:**

- There is still a lot of components that need to be added
- A lot of peripheral working left
- Need to assign MCU pins

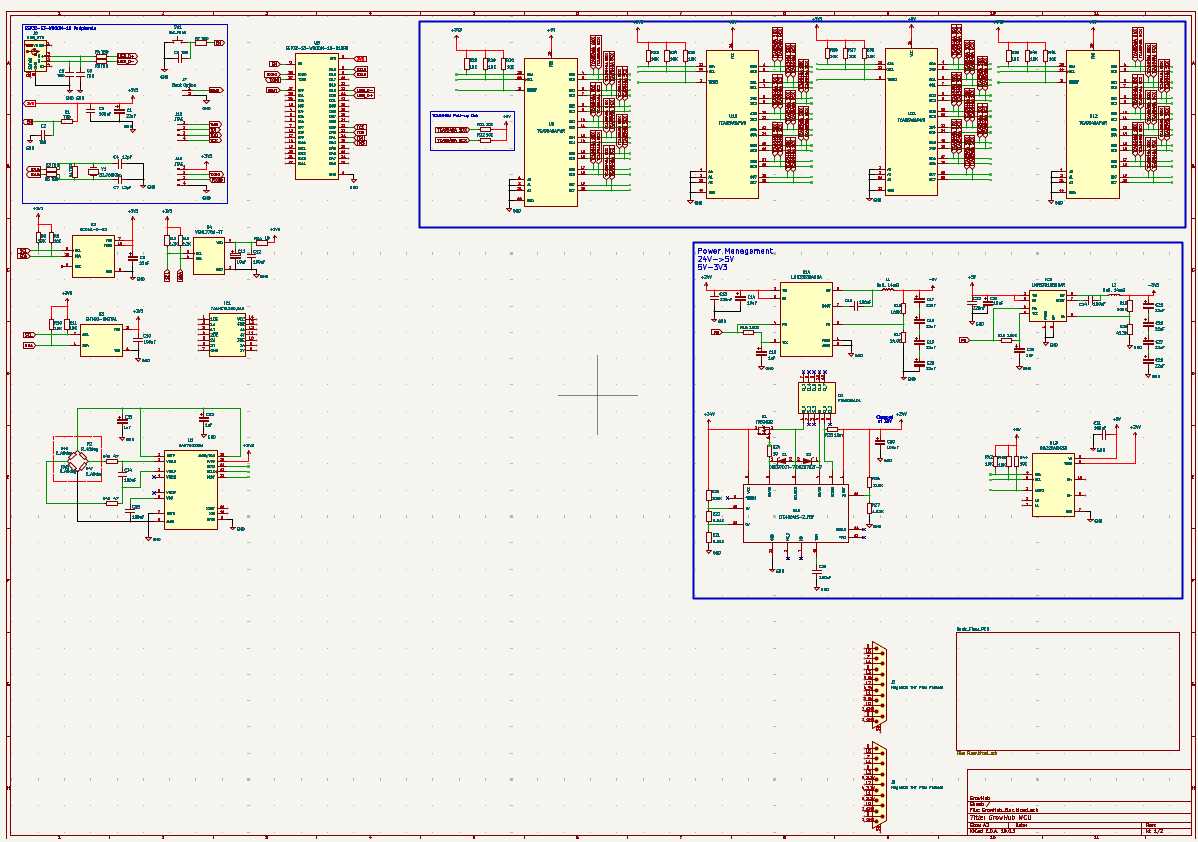
[picture p74: Documentation/Pictures/Journal_AJ/Image17.png]

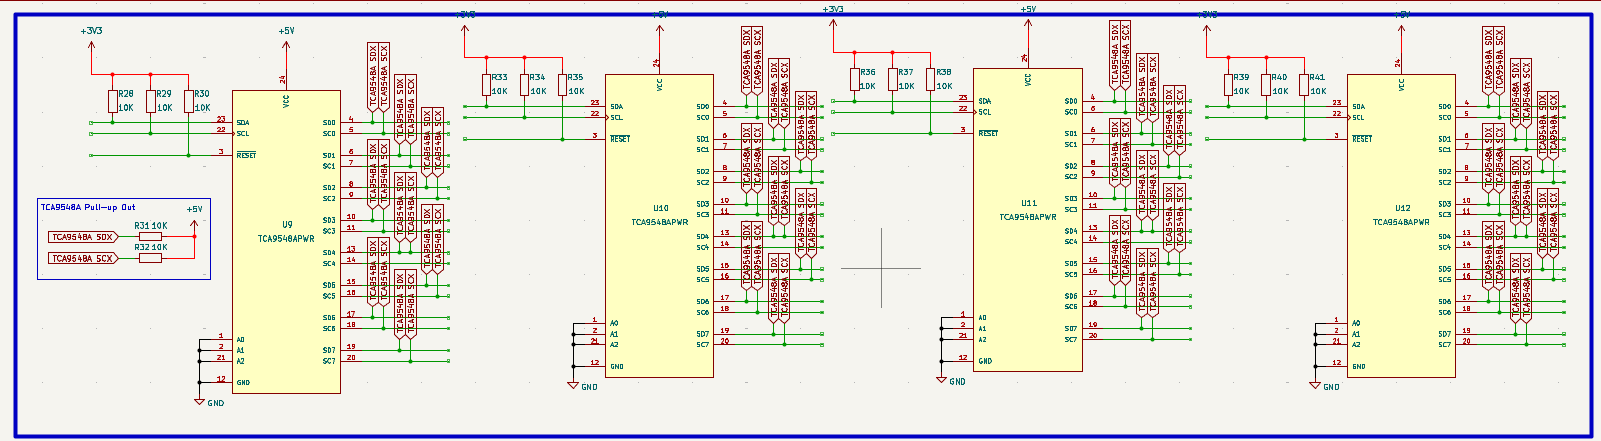
[picture p75: Documentation/Pictures/Journal_AJ/Image18.png]

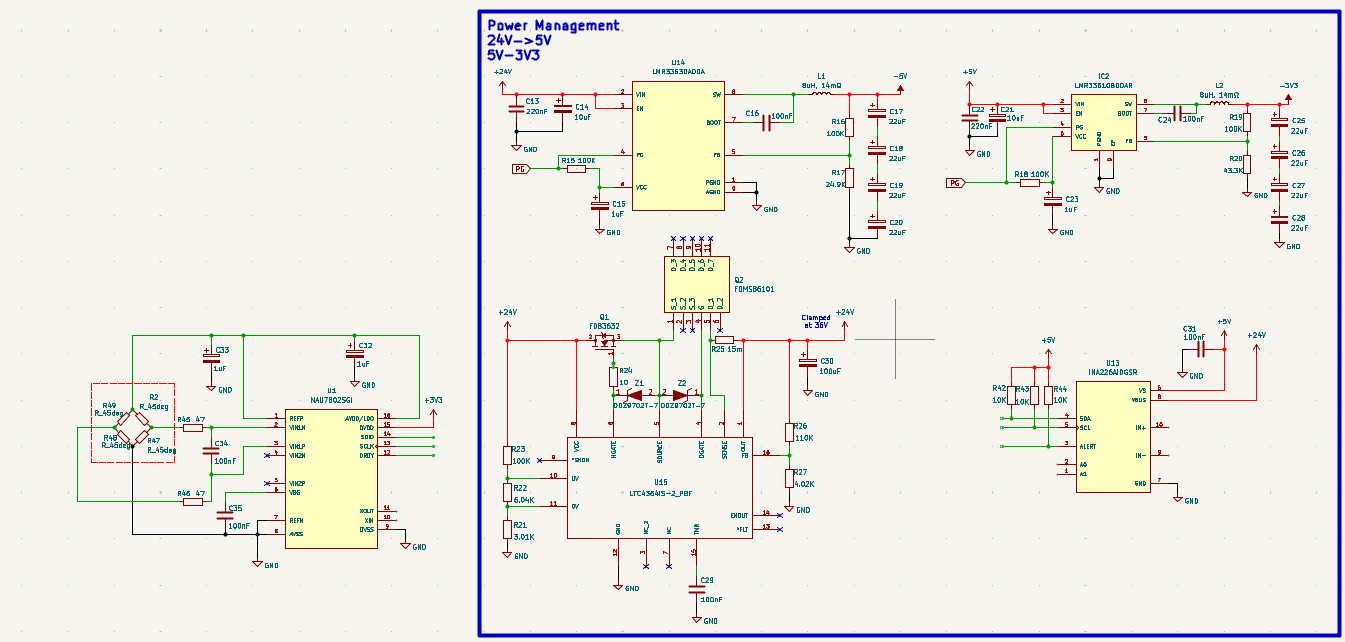
[picture p76: Documentation/Pictures/Journal_AJ/Image19.png]


---

## 7. Timelapse - 23.09.2026

A pretty chill day if you ask me considering that i've only assembled passive components around and copied prefered schematics. Ofcourse these recommendations need to be tested at first but that will be possible only after i assign other components.

---

**What i did:**

- Finished a couple modules with their passive component structure

---

**Problems that i had:**

- I am not sure if i have every single passive component integration for the MCU, i will have to double check in my past project but so far it looks ok except the "TBD" value components

---

**Next step:**

- Continue working on the same thing that i am working right now
- Also integrate other peripherals into the schematic

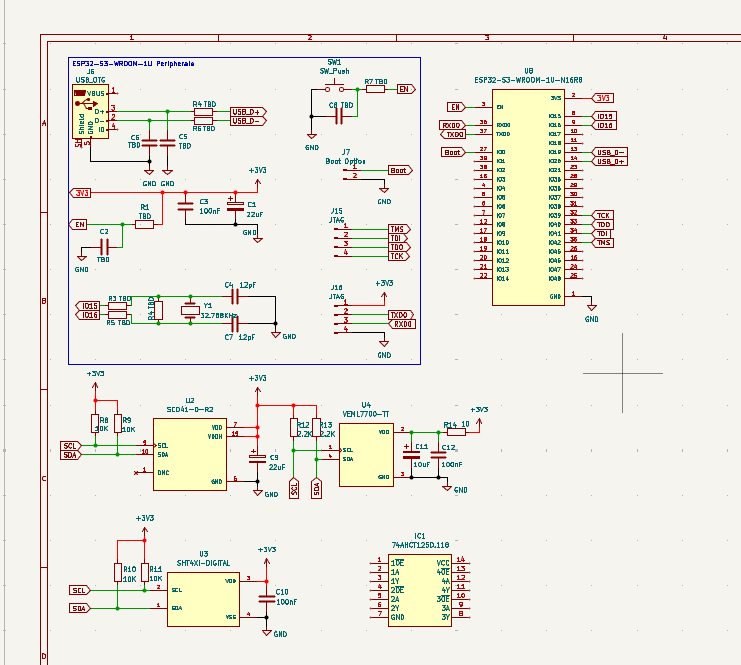
[picture p77: Documentation/Pictures/Journal_AJ/Image14.png]

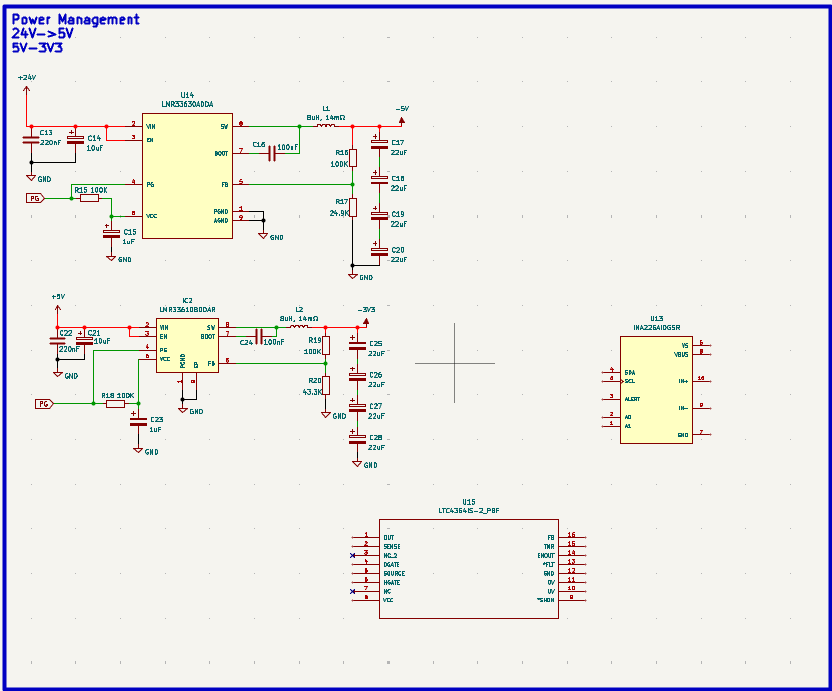
[picture p78: Documentation/Pictures/Journal_AJ/Image15.png]

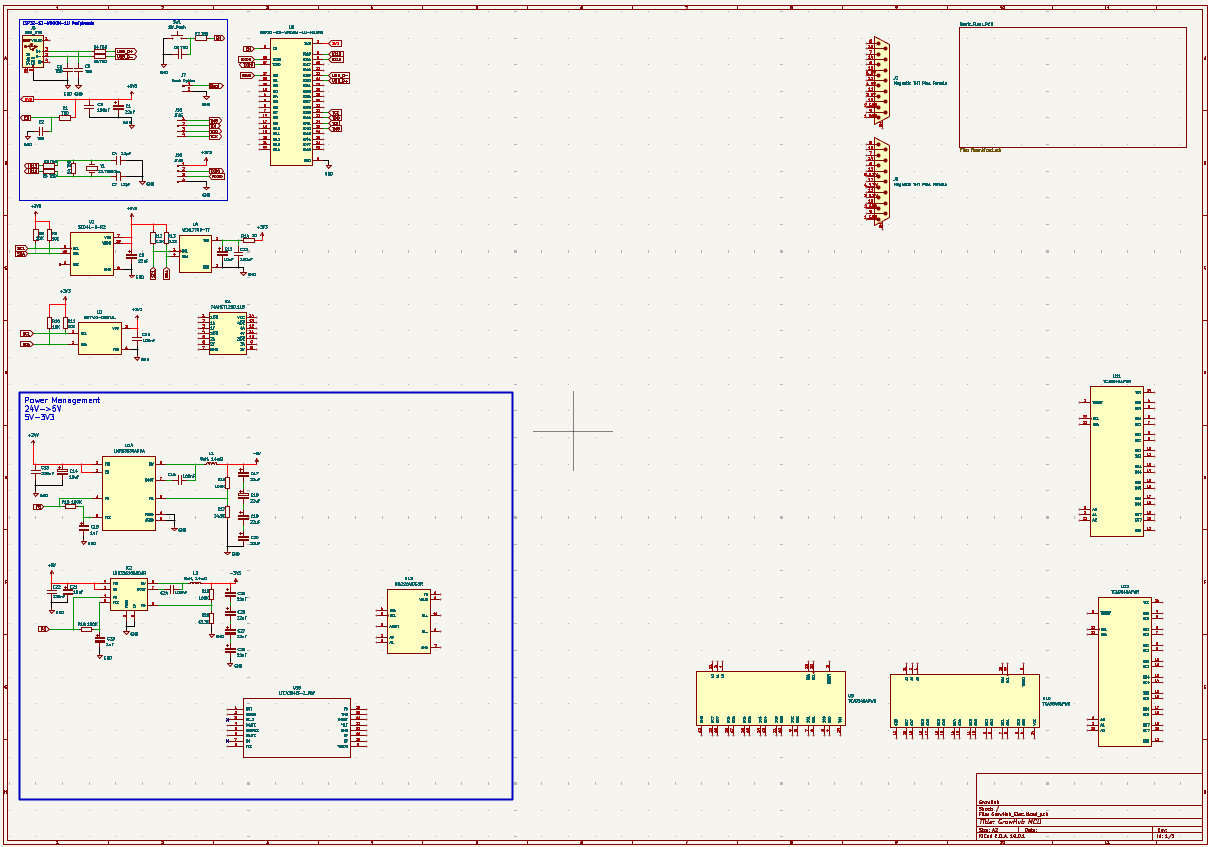
[picture p79: Documentation/Pictures/Journal_AJ/Image16.png]


---

## 6. Timelapse - 22.09.2026

Week one has ended!!! Honestly i think that i achieved my bare minimum and i hope that i beat the hour count this week. Even tho i've been up to a busy schedule with life I will try to do more than 12 hours.

We made a slight mistake by shipping it twice with individual screenshots and description so i hope that is not a problem :))))

Anyways here is what i did in this timelapse.

---

**What i did:**

- Started implementing passive components for the modules

---

**Problems that i've faced:**

- Nothing much except the fact that some components are not displayed with values so i will have to read docs while im not timelapsing....
- I forgot to transfer the newest schematic to GitHub and now because im working on my laptop (and not on my PC) because im in a different city i will have to transfer it via screenshare.

---

**Next step:**

- Start adding passive components to other modules

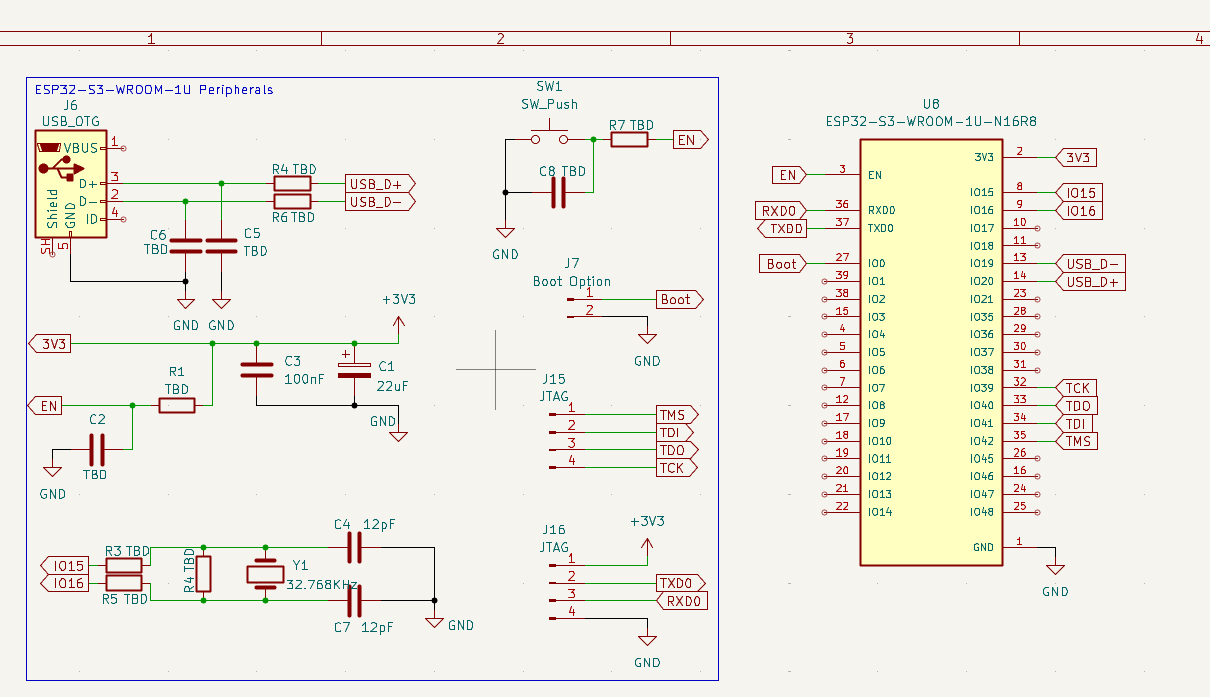
[picture p80: Documentation/Pictures/Journal_AJ/Image13.png]


---

<div align="center">
  
# ***END OF WEEK 1***

</div>

---

## 5. Timelapse - 20.09.2026

I've prepared everything for shipping for this week! A basic README has been constructed in order to have some meaningfull ship for the work that we managed to do in a matter of +20 hours of work on such a big and complex project so please take in notice that we haven't  made a functional project for Week 1.

---

**What i did:**

- Wrote README Week 1

---

**Current State:**

- Finished Week 1
- Ready to ship for a big project

---

**Next Step:**

- Start Week 2
- Have the first functional ship

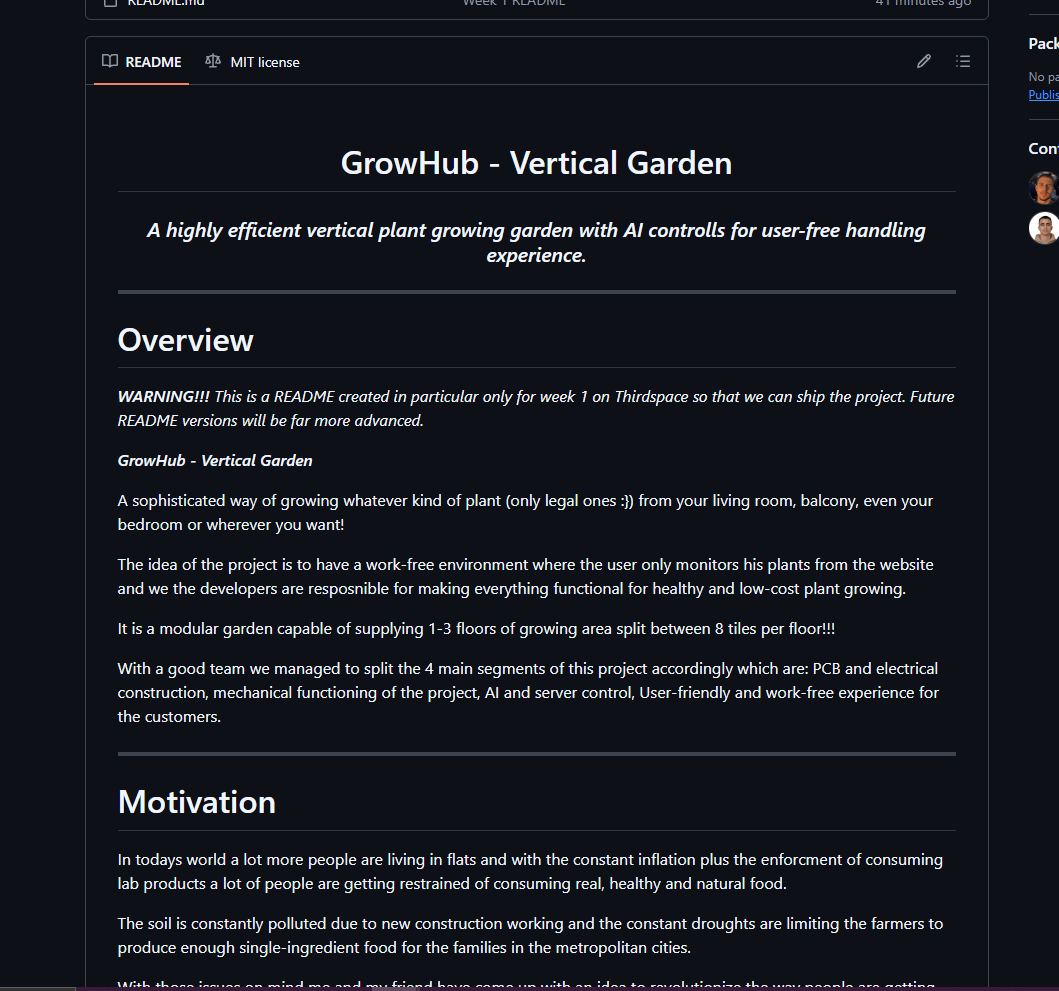
[picture p81: Documentation/Pictures/Journal_AJ/Image12.png]


---

## 4. Timelapse - 18.09.2026

Finally i've finished the component hunting for the main pcb *for now*. Saying for now is kinda sad considering i wasted so much time implementing them in kicad and avoiding the regulatory obligation that i can not read documentation while timelapsing and honestly i dont account this time as reading documentation because i've researched dozens of coponents in this hours so it is an efficient time spent working on a project.

---

**What i did:**

- Finalised the first hunt for components
- Made a clear path for a smooth work in KiCAD
- gathered documentation that will help while making the hardware

---

**Problems that i've faced:**

- A lot of components... I know that we still havent explained the project but its sooo complex that a lot of regulations and procedures are required.
- Super technical project

---

**Current State:**

- Ready for building the schematic
- Clear path to work on
- Ready to start working on the other 2 PCBs

---

**Next Step:**

- Agree what type of pump for watering we are gonna use with my teammate
- Start the schematic with passive components
- Create constraints and regulations for my KiCAD project

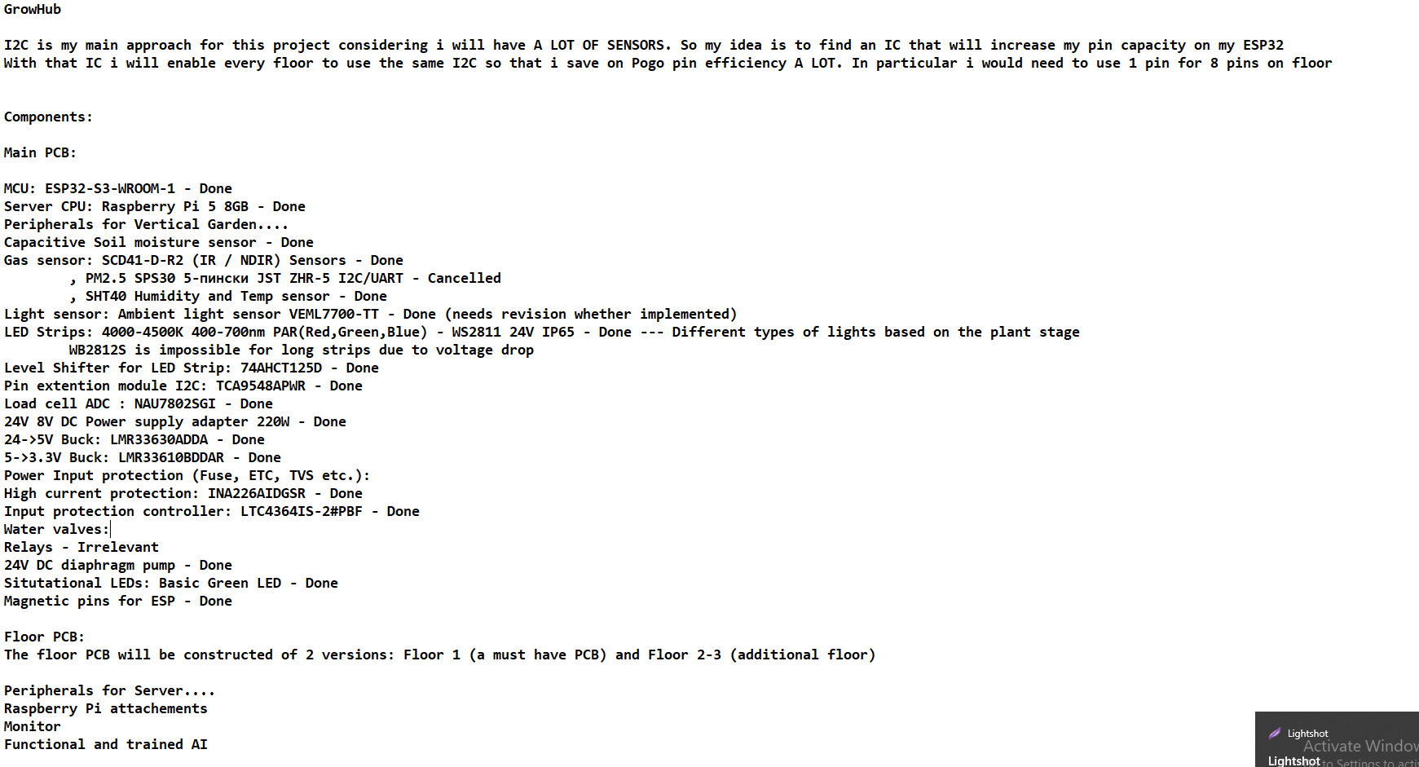
[picture p82: Documentation/Pictures/Journal_AJ/Image10.png]

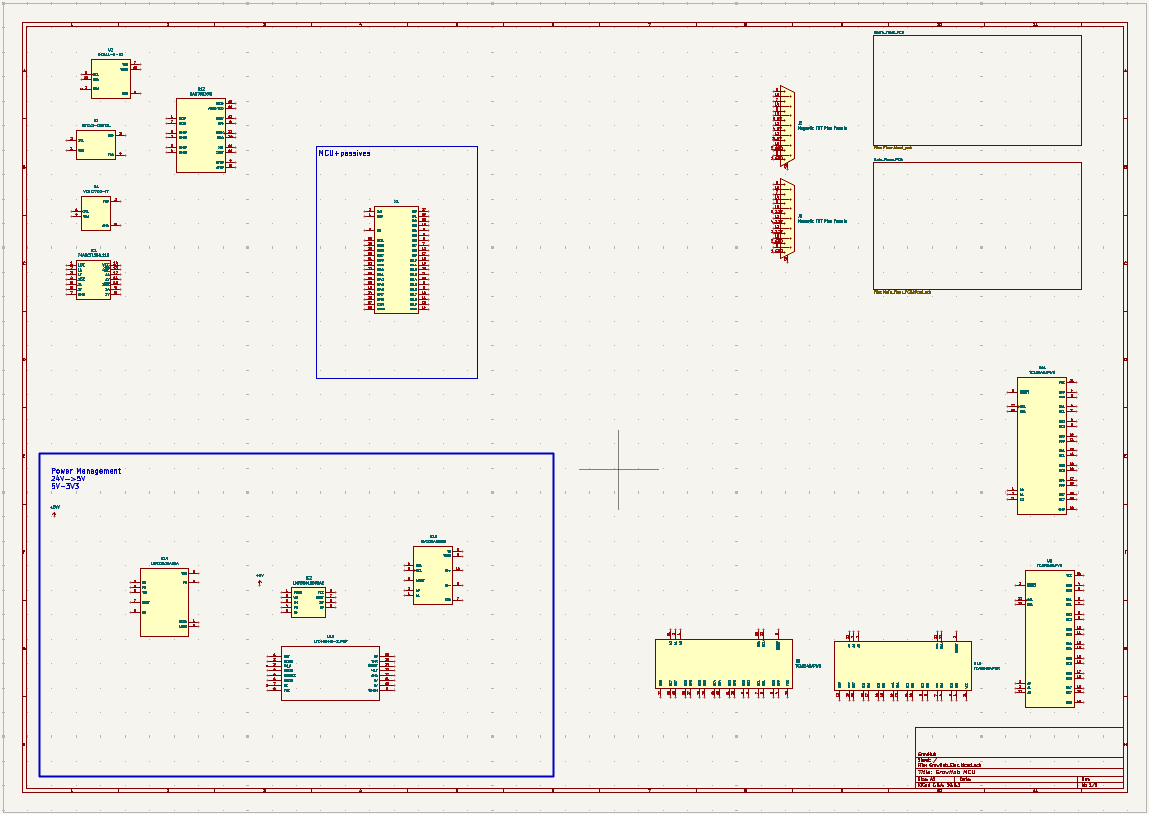
[picture p83: Documentation/Pictures/Journal_AJ/Image11.png]


---

## 3. Timelapse - 17.09.2026

Im getting closer to finishing the main PCB component list. I've decided which input voltage i should use. I found every sensors that i need for the first version and now only power management section is left.

I plan for the first week to have every single component that i would need for the main PCB in order to supply the floors with the desired power/signal.

---

**What i did:**

- Finished input/output component selection.
- Found a 24V diaphragm water pump for our project.
- Assigned every component with its coresponding footprint in KiCAD.
- Fixed the issue with my MCU selection.
- Calculated critical power consumption components
- Improved the PCB concept of having 3 versions of PCBs for budget efficiency.

---

**Problems that i've faced:**

- None except the fact that some components caused me a headache whilst trying to find a footprint for them.
- A huge project causes so many aspects to be taken in notice so its really hard to decide where to work first.

--

**Current State:**

- Cleared a lot of uncertainties with the hardware aspect of the project
- Created a clear path for work behind the "scenes" (timelapsing) with my teammate
- Almost prepared my work on KiCAD

---

**Next Step:**

- Resolve the Power Management component question.
- Find watering components that accomodate 24V if possible
- Try and skip 12V in order to be efficient.

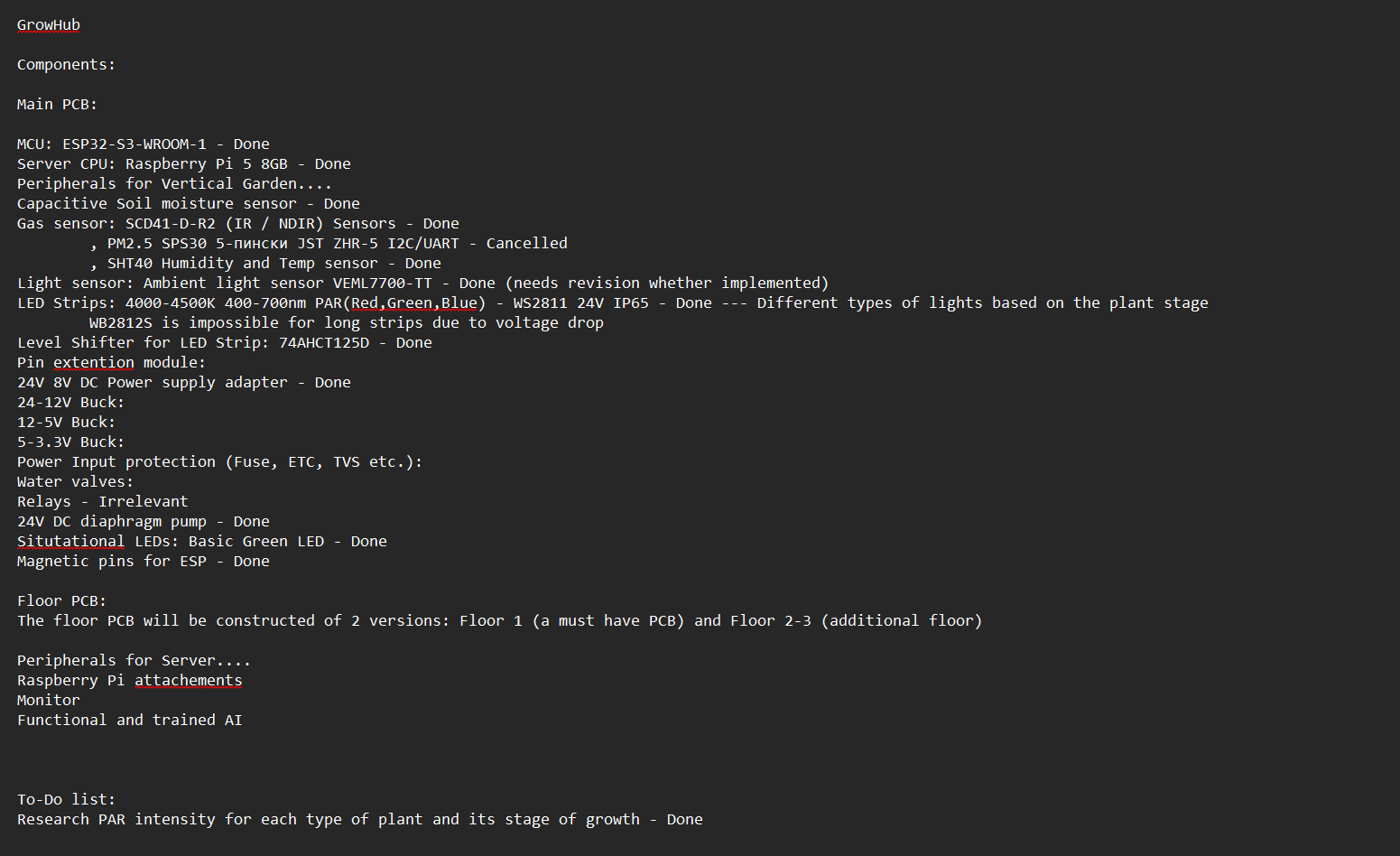
[picture p84: Documentation/Pictures/Journal_AJ/Image7.png]

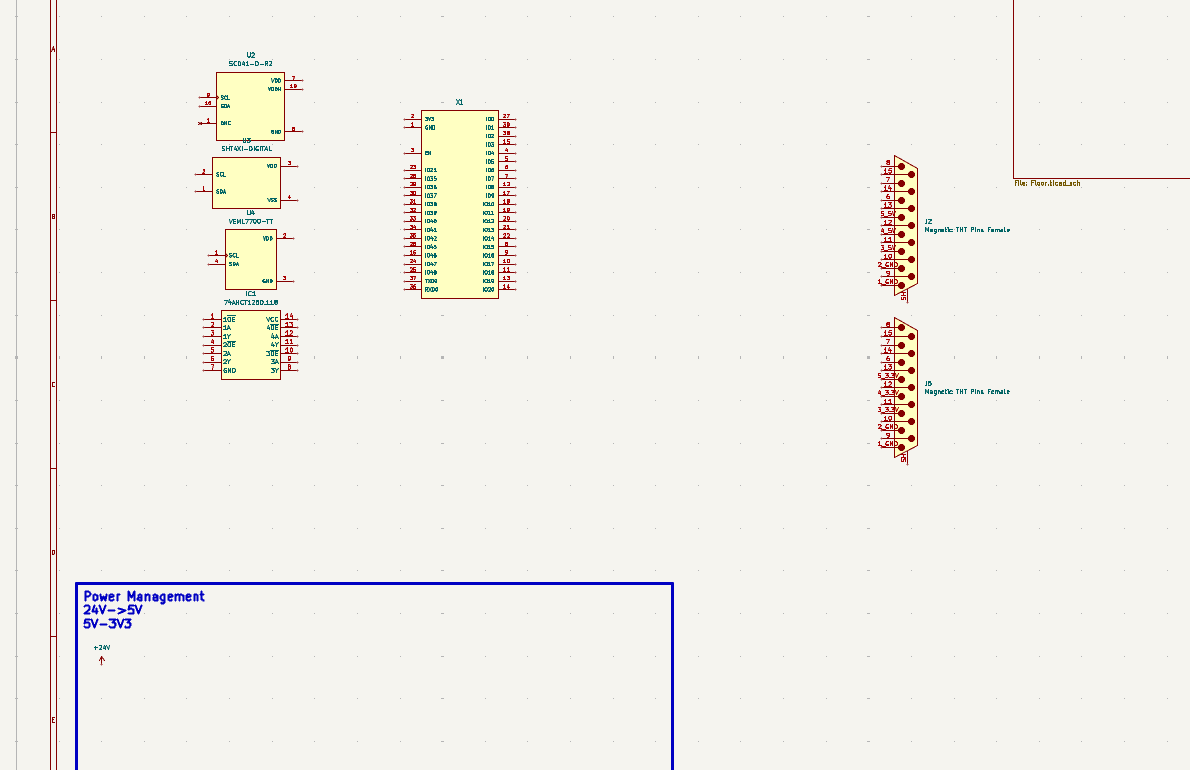
[picture p85: Documentation/Pictures/Journal_AJ/Image8.png]

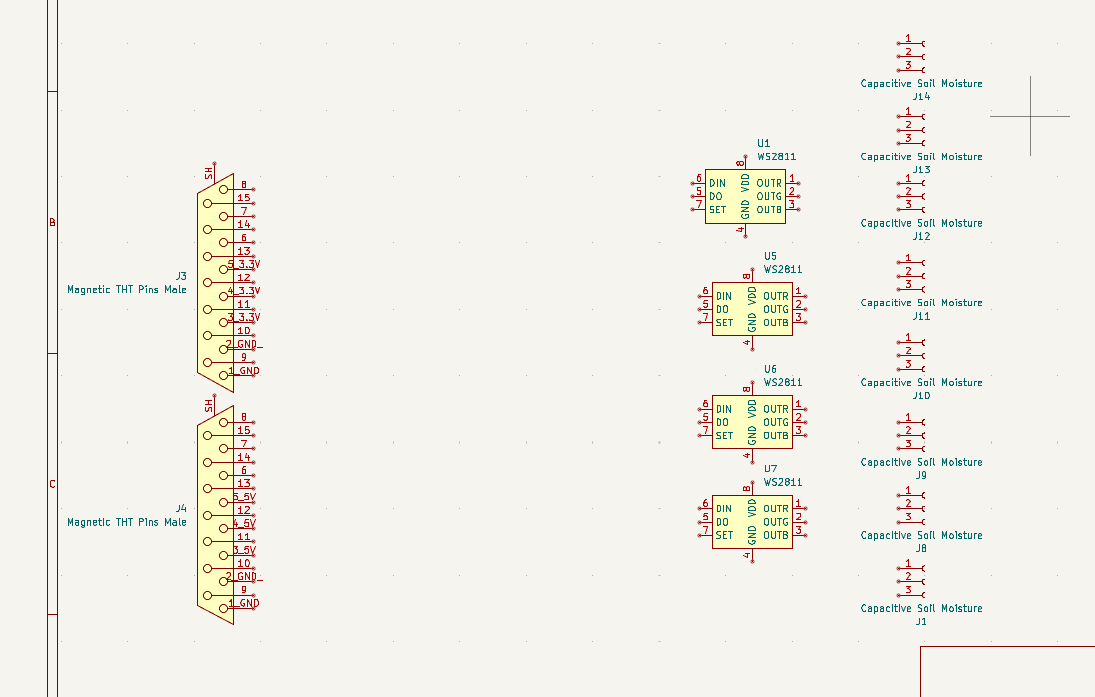
[picture p86: Documentation/Pictures/Journal_AJ/Image9.png]


---

## 2. Timelapse - 16.09.2026

Component shopping!!!
Or more accurately the pain of not settling down with 1 module which was so disturbing because of the sheer spectrum that this project is consisted of. I've reserched a lot behind timelapse because i know reading documentation is forbiden but still i had jet lags while timelapsing because i was re-ordering my information in my head.

We've also discussed a lot on how to 3D model and implement the multi-PCB concept all in one so i am really excited so see what it is gonna look like.

---

**What i did:**
In this timelapse which lasted 2 days because yesterday i didnt manage to timelapse for another hour i intended on researching needed components and trying to find them. I am not a biology-person but I tried to research and implement every sensor that is needed for perfecting the growth of one plant.

Researched and read A LOT OF DOCUMENTATION behind timelapse so that i know a bit more about this project

---

**Problems that i've faced**

- A lot of sensors....
- I had so many options that i didnt know what to choose.
- I couldnt really show every work via timelapse becuase some of it was just brainstorming options inside of my head and writing it odwn in notepad in my components list
- The Magnetic Pogo wiring is still a problem and we will need to resolve it with my teammate.

---

**Current State:**

- I've almost picked every essential component that i need for start
- I have made a clear plan behind the scenes on how the electronic scheme should look like (visual imagination :)))
- I've redesigned the schematic and how i plan on doing it.

---

**Next Step:**

- Finish the essential component list
- Start the first version of the schematic.

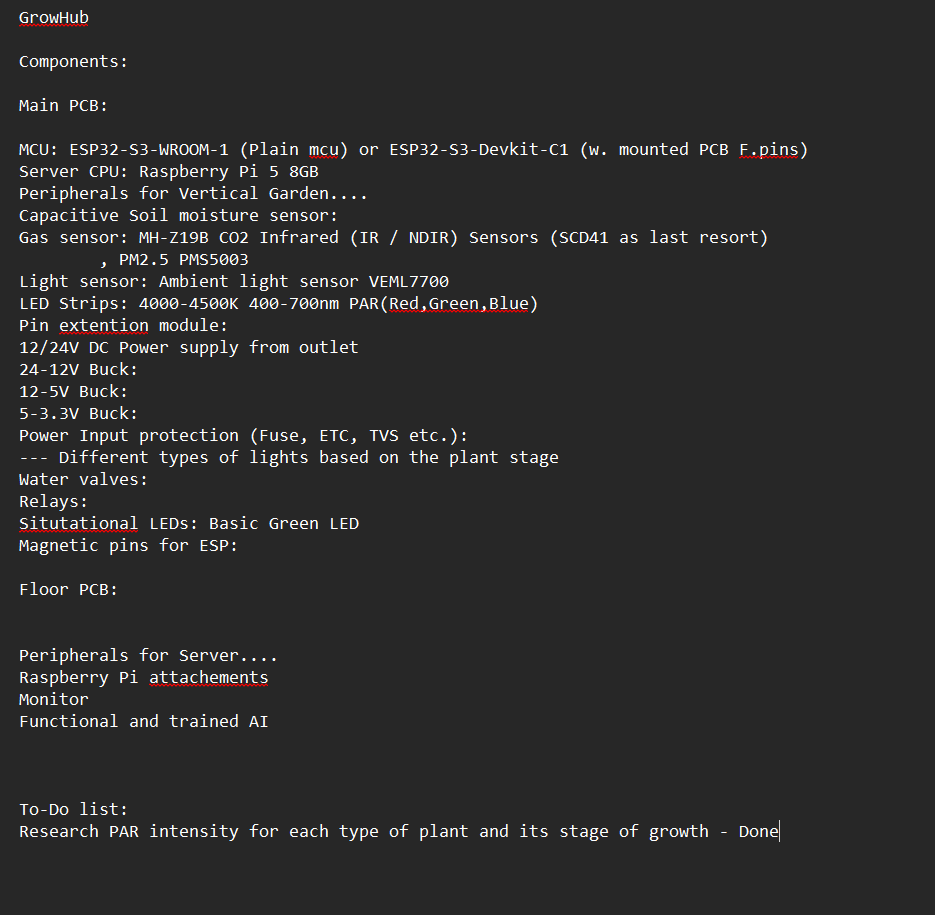
[picture p87: Documentation/Pictures/Journal_AJ/Image4.png]

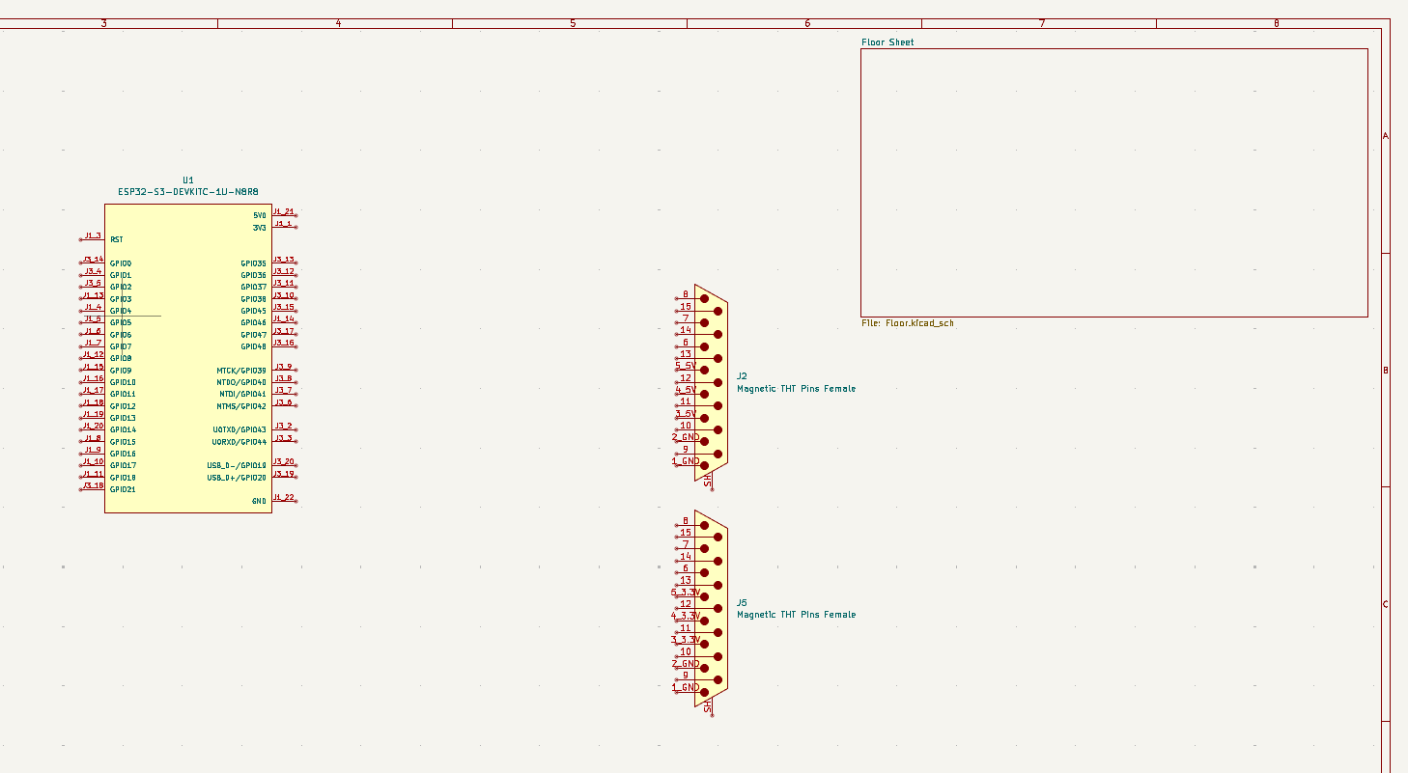
[picture p88: Documentation/Pictures/Journal_AJ/Image5.png]

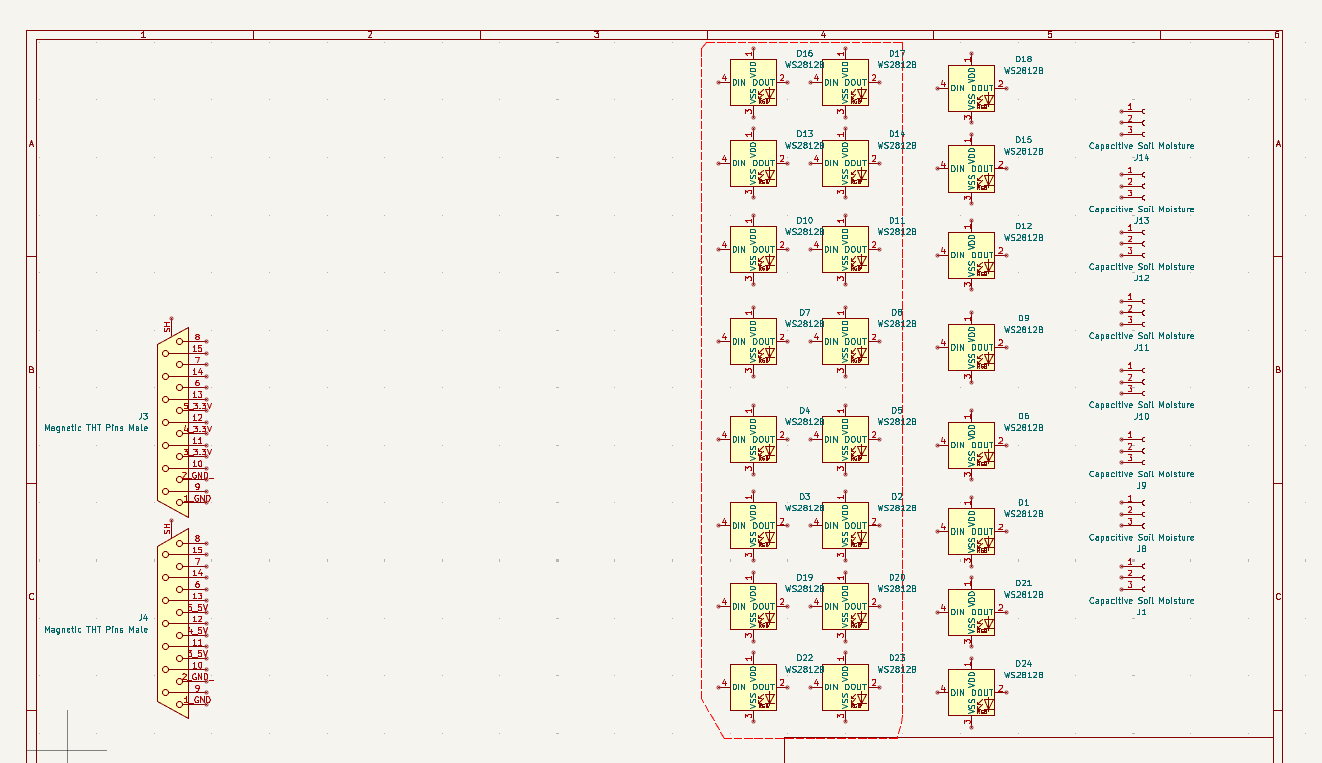
[picture p89: Documentation/Pictures/Journal_AJ/Image6.png]


---

## 1. Timelapse - 14.09.2026

Another project has been started in this organization with a lot of plans and goals that need to be accomplished. 

---

**What i did:**

- In this timelapse i did what every normal person (hopefully) would do when they start a project and that is to use your imagination in order to create a sketch that will guide you toward the end product.
- I also created the regular files that i need for shipping a project and prepared files for me and my friend while we journal.
- I have also started looking for components and finding the files for KiCad.
- Because i have been assigned for the hardware and embedded systems it is my job to work on the efficiency of the modules.

Now it's kinda different because i am participating in a team related project called Thirdspace so we have assigned eachother with separate work in order to complete this project:)))

---

**Problems that i've faced**

I fear that as always i will have problems with finding the files to implement into KiCAD and instead i will have to use connectors in order to immitate them.

Slight network problems were existent but that is not a project issue after all.

---

**Current State**

- The starting point has been created from my viewpoint and for my work
- I've prepared the repository for my friend to work inside it also
- Started the schematic
- Started searching for the components

---

**Next Step**

- Finish the component list atleast for 1 floor and basic MCU station
- Create a basic schematic
- Write an MVP code in ESP-IDF
- Test it at home

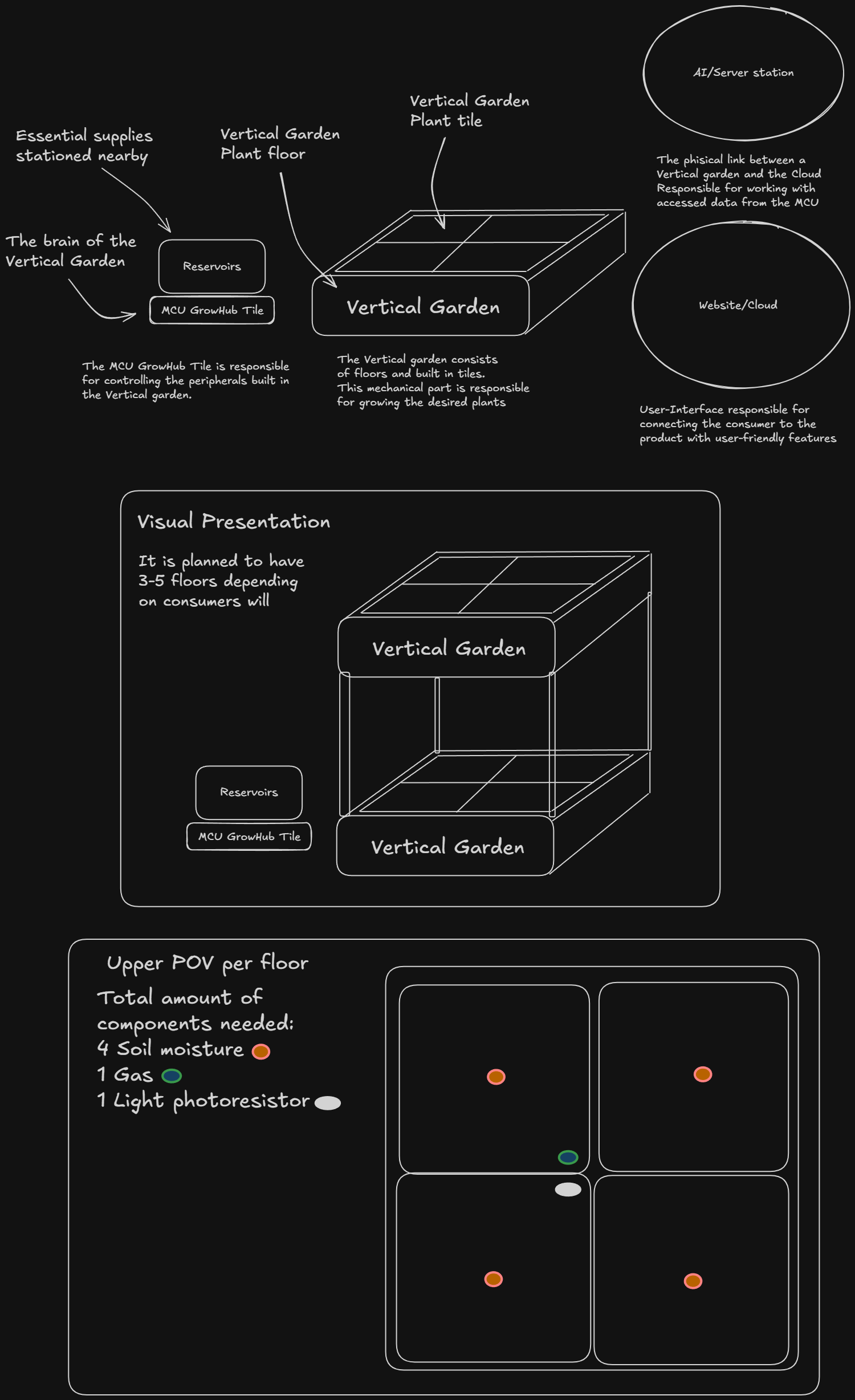
[picture p90: Documentation/Pictures/Journal_AJ/Image_1.png]

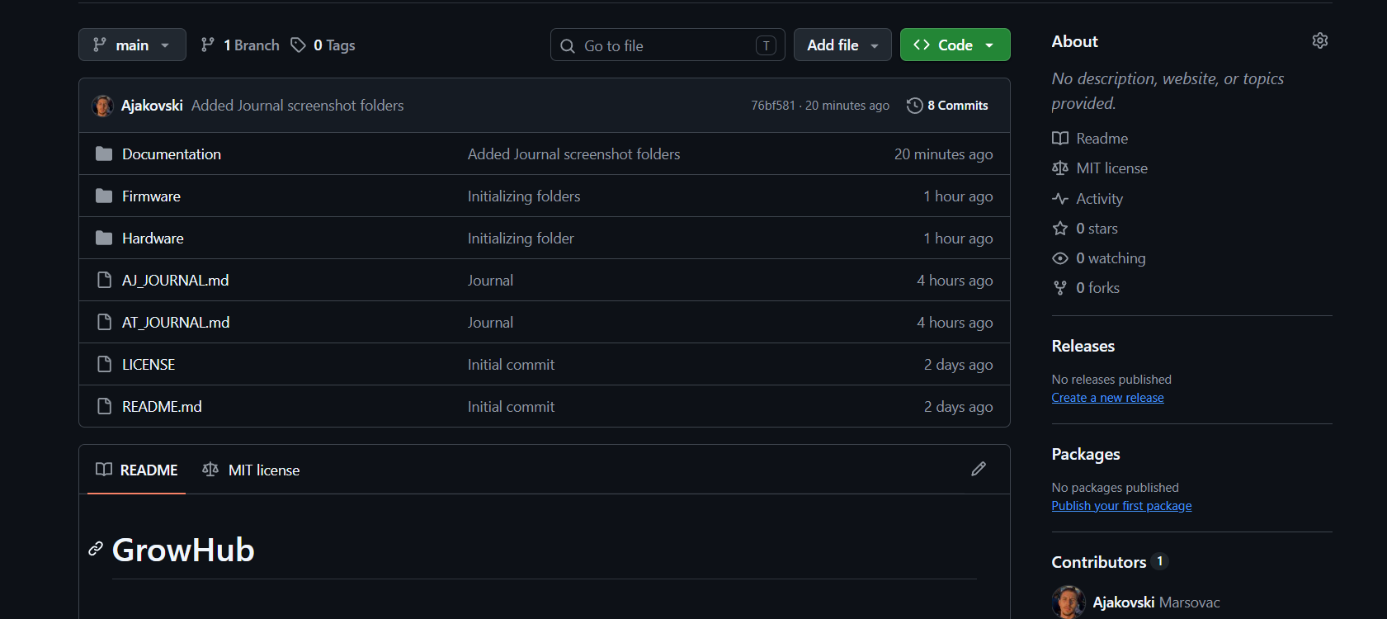
[picture p91: Documentation/Pictures/Journal_AJ/Image_2.png]

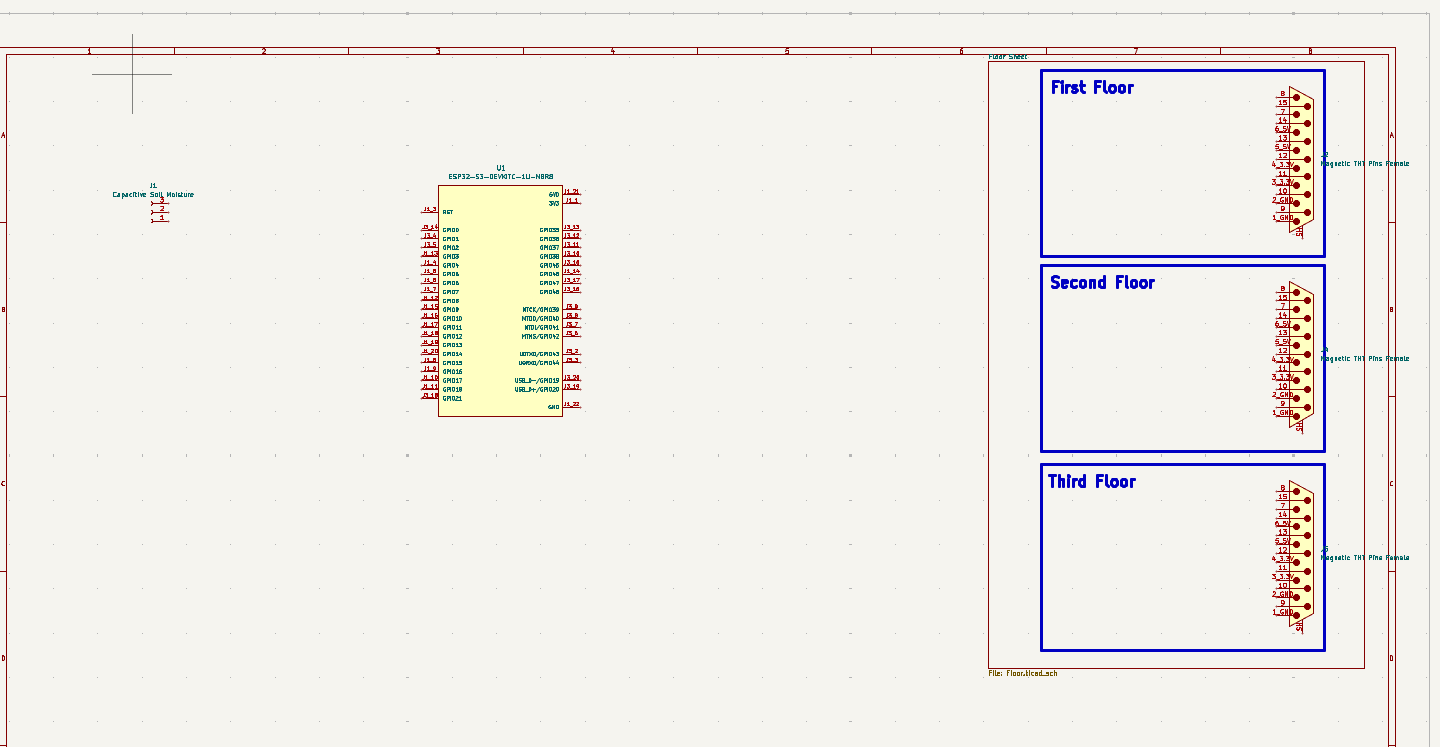
[picture p92: Documentation/Pictures/Journal_AJ/Image_3.png]


---
