Ajakovski/GrowHub/AT_JOURNAL.md

# GrowHub - Journal

- Author: atrendov1

## 1. Timelapse - 14.09.2026

Another project has been started in this organization with a lot of plans and goals that need to be accomplished. 

---

**What i did:**

- I've started working on the design of the product like just sketching and doing artwork for it so i can get a feel of the idea.
- I drew up how all of the different parts of the product would look
- I also started playing around with the design of the tubing and how it would route trough the planter.
- I also started drawing up and thinking of different ways we could make it as modular as possible.
---

**Problems that i've faced**

- I faced a lot of problems while coming up with the design mostly in how everything would connect how everything would route within the body of the planter.
- The biggest problem i had was trying to make it fully modular but also simple and not too expensive to manufacture.

---

**Current State**

- I now have an idea of how everything would look and connect with eachother.
- I have artwork/design of every part of the system.

---

**Next Step**

- Try to refine the design with better wire and tube routing and with simpler modularity and racking.

[View art PDF](Documentation/growhub_design_v1.pdf)

---

## 2. Timelapse - 16.09.2026

I've simplified the design of the planter by alot and now i like the design itself much more. Also i have started to work on a website that shows off the product.

---

**What i did:**

- I've simplified the design a lot by removing the whole modularity factor since it was overcomplicating things, now instead of 1 product that's modular we have 3 in different sizes.
- I started working on a landing page/shop website to show off the product and what it can do.
- I wrote most of the basic HTML for the site and a little bit of JS.

---

**Problems that i've faced**

- Making the design of the planter modular while keeping it simple
- Routing of pipes and waterflow in setups that have multiple floors of planters.
- Some small HTML bugs here and there.

---

**Current State**

- Design v2 of the planter is done and im pretty happy with it.
- Website for the product has been started and going pretty well.

---

**Next Step**

- Start styling the website using CSS.
- Add a shop part to the website.
- Digitalize the sketches of the planters and hubs.
- Draw them with dimensions so we can start the CAD designing of the product ASAP.

[View art PDF](Documentation/growhub_design_v2.pdf)

---

## 3. Timelapse - 17.09.2026

Some style has been added to the website and its starting to look good. But man is CSS boring to write.

---

**What i did:**

- I mostly worked on the website adding CSS to it and making it look nice.
- Wrote in the journal for the past few days that i've worked and not written anything.

---

**Problems that i've faced**

- Just some problems with styling in CSS but nothing a bit of research and stack overflow can't fix.
- The website is looking a bit too basic.

---

**Current State**

- The website styiling is going well, i'd say its halfway done.
- My journal is written.

---

**Next Step**

- Sketch up some UI/UX design for the website so i can make it not that basic.
- Finish the CSS for the website.
- Draw the designs of the product digitally with dimensions for CAD.

---

## 4. Timelapse - 18.09.2026

I finished up the css for the basic website and i like how it looks right now. I also worked a lot on designing how the water would
travel trough the connected tiles and i played around with how we could fit in hydroponics into our design.

---

**What i did:**

- I finished up styling the last of the classes in the website.
- I made the website be responsive so it looks good on all devices.
- Made designs on how the water would travel between floors and if it even should do that.
- Made designs on how the water would travel between the tiles.
- Made designs on how we can add hydroponics to our system.

---

**Problems that i've faced**

- Not a lot of problems today, except how boring it is to make a website responsive. Other than that i was pretty inspired today'
so ideas for the design process came pretty naturally.

---

**Current State**

- The basic shape of the website is done.
- We have quite a few new designs for all the systems.

---

**Next Step**

- Sketch up some UI/UX design for the website so i can make it not that basic.
- Choose with what design and system for water and hydroponics we should go with.
- Draw the designs of the product digitally with dimensions for CAD.

[View design SVG](Documentation/growhub_design_v3.svg)

---

## 5. Timelapse - 28.09.2026 - 04.10.2026

I have since realised i do not need to keep a journal for my coding so this entry just covers what i did
with the cad design of the planter over the week.

---

**What i did:**

- I made up my mind on the fundamental style, look, and functionality of the planter.
- Started working on it in CAD
- Created the first basic CAD model of the planter that will help us visualise the planter and iterate on it more easily.

---

**Problems that i've faced**

- Just the usual FreeCAD problems, nothing major.

---

**Current State**

- The fundamental design for the planter is done (it will probably change again :))

---

**Next Step**

- Start working on the basic layout of the internal components
- Make the design actually manufacturable.

---

## 6. Timelapse - 05.10.2026 - 11.10.2026

I will continue with this format of journaling, a whole week at once since i mostly work with software
and either log timalapses when doing CAD designs or art. But i dont remember which days i actually log my time so
its easier for me to just do it like this.

---

**What i did:**

- I fixed some inconsistencies in the cad model
- I also fixed some tolerance problems in the cad model
- I came up with the piping design in the planters
- And i also learned about plumbing along the way :)

---

**Problems that i've faced**

- How bad plumbing tutorials and websites were. If it werent for ai to help me research and help me understand
- theese things i would have never understood it because of how bad their websites are.

---

**Current State**

- The CAD design is in good shape right now. Its still not manufacturable tough.
- We have the piping system designed.

---

**Next Step**

- Start working on designing the piping and the fitment of everything in CAD
- Make the overall CAD design more realistic
- Also i was thinking about kind of making a mascot for the brand or something like that but im not sure yet.

[View piping design SVG](Documentation/growhub_water_route_v1.svg)

---
