Ajakovski/GrowHub/Hardware/Floor_PCB/Floor_PCB_Print.pdf

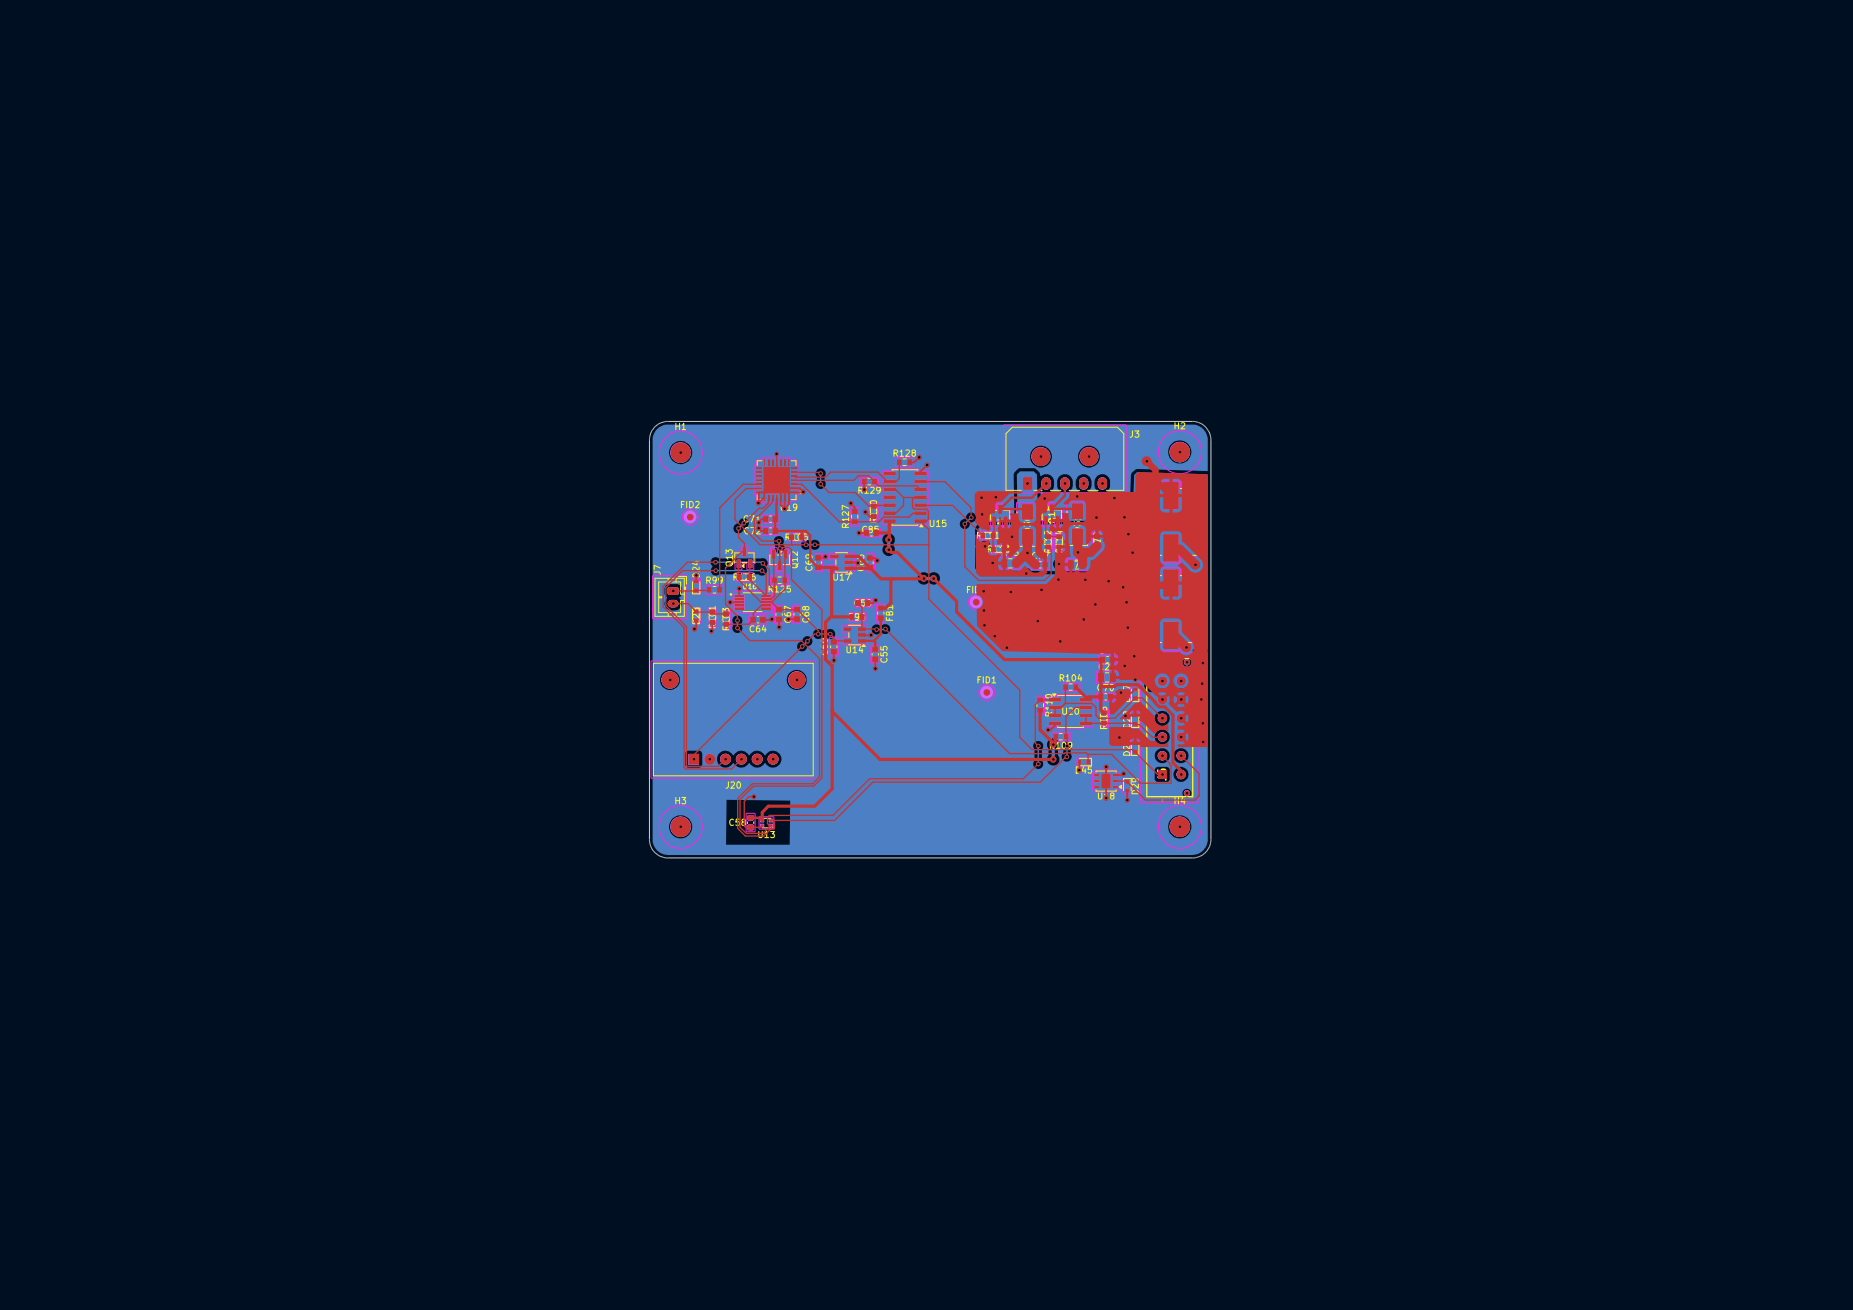
[picture p93: page 1]
