Ajakovski/GrowHub/Hardware/Floor_PCB/Floor_SCH_Print.pdf

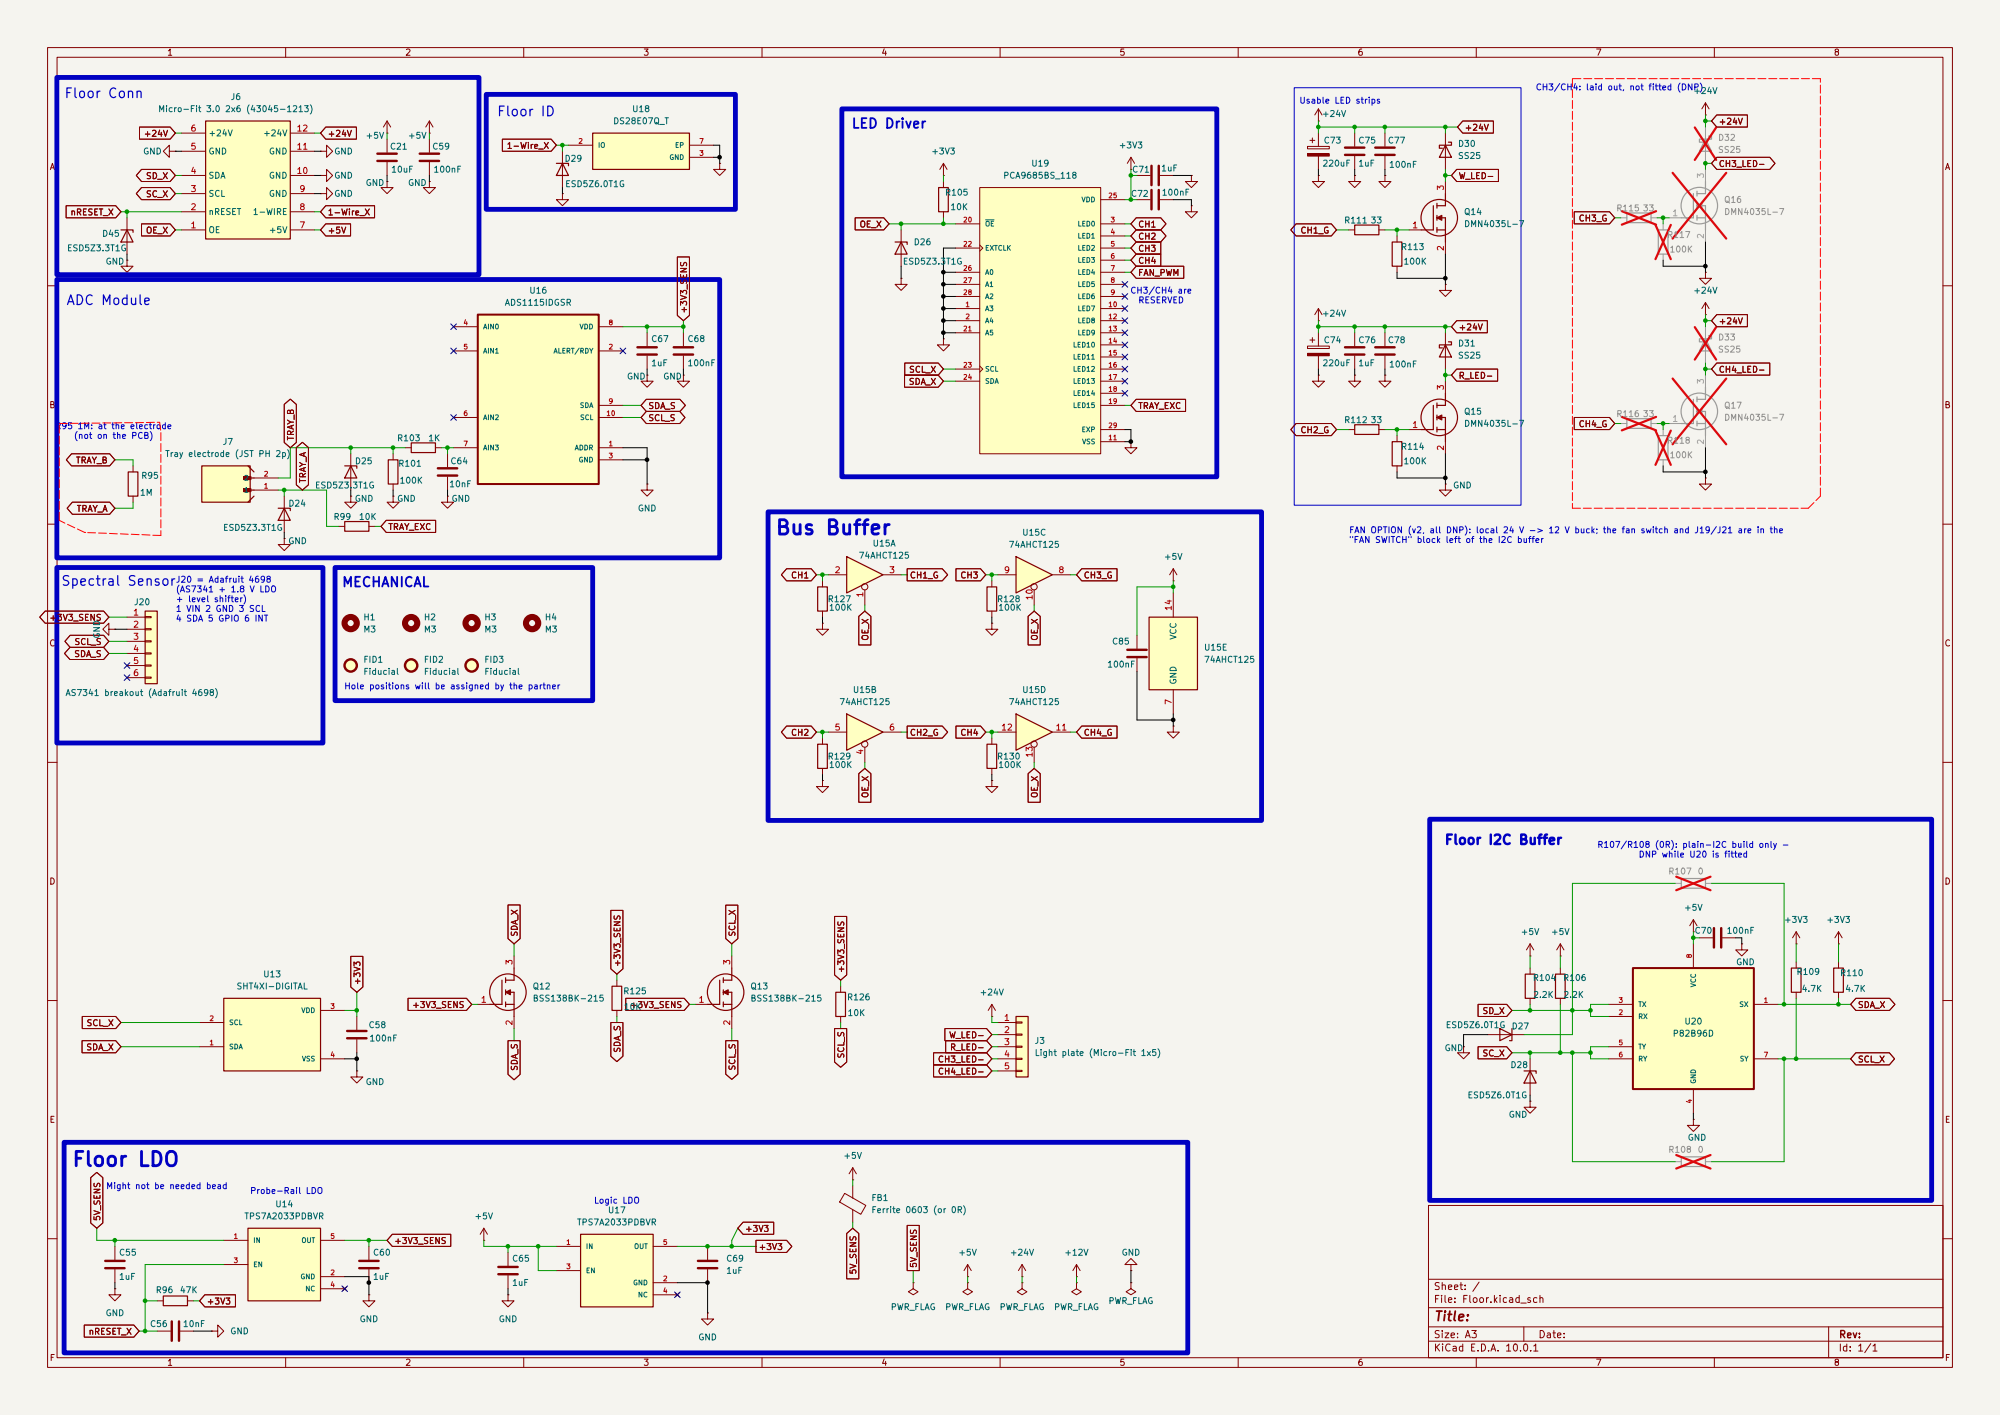
[picture p94: page 1]
