Ajakovski/GrowHub/Hardware/Main_PCB/Main_Floor_Sch_PDF.pdf

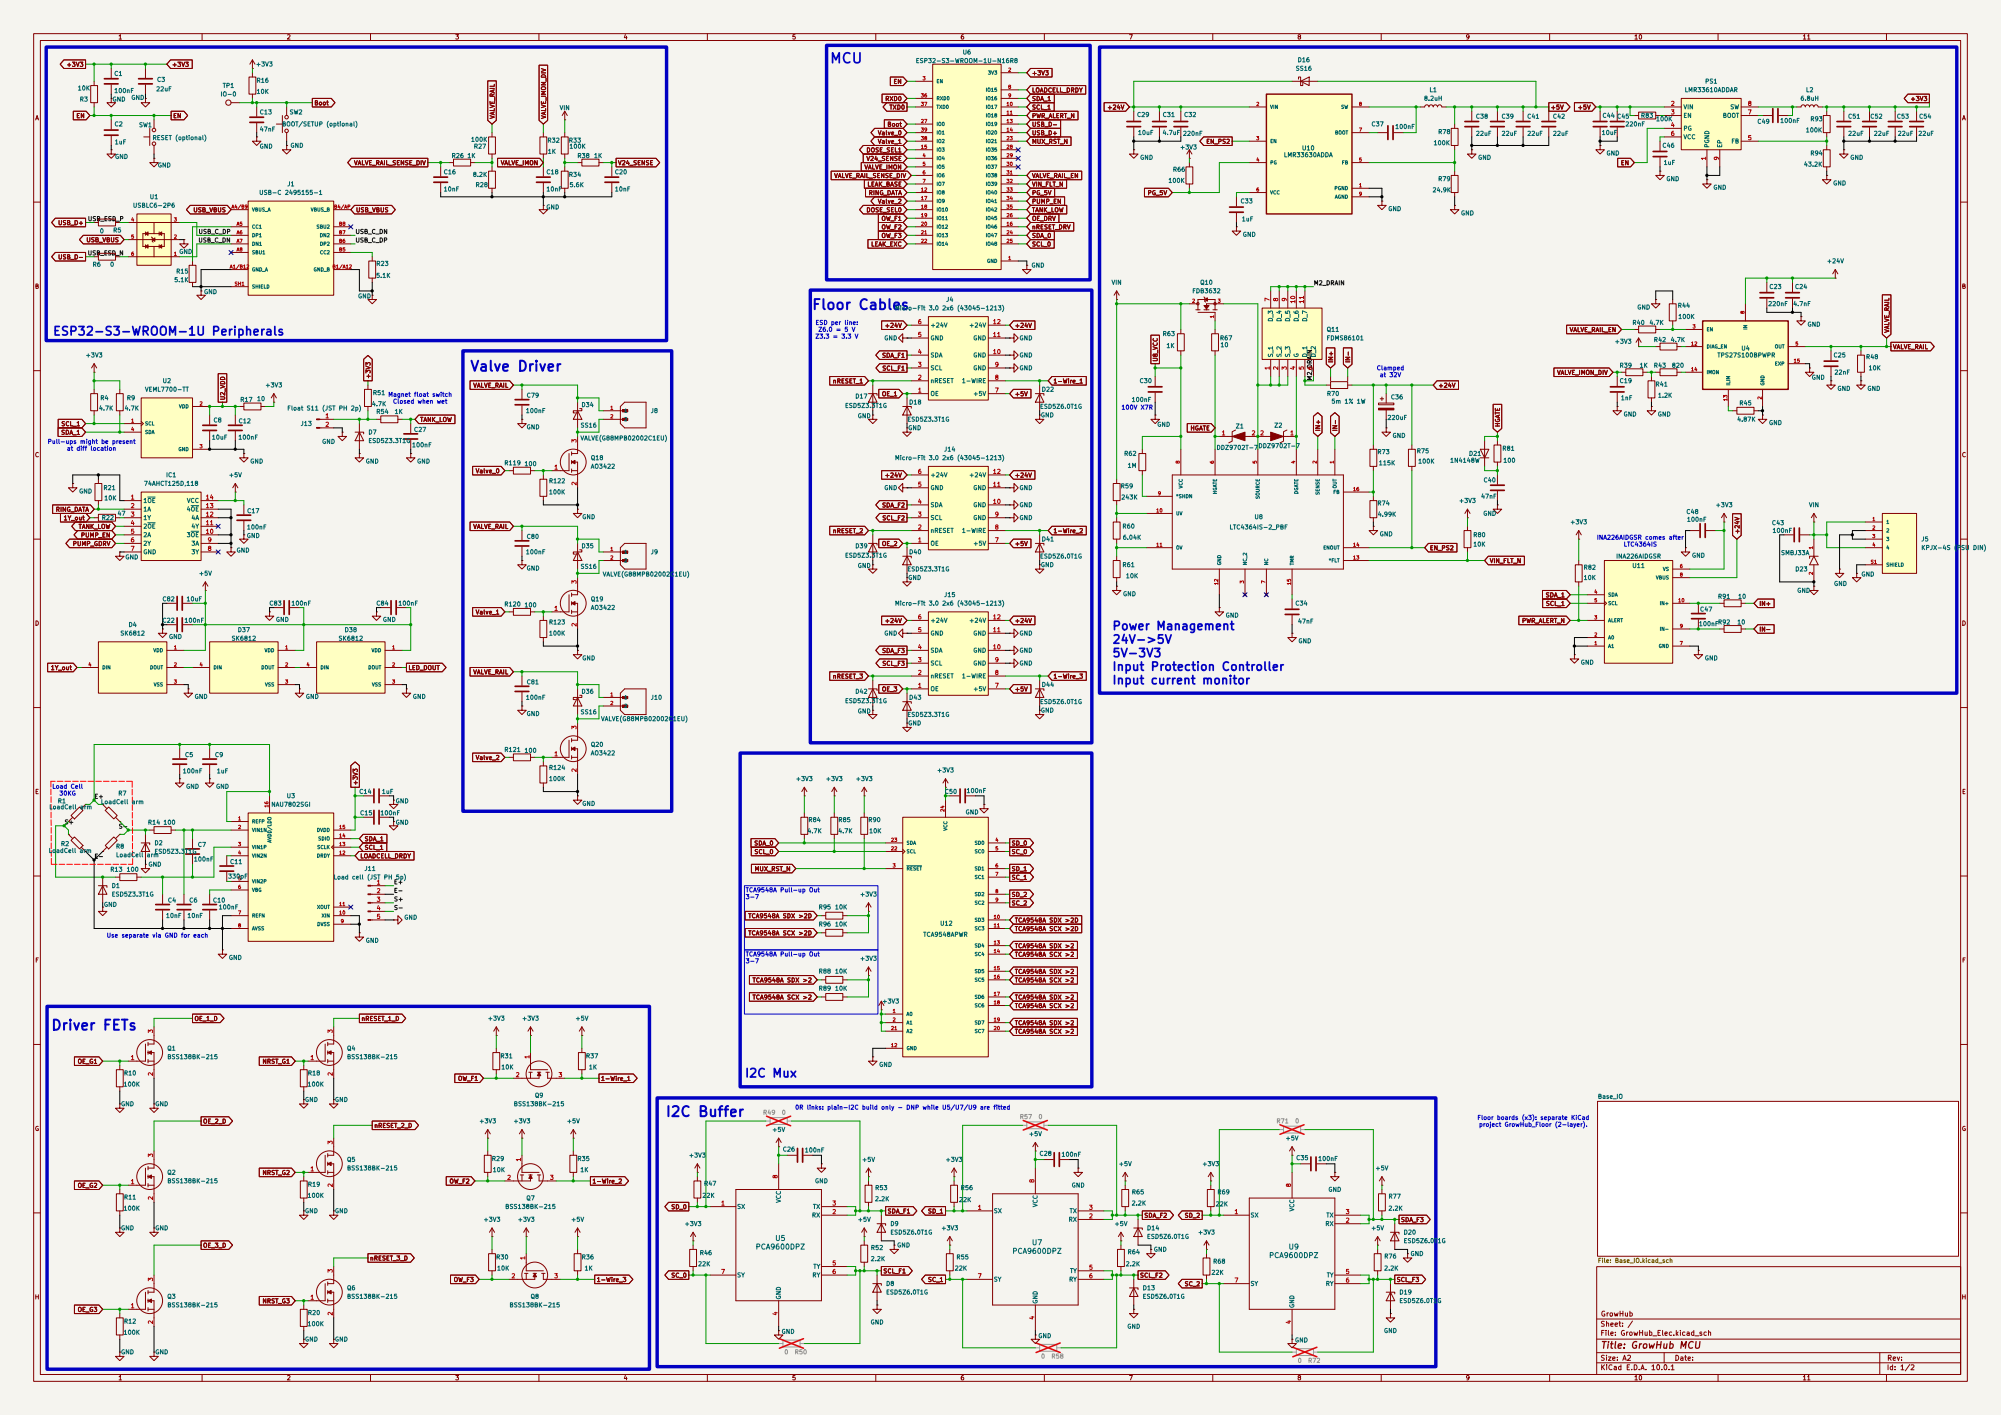
[picture p95: page 1]

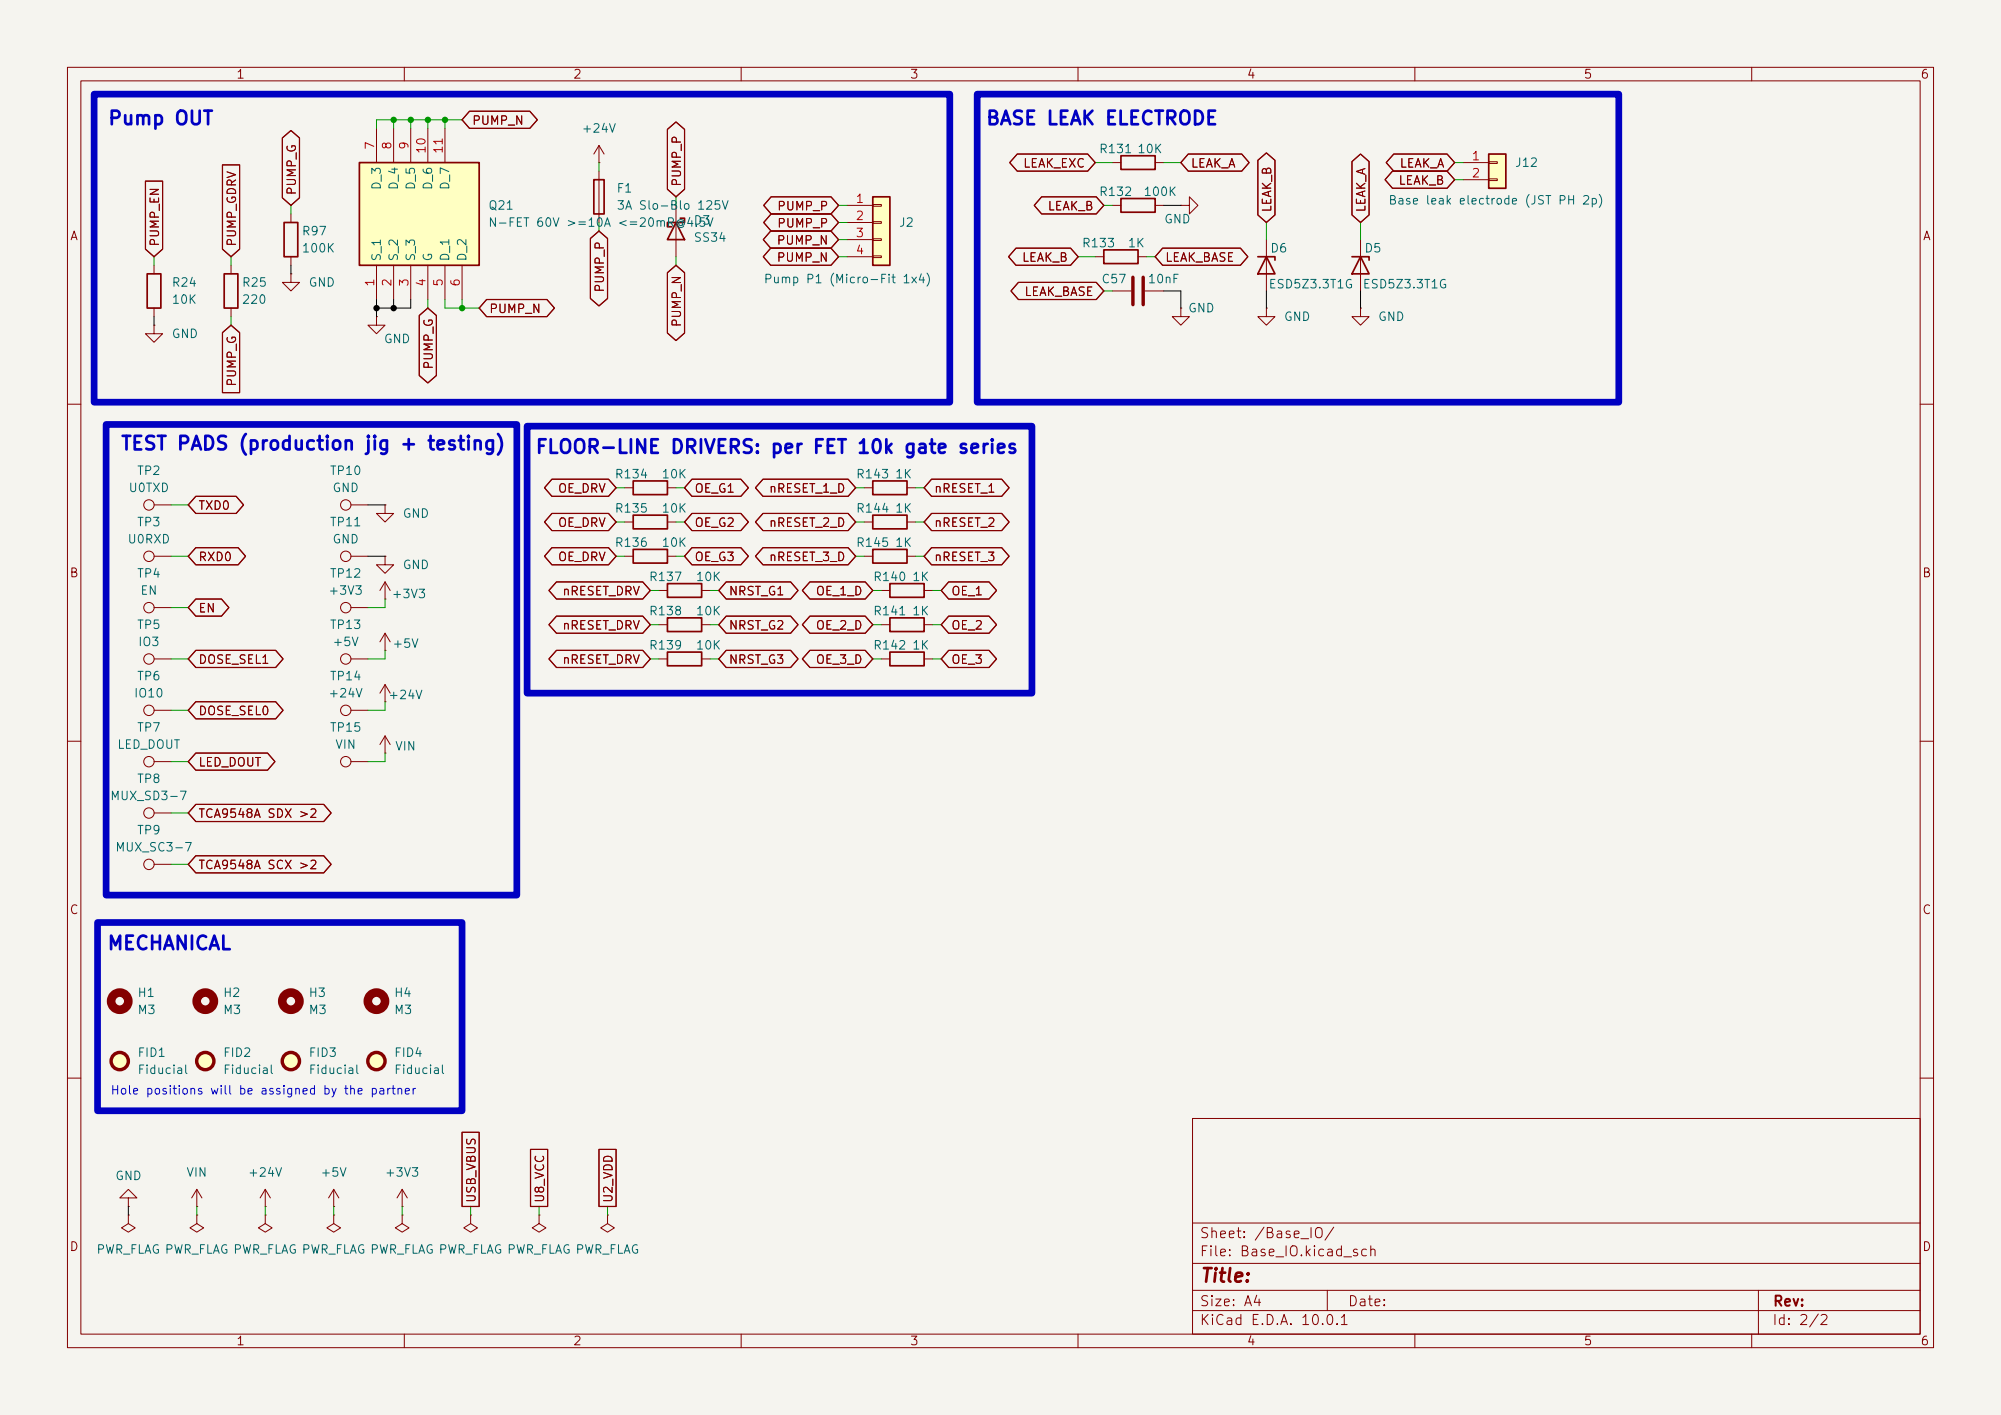
[picture p96: page 2]
