Ajakovski/GrowHub/Hardware/Main_PCB/Main_PCB_Print.pdf

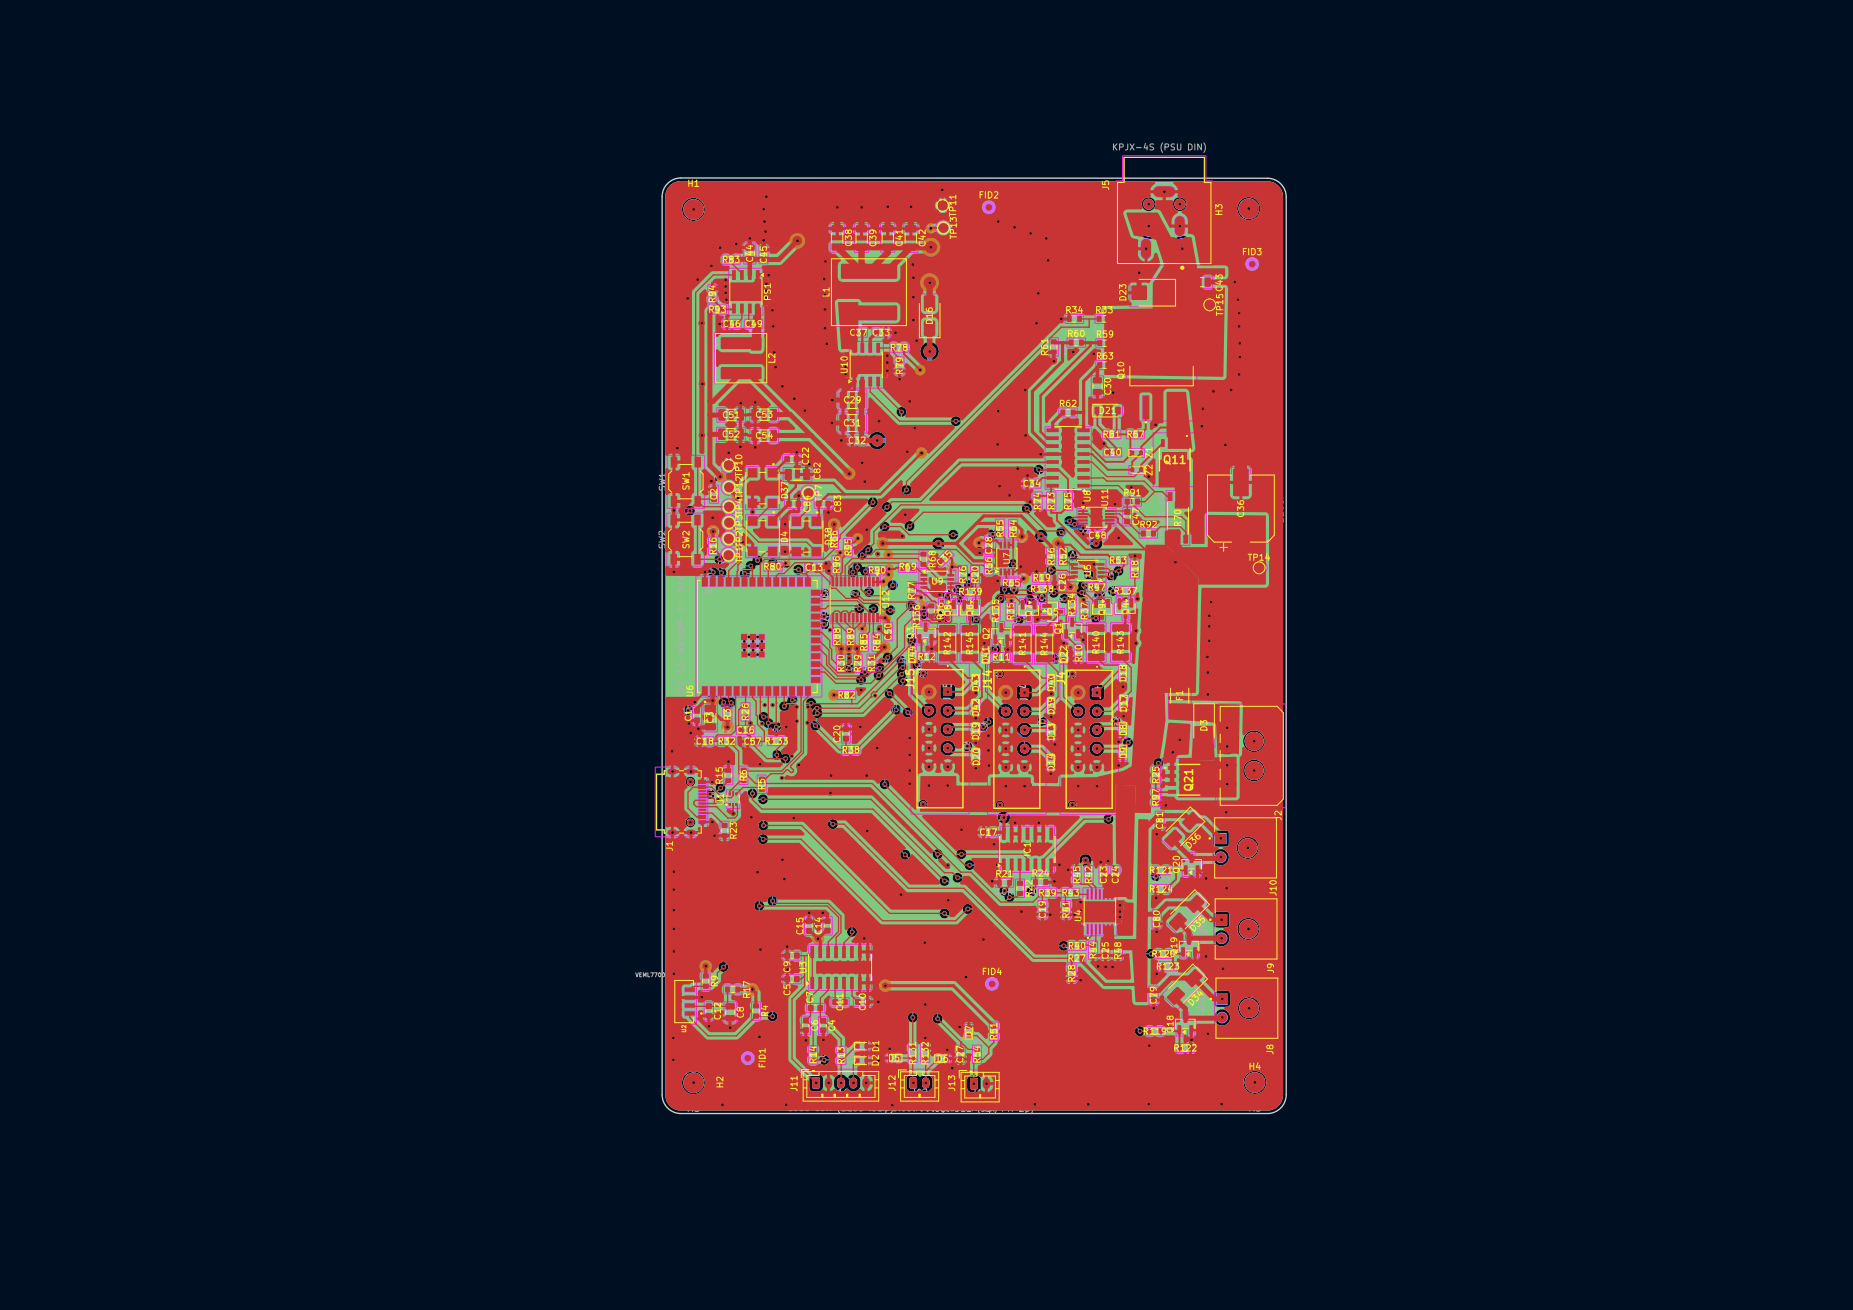
[picture p97: page 1]
