Ajakovski/GrowHub/Hardware/Floor_PCB/Floor.kicad_pcb

## KiCad design Hardware/Floor_PCB/Floor.kicad_pcb (2026-11-07)

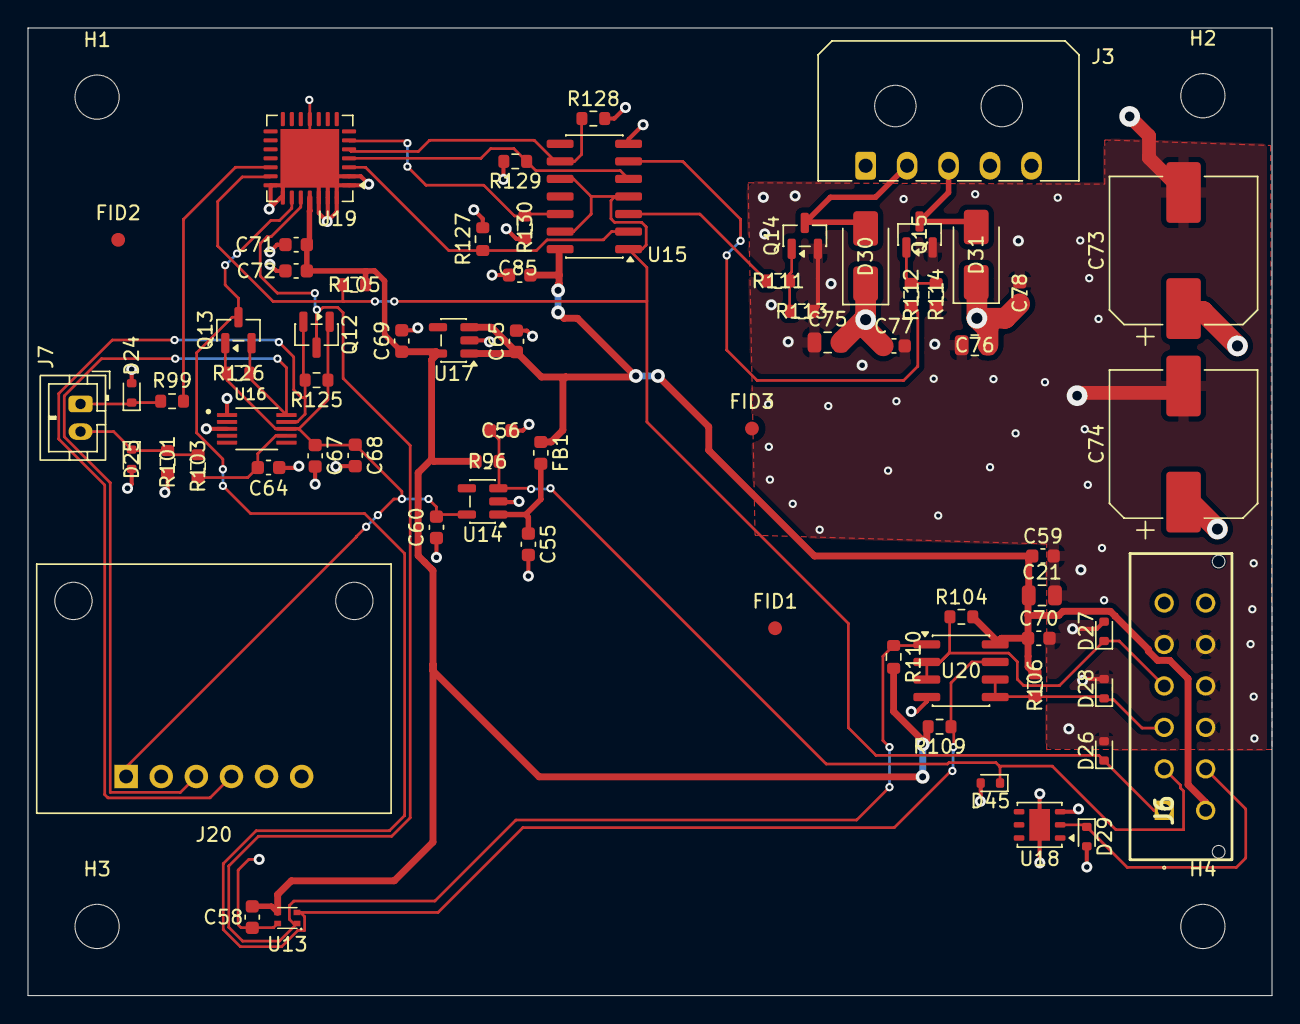
[picture p98: board Floor.kicad_pcb from above]

Board: 2 copper layers, 90.0 x 70.0 mm, 73 parts (0 on the bottom side), 29 nets.

Parts:
C21: 10uF; C_0805_2012Metric
C55, C60, C65, C67, C69, C71: 1uF; C_0603_1608Metric
C56, C64: 10nF; C_0603_1608Metric
C58, C59, C68, C70, C72, C77, C78, C85: 100nF; C_0603_1608Metric
C73, C74: 220uF; CP_Elec_10x10.5
C75, C76: 1uF; C_0805_2012Metric
D24, D25, D26, D45: ESD5Z3.3T1G; D_SOD-523
D27, D28, D29: ESD5Z6.0T1G; D_SOD-523
D30, D31: SS25; D_SMA
FB1: Ferrite 0603 (or 0R); L_0603_1608Metric
FID1, FID2, FID3: Fiducial; Fiducial_1mm_Mask2mm
H1, H2, H3, H4: M3; MountingHole_3.2mm_M3
J3: Light plate (Micro-Fit 1x5); Molex_Micro-Fit_3.0_43650-0500_1x05_P3.00mm_Horizontal
J6: Micro-Fit 3.0 2x6 (43045-1213); 0430451213
J7: Tray electrode (JST PH 2p); JST_PH_B2B-PH-K_1x02_P2.00mm_Vertical
J20: AS7341 breakout (Adafruit 4698); Adafruit_4698_AS7341_Breakout
Q12, Q13: BSS138BK-215; SOT-23
Q14, Q15: DMN4035L-7; SOT-23
R96: 47K; R_0603_1608Metric
R99, R105, R125, R126: 10K; R_0603_1608Metric
R101, R113, R114, R127, R128, R129, R130: 100K; R_0603_1608Metric
R103: 1K; R_0603_1608Metric
R104, R106: 2.2K; R_0603_1608Metric
R109, R110: 4.7K; R_0603_1608Metric
R111, R112: 33; R_0603_1608Metric
U13: SHT4XI-DIGITAL
U14, U17: TPS7A2033PDBVR; SOT-23-5
U15: 74AHCT125; SOIC-14_3.9x8.7mm_P1.27mm
U16: ADS1115IDGSR; SOP50P490X110-10N
U18: DS28E07Q_T; Maxim_TDFN-6-1EP_3x3mm_P0.95mm_EP1.5x2.3mm
U19: PCA9685BS_118; QFN-28-1EP_6x6mm_P0.65mm_EP4.25x4.25mm
U20: P82B96D; SOIC-8_3.9x4.9mm_P1.27mm

Connections:
1-Wire_X: D29.1 (K), J6.8 (1-WIRE), U18.2 (IO)
5V_SENS: C55.1, FB1.2, U14.1 (IN)
+3V3: C58.2, C69.1, C71.1, C72.1, R96.2, R105.1, R109.2, R110.2, U13.3 (VDD), U17.5 (OUT), U19.25 (VDD)
+3V3_SENS: C60.1, C67.1, C68.1, J20.1, Q12.1 (G), Q13.1 (G), R125.1, R126.1, U14.5 (OUT), U16.8 (VDD)
+5V: C21.1, C59.1, C65.1, C70.1, C85.1, FB1.1, J6.7 (+5V), R104.2, R106.2, U15.14 (VCC), U17.1 (IN), U17.3 (EN), U20.8 (VCC)
+24V: C73.1, C74.1, C75.2, C76.2, C77.1, C78.1, D30.1 (K), D31.1 (K), J3.1, J6.6 (+24V), J6.12 (+24V)
CH1: R127.1, U15.2, U19.3 (LED0)
CH1_G: R111.1, U15.3
CH2: R129.1, U15.5, U19.4 (LED1)
CH2_G: R112.1, U15.6
CH3: R128.1, U15.9, U19.5 (LED2)
CH4: R130.1, U15.12, U19.6 (LED3)
GND: C21.2, C55.2, C56.2, C58.1, C59.2, C60.2, C64.2, C65.2, C67.2, C68.2, C69.2, C70.2, C71.2, C72.2, C73.2, C74.2, C75.1, C76.1, C77.2, C78.2, C85.2, D24.2 (A), D25.2 (A), D26.2 (A), D27.2 (A), D28.2 (A), D29.2 (A), D45.2 (A), J6.5 (GND), J6.9 (GND), J6.10 (GND), J6.11 (GND), J20.2, Q14.2 (S), Q15.2 (S), R101.1, R113.2, R114.2, R127.2, R128.2, R129.2, R130.2, U13.4 (VSS), U14.2 (GND), U15.7 (GND), U16.1 (ADDR), U16.3 (GND), U17.2 (GND), U18.3 (GND), U18.7 (EP), U19.1 (A3), U19.2 (A4), U19.11 (VSS), U19.21 (A5), U19.22 (EXTCLK), U19.26 (A0), U19.27 (A1), U19.28 (A2), U19.29 (EXP), U20.4 (GND)
unnamed: Q14.1 (G), R111.2, R113.1
unnamed: Q15.1 (G), R112.2, R114.1
unnamed: C64.1, R103.1, U16.7 (AIN3)
OE_X: D26.1 (K), J6.1 (OE), R105.2, U15.1, U15.4, U15.10, U15.13, U19.20 (~OE)
R_LED-: D31.2 (A), J3.3, Q15.3 (D)
SCL_S: J20.3, Q13.2 (S), R126.2, U16.10 (SCL)
SCL_X: Q13.3 (D), R109.1, U13.2 (SCL), U19.23 (SCL), U20.7 (SY)
SC_X: D28.1 (K), J6.3 (SCL), R106.1, U20.5 (TY), U20.6 (RY)
SDA_S: J20.4, Q12.2 (S), R125.2, U16.9 (SDA)
SDA_X: Q12.3 (D), R110.1, U13.1 (SDA), U19.24 (SDA), U20.1 (SX)
SD_X: D27.1 (K), J6.4 (SDA), R104.1, U20.2 (RX), U20.3 (TX)
TRAY_A: D24.1 (K), J7.1, R99.2
TRAY_B: D25.1 (K), J7.2, R101.2, R103.2
TRAY_EXC: R99.1, U19.19 (LED15)
W_LED-: D30.2 (A), J3.2, Q14.3 (D)
nRESET_X: C56.1, D45.1 (K), J6.2 (nRESET), R96.1, U14.3 (EN)
