Ajakovski/GrowHub/Hardware/Main_PCB/GrowHub_Elec.kicad_pcb

## KiCad design Hardware/Main_PCB/GrowHub_Elec.kicad_pcb (2026-11-07)

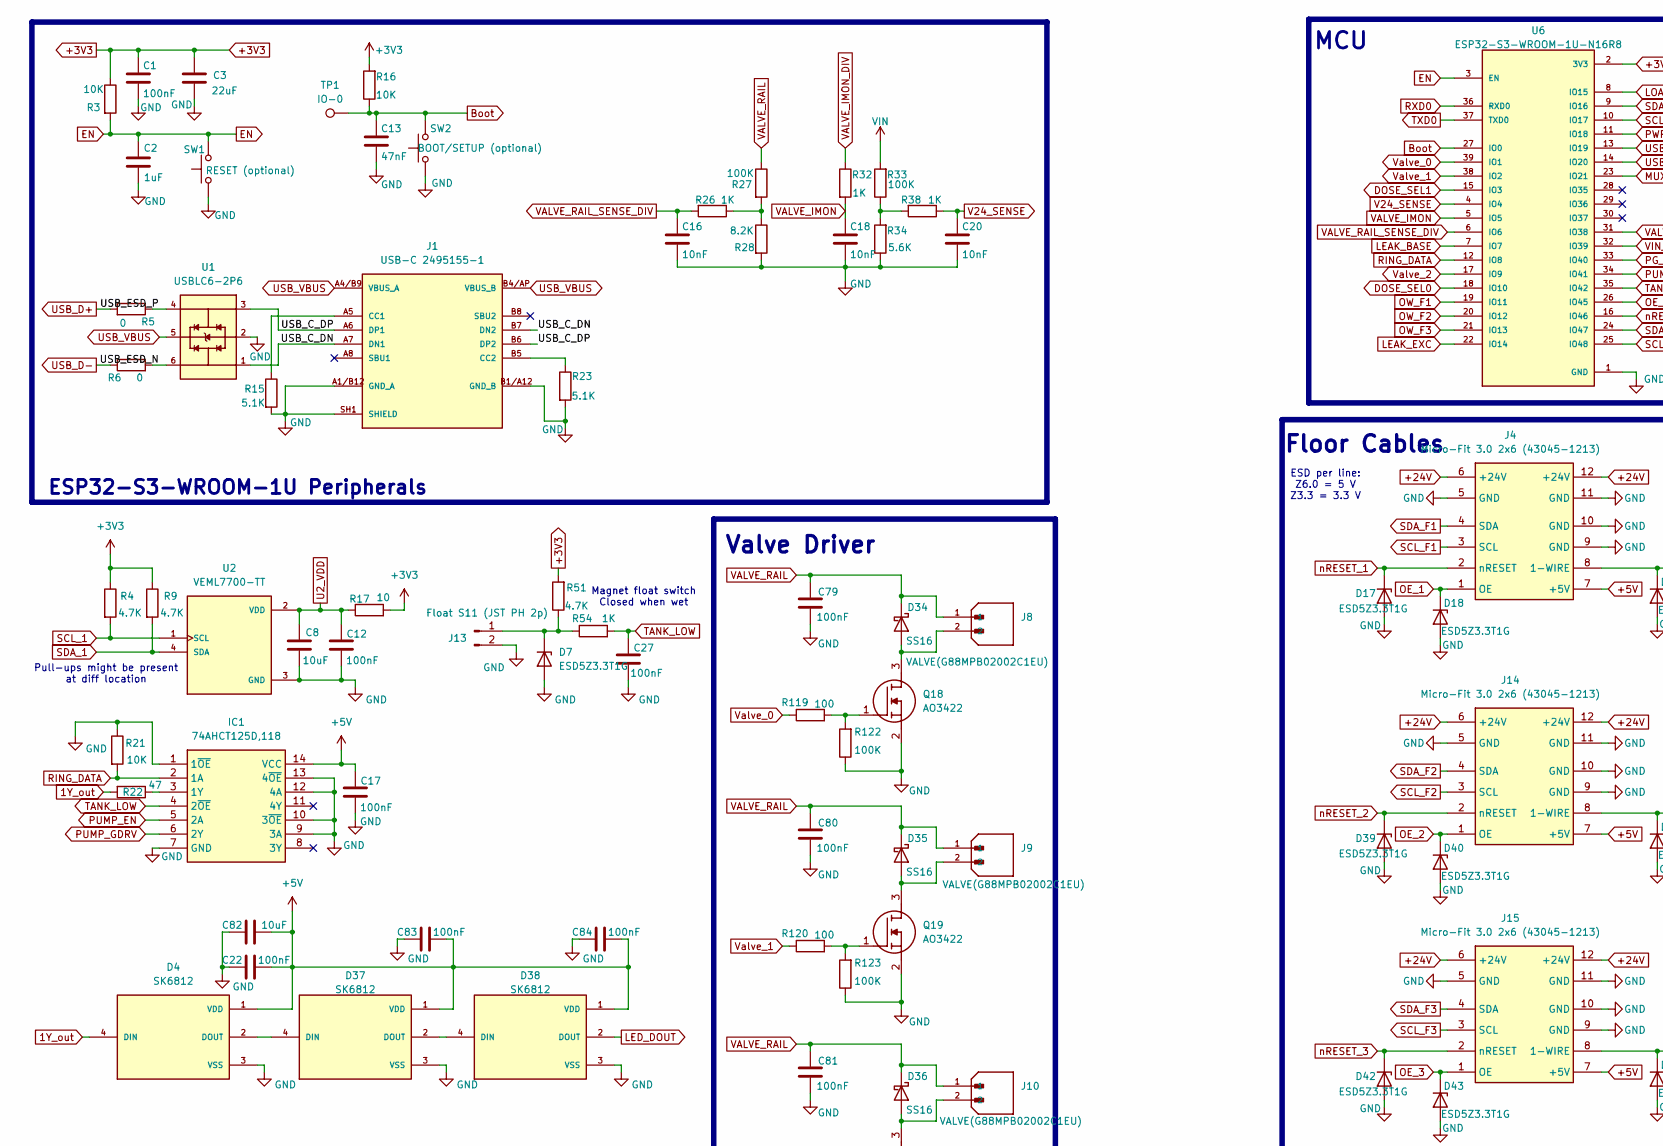
[picture p99: schematic GrowHub_Elec.kicad_sch, GrowHub MCU, part in row 1, column 1]

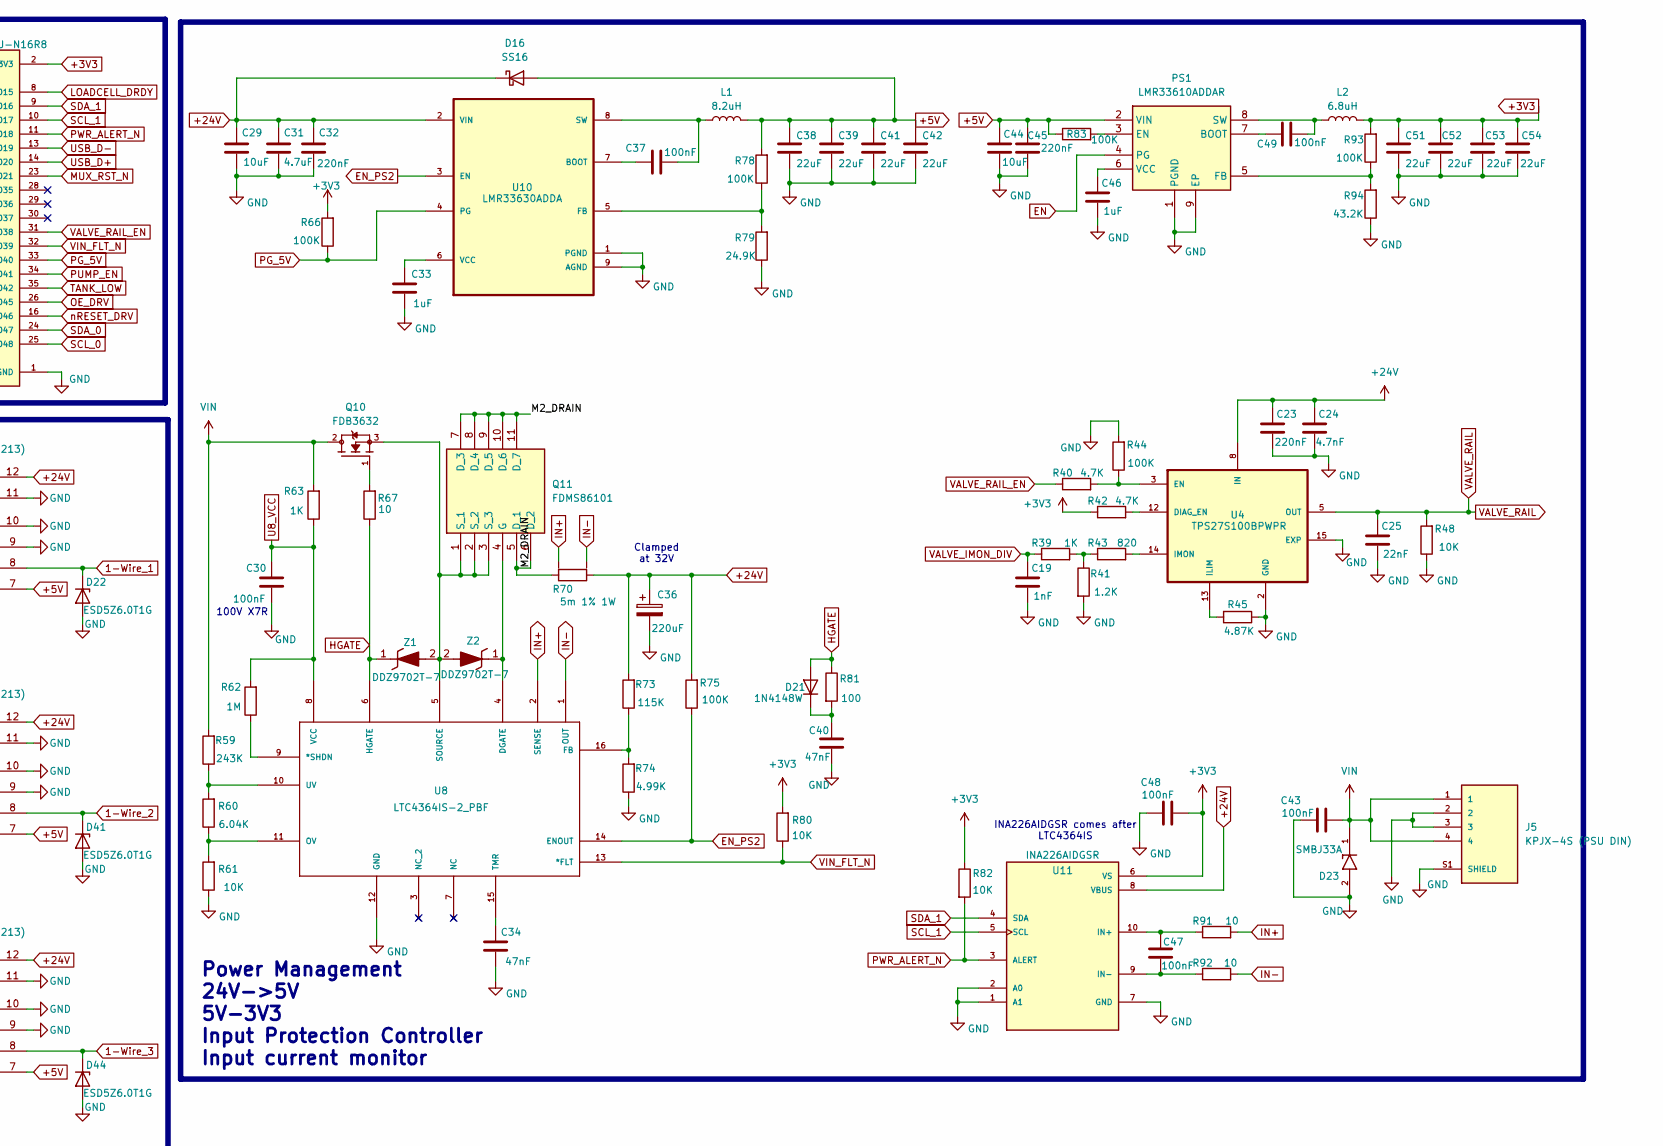
[picture p100: schematic GrowHub_Elec.kicad_sch, GrowHub MCU, part in row 1, column 2]

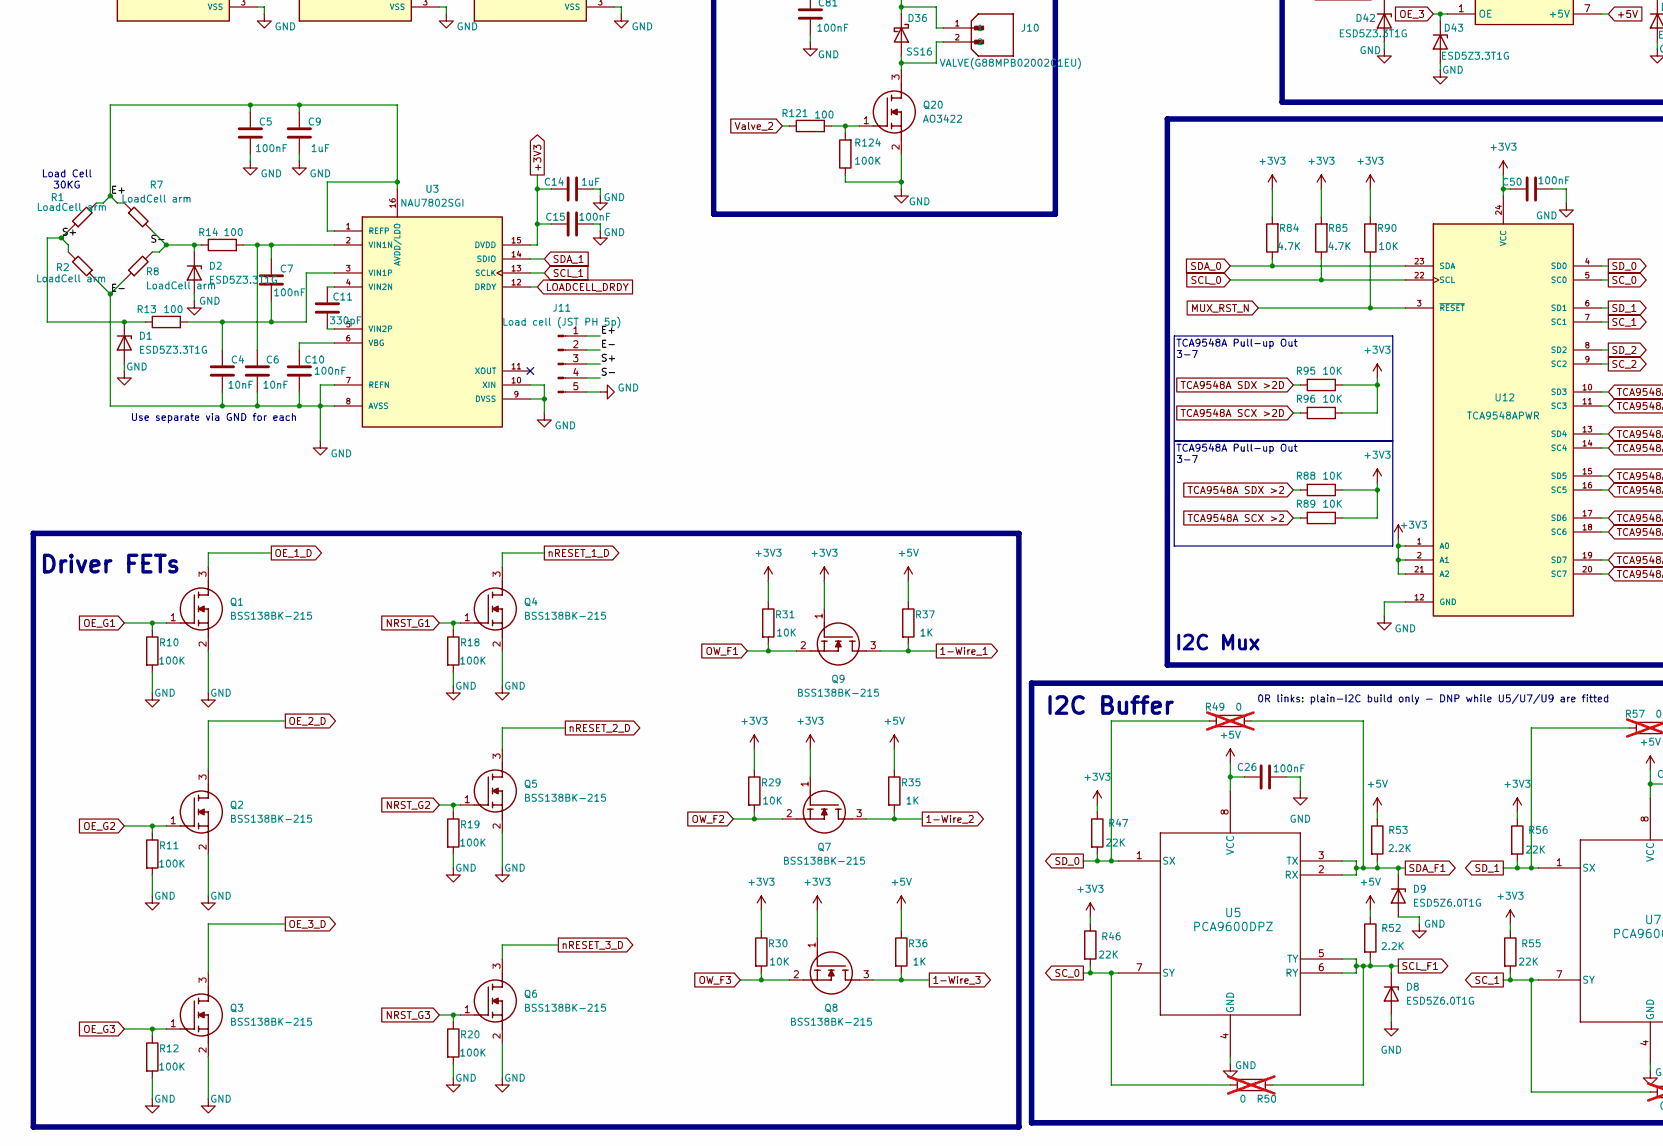
[picture p101: schematic GrowHub_Elec.kicad_sch, GrowHub MCU, part in row 2, column 1]

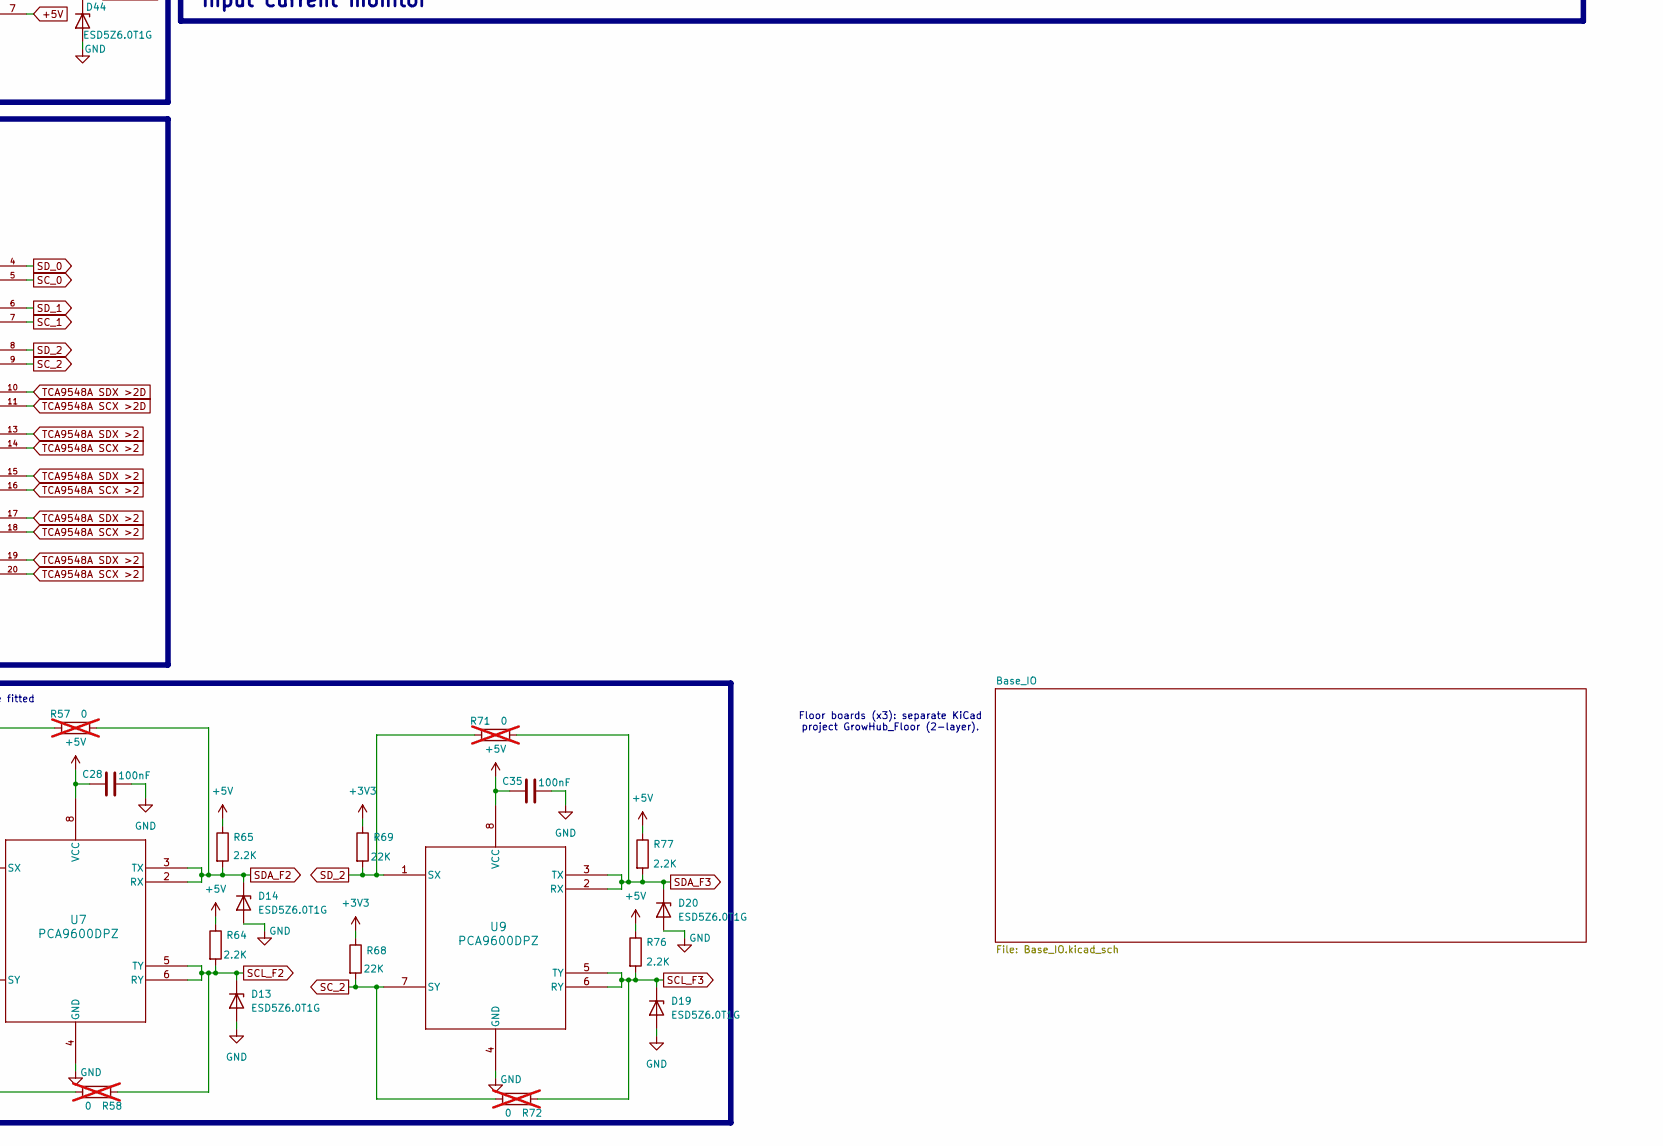
[picture p102: schematic GrowHub_Elec.kicad_sch, GrowHub MCU, part in row 2, column 2]

Parts:
C1, C5, C7, C10, C12, C15, C17, C22, C26, C27, C28, C35, C37, C48, C49, C50, C83, C84: 100nF; C_0603_1608Metric; Rating 16V X7R
C2, C9, C14, C33, C46: 1uF; C_0603_1608Metric; Rating 16V X7R
C3, C51, C52, C53, C54: 22uF; C_1206_3216Metric; Rating 10V X7R
C4, C6: 10nF; C_0603_1608Metric; Rating 50V C0G
C8: 10uF; C_0805_2012Metric; Rating 10V X7R
C11: 330pF; C_0603_1608Metric; Rating 50V C0G
C13: 47nF; C_0603_1608Metric; Rating 16V X7R
C16, C18, C20: 10nF; C_0603_1608Metric; Rating 16V X7R
C19: 1nF; C_0603_1608Metric; Rating 50V C0G
C23, C32: 220nF; C_0603_1608Metric; Rating 50V X7R
C24: 4.7nF; C_0603_1608Metric; Rating 50V X7R
C25: 22nF; C_0603_1608Metric; Rating 50V X7R
C29: 10uF; C_1210_3225Metric; Rating 50V X7R
C30, C43: 100nF; C_0805_2012Metric; Rating 100V X7R
C31: 4.7uF; C_1210_3225Metric; Rating 50V X7R
C34: 47nF; C_0603_1608Metric; Rating 25V X7R
C36: 220uF; CP_Elec_10x10.5; Rating 50V low-ESR aluminium, >=105 C
C38, C39, C41, C42: 22uF; C_1206_3216Metric; Rating 16V X7R
C40: 47nF; C_0603_1608Metric; Rating 50V X7R
C44: 10uF; C_0805_2012Metric; Rating 16V X7R
C45: 220nF; C_0603_1608Metric; Rating 16V X7R
C47, C79, C80, C81: 100nF; C_0603_1608Metric; Rating 50V X7R
C82: 10uF; C_1206_3216Metric; Rating 16V X7R
D1, D2, D7, D17, D18, D39, D40, D42, D43: ESD5Z3.3T1G; D_SOD-523
D4, D37, D38: SK6812; LED_SK6812; PARTREV 03
D8, D9, D13, D14, D19, D20, D22, D41, D44: ESD5Z6.0T1G; D_SOD-523
D16, D34, D35, D36: SS16; D_SMA
D21: 1N4148W; D_SOD-123
D23: SMBJ33A; D_SMB; PARTREV 20 - 2
IC1: 74AHCT125D,118; SOIC-14_3.9x8.7mm_P1.27mm; Mouser Part Number 771-AHCT125D118
J1: USB-C 2495155-1; TE_2495155-1; PARTREV A
J4, J14, J15: Micro-Fit 3.0 2x6 (43045-1213); 0430451213; Mouser Part Number N/A
J5: KPJX-4S (PSU DIN); KYCON_KPJX-4S; PARTREV A12
J8, J9, J10: VALVE(G88MPB02002C1EU); AMPHENOL_G88MPB02002C1EU; PARTREV C
J11: Load cell (JST PH 5p); JST_PH_B5B-PH-K_1x05_P2.00mm_Vertical
J13: Float S11 (JST PH 2p); JST_PH_B2B-PH-K_1x02_P2.00mm_Vertical
L1: 8.2uH; L_Coilcraft_XAL1010-XXX; MPN Coilcraft XAL1010-822MED (12.9 mOhm max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
L2: 6.8uH; L_Coilcraft_XAL7070-XXX; MPN Coilcraft XAL7070-682MEC (19.6 mOhm max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
PS1: LMR33610ADDAR; Texas_HSOP-8-1EP_3.9x4.9mm_P1.27mm_ThermalVias; Mouser Part Number 595-LMR33610ADDAR
Q1, Q2, Q3, Q4, Q5, Q6, Q7, Q8, Q9: BSS138BK-215; SOT-23
Q10: FDB3632; TO254P1524X483-3N; PARTREV 4
Q11: FDMS86101; FDMS86252; Mouser Part Number 512-FDMS86101
Q18, Q19, Q20: AO3422; SOT-23
R1, R2, R7, R8: LoadCell arm
R3, R16, R21, R29, R30, R31, R48, R80, R82, R88, R89, R90, R95, R96: 10K; R_0603_1608Metric
R4, R9, R40, R42, R51, R84, R85: 4.7K; R_0603_1608Metric
R5, R6: 0; R_0603_1608Metric
R10, R11, R12, R18, R19, R20, R44, R66, R75, R83, R122, R123, R124: 100K; R_0603_1608Metric
R13, R14, R81, R119, R120, R121: 100; R_0603_1608Metric
R15, R23: 5.1K; R_0603_1608Metric
R17, R67, R91, R92: 10; R_0603_1608Metric
R22: 47; R_0603_1608Metric
R26, R32, R38: 1K; R_0603_1608Metric; Tolerance 1%
R27, R33, R78, R93: 100K; R_0603_1608Metric; Tolerance 1%
R28: 8.2K; R_0603_1608Metric; Tolerance 1%
R34: 5.6K; R_0603_1608Metric; Tolerance 1%
R35, R36, R37, R39, R54, R63: 1K; R_0603_1608Metric
R41: 1.2K; R_0603_1608Metric; Tolerance 1%
R43: 820; R_0603_1608Metric; Tolerance 1%
R45: 4.87K; R_0603_1608Metric; Tolerance 1%
R46, R47, R55, R56, R68, R69: 22K; R_0603_1608Metric
R49, R50, R57, R58, R71, R72: 0; R_0603_1608Metric; not fitted
R52, R53, R64, R65, R76, R77: 2.2K; R_0603_1608Metric
R59: 243K; R_0603_1608Metric; Tolerance 1%
R60: 6.04K; R_0603_1608Metric; Tolerance 1%
R61: 10K; R_0603_1608Metric; Tolerance 1%
R62: 1M; R_0603_1608Metric
R70: 5m 1% 1W; R_Shunt_Vishay_WSK2512_6332Metric_T1.19mm; MPN Vishay WSK2512R0050FEA (5 mOhm 1% 1 W, 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
R73: 115K; R_0603_1608Metric; Tolerance 1%
R74: 4.99K; R_0603_1608Metric; Tolerance 1%
R79: 24.9K; R_0603_1608Metric; Tolerance 1%
R94: 43.2K; R_0603_1608Metric; Tolerance 1%
SW1: RESET (optional); SW_SPST_TL3342
SW2: BOOT/SETUP (optional); SW_SPST_TL3342
TP1: IO-0; TestPoint_Pad_D1.5mm
U1: USBLC6-2P6; SOT-666; PARTREV 5
U2: VEML7700-TT; XDCR_VEML7700-TT; PARTREV 1.6
U3: NAU7802SGI; SOIC-16_3.9x9.9mm_P1.27mm; PARTREV 2.6
U4: TPS27S100BPWPR; IC_TPS27S100BPWPR
U5, U7, U9: PCA9600DPZ; TSSOP-8_3x3mm_P0.65mm
U6: ESP32-S3-WROOM-1U-N16R8; XCVR_ESP32-S3-WROOM-1U-N16R8; PARTREV v1.1
U8: LTC4364IS-2_PBF; SOIC-16_3.9x9.9mm_P1.27mm; MANUFACTURER_PART_NUMBER ltc4364is2#pbf
U10: LMR33630ADDA; Texas_HSOP-8-1EP_3.9x4.9mm_P1.27mm_ThermalVias
U11: INA226AIDGSR; TSSOP-10_3x3mm_P0.5mm; PARTREV B
U12: TCA9548APWR; TSSOP-24_4.4x7.8mm_P0.65mm; PARTREV G
Z1, Z2: DDZ9702T-7; D_SOD-523; Mouser Part Number 621-DDZ9702T-7

Connections:
1-Wire_1: D22.1 (K), J4.8 (1-WIRE), Q9.3 (D), R37.2
1-Wire_2: D41.1 (K), J14.8 (1-WIRE), Q7.3 (D), R35.2
1-Wire_3: D44.1 (K), J15.8 (1-WIRE), Q8.3 (D), R36.2
1Y_out: D4.4 (DIN), R22.2
+3V3: C1.1, C3.1, C14.1, C15.1, C48.1, C50.2, C51.2, C52.2, C53.2, C54.2, L2.2, Q7.1 (G), Q8.1 (G), Q9.1 (G), R3.1, R4.1, R9.1, R16.2, R17.2, R29.1, R30.1, R31.1, R42.1, R46.1, R47.1, R51.2, R55.1, R56.1, R66.2, R68.1, R69.1, R80.2, R82.1, R84.2, R85.2, R88.1, R89.1, R90.2, R93.2, R95.1, R96.1, U3.15 (DVDD), U6.2 (3V3), U11.6 (VS), U12.1 (A0), U12.2 (A1), U12.21 (A2), U12.24 (VCC); also elsewhere on the board
+5V: C17.1, C22.2, C26.2, C28.2, C35.2, C38.2, C39.2, C41.2, C42.2, C44.2, C45.2, C82.2, C83.2, C84.2, D4.1 (VDD), D16.2 (A), D37.1 (VDD), D38.1 (VDD), IC1.14 (VCC), J4.7 (+5V), J14.7 (+5V), J15.7 (+5V), L1.2, PS1.2 (VIN), R35.1, R36.1, R37.1, R52.1, R53.1, R64.1, R65.1, R76.1, R77.1, R78.2, R83.1, U5.8 (VCC), U7.8 (VCC), U9.8 (VCC); also elsewhere on the board
+24V: C23.2, C24.2, C29.2, C31.2, C32.2, C36.1, D16.1 (K), J4.6 (+24V), J4.12 (+24V), J14.6 (+24V), J14.12 (+24V), J15.6 (+24V), J15.12 (+24V), R70.4 (F2), R73.2, R75.2, U4.8 (IN), U4.9 (IN), U4.10 (IN), U10.2 (VIN), U11.8 (VBUS); also elsewhere on the board
/E+: C5.1, C9.1, J11.1 (E+), R1.2, R7.1, U3.1 (REFP), U3.16 (AVDD/LDO)
/M2_DRAIN: Q11.5 (D_1), Q11.6 (D_2), Q11.7 (D_3), Q11.8 (D_4), Q11.9 (D_5), Q11.10 (D_6), Q11.11 (D_7), R70.1 (F1)
/S+: D1.1 (K), J11.3 (S+), R1.1, R2.2, R13.1
/S-: D2.1 (K), J11.4 (S-), R7.2, R8.2, R14.1
/USB_C_DN: J1.A7 (DN1), J1.B7 (DN2), U1.1
/USB_C_DP: J1.A6 (DP1), J1.B6 (DP2), U1.3
/USB_ESD_N: R6.2, U1.6
/USB_ESD_P: R5.1, U1.4
Boot: C13.1, R16.1, SW2.2, TP1.1 (1_1), U6.27 (IO0)
DOSE_SEL0: U6.18 (IO10)
DOSE_SEL1: U6.15 (IO3)
EN: C2.1, PS1.4 (PG), R3.2, SW1.2, U6.3 (EN); also elsewhere on the board
EN_PS2: R75.1, U8.14 (ENOUT), U10.3 (EN)
GND: C1.2, C2.2, C3.2, C4.2, C5.2, C6.2, C8.2, C9.2, C10.2, C12.2, C13.2, C14.2, C15.2, C16.2, C17.2, C18.2, C19.1, C20.2, C22.1, C23.1, C24.1, C25.1, C26.1, C27.2, C28.1, C29.1, C30.2, C31.1, C32.1, C33.2, C34.2, C35.1, C36.2, C38.1, C39.1, C40.2, C41.1, C42.1, C43.2, C44.1, C45.1, C46.1, C48.2, C50.1, C51.1, C52.1, C53.1, C54.1, C79.2, C80.2, C81.2, C82.1, C83.1, C84.1, D1.2 (A), D2.2 (A), D4.3 (VSS), D7.2 (A), D8.2 (A), D9.2 (A), D13.2 (A), D14.2 (A), D17.2 (A), D18.2 (A), D19.2 (A), D20.2 (A), D22.2 (A), D23.2, D37.3 (VSS), D38.3 (VSS), D39.2 (A), D40.2 (A), D41.2 (A), D42.2 (A), D43.2 (A), D44.2 (A), IC1.1 (1~OE), IC1.7 (GND), IC1.9 (3A), IC1.10 (3~OE), IC1.12 (4A), IC1.13 (4~OE), J1.A1/B12 (GND_A), J1.B1/A12 (GND_B), J1.SH1 (SHIELD), J1.SH2 (SHIELD), J1.SH3 (SHIELD), J1.SH4 (SHIELD), J4.5 (GND), J4.9 (GND), J4.10 (GND), J4.11 (GND), J5.2, J5.3, J5.S1 (SHIELD), J11.2 (E-), J11.5 (SH), J13.2, J14.5 (GND), J14.9 (GND), J14.10 (GND), J14.11 (GND), J15.5 (GND), J15.9 (GND), J15.10 (GND), J15.11 (GND), PS1.1 (PGND), PS1.9 (EP), Q1.2 (S), Q2.2 (S), Q3.2 (S), Q4.2 (S), Q5.2 (S), Q6.2 (S), Q18.2 (S), Q19.2 (S), Q20.2 (S), R2.1, R8.1, R10.2, R11.2, R12.2, R15.2, R18.2, R19.2, R20.2, R21.1, R23.2, R28.2, R34.1, R41.2, R44.2, R45.1, R48.1, R61.1, R74.1, R79.1, R94.1, R122.1, R123.1, R124.1, SW1.1, SW2.1, U1.2, U2.3 (GND), U3.7 (REFN), U3.8 (AVSS), U3.9 (DVSS), U3.10 (XIN), U4.2 (GND), U4.15 (EXP), U4.16 (EXP), U4.17 (EXP), U4.18 (EXP), U4.19 (EXP), U4.20 (EXP), U4.21 (EXP), U5.4 (GND), U6.1 (GND), U6.40 (GND), U6.41_1 (GND), U6.41_2 (GND), U6.41_3 (GND), U6.41_4 (GND), U6.41_5 (GND), U6.41_6 (GND), U6.41_7 (GND), U6.41_8 (GND), U6.41_9 (GND), U7.4 (GND), U8.12 (GND), U9.4 (GND), U10.1 (PGND), U10.9 (AGND), U11.1 (A1), U11.2 (A0), U11.7 (GND), U12.12 (GND); also elsewhere on the board
HGATE: D21.2 (A), R67.1, R81.1, U8.6 (HGATE), Z1.1 (K)
IN+: R70.2 (S1), R91.2, U8.2 (SENSE)
IN-: R70.3 (S2), R92.2, U8.1 (OUT)
LEAK_BASE: U6.7 (IO7); also elsewhere on the board
LEAK_EXC: U6.22 (IO14); also elsewhere on the board
LED_DOUT: D38.2 (DOUT); also elsewhere on the board
LOADCELL_DRDY: U3.12 (DRDY), U6.8 (IO15)
MUX_RST_N: R90.1, U6.23 (IO21), U12.3 (~RESET)
NRST_G1: Q4.1 (G), R18.1; also elsewhere on the board
NRST_G2: Q5.1 (G), R19.1; also elsewhere on the board
NRST_G3: Q6.1 (G), R20.1; also elsewhere on the board
unnamed: D7.1 (K), J13.1, R51.1, R54.1
unnamed: C40.1, D21.1 (K), R81.2
unnamed: D34.2 (A), J8.2, Q18.3 (D)
unnamed: D35.2 (A), J9.2, Q19.3 (D)
unnamed: D36.2 (A), J10.2, Q20.3 (D)
unnamed: D4.2 (DOUT), D37.4 (DIN)
unnamed: D37.2 (DOUT), D38.4 (DIN)
unnamed: IC1.3 (1Y), R22.1
unnamed: J1.A5 (CC1), R15.1
unnamed: J1.B5 (CC2), R23.1
unnamed: C49.2, PS1.7 (BOOT)
unnamed: PS1.3 (EN), R83.2
unnamed: PS1.5 (FB), R93.1, R94.2
unnamed: C49.1, L2.1, PS1.8 (SW)
unnamed: C46.2, PS1.6 (VCC)
unnamed: Q10.1, R67.2
unnamed: Q11.4 (G), U8.4 (DGATE), Z2.1 (K)
unnamed: Q10.3, Q11.1 (S_1), Q11.2 (S_2), Q11.3 (S_3), U8.5 (SOURCE), Z1.2 (A), Z2.2 (A)
unnamed: Q18.1 (G), R119.2, R122.2
unnamed: Q19.1 (G), R120.2, R123.2
unnamed: Q20.1 (G), R121.2, R124.2
unnamed: R26.1, R27.2, R28.1
unnamed: R33.1, R34.2, R38.2
unnamed: R39.2, R41.1, R43.1
unnamed: C10.1, U3.6 (VBG)
unnamed: C6.1, C7.1, R14.2, U3.2 (VIN1N)
unnamed: C4.1, C7.2, R13.2, U3.3 (VIN1P)
unnamed: C11.1, U3.4 (VIN2N)
unnamed: C11.2, U3.5 (VIN2P)
unnamed: R42.2, U4.12 (DIAG_EN)
unnamed: R40.2, R44.1, U4.3 (EN)
unnamed: R45.2, U4.13 (ILIM)
unnamed: R43.2, U4.14 (IMON)
unnamed: R62.1, U8.9 (*SHDN)
unnamed: R73.1, R74.2, U8.16 (FB)
unnamed: R60.1, R61.2, U8.11 (OV)
unnamed: C34.1, U8.15 (TMR)
unnamed: R59.1, R60.2, U8.10 (UV)
unnamed: C37.2, U10.7 (BOOT)
unnamed: R78.1, R79.2, U10.5 (FB)
unnamed: C37.1, L1.1, U10.8 (SW)
unnamed: C33.1, U10.6 (VCC)
unnamed: C47.1, R91.1, U11.10 (IN+)
unnamed: C47.2, R92.1, U11.9 (IN-)
OE_1: D18.1 (K), J4.1 (OE); also elsewhere on the board
OE_1_D: Q1.3 (D); also elsewhere on the board
OE_2: D40.1 (K), J14.1 (OE); also elsewhere on the board
OE_2_D: Q2.3 (D); also elsewhere on the board
OE_3: D43.1 (K), J15.1 (OE); also elsewhere on the board
OE_3_D: Q3.3 (D); also elsewhere on the board
OE_DRV: U6.26 (IO45); also elsewhere on the board
OE_G1: Q1.1 (G), R10.1; also elsewhere on the board
OE_G2: Q2.1 (G), R11.1; also elsewhere on the board
OE_G3: Q3.1 (G), R12.1; also elsewhere on the board
OW_F1: Q9.2 (S), R31.2, U6.19 (IO11)
OW_F2: Q7.2 (S), R29.2, U6.20 (IO12)
OW_F3: Q8.2 (S), R30.2, U6.21 (IO13)
PG_5V: R66.1, U6.33 (IO40), U10.4 (PG)
PUMP_EN: IC1.5 (2A), U6.34 (IO41); also elsewhere on the board
PUMP_GDRV: IC1.6 (2Y); also elsewhere on the board
PWR_ALERT_N: R82.2, U6.11 (IO18), U11.3 (ALERT)
RING_DATA: IC1.2 (1A), R21.2, U6.12 (IO8)
RXD0: U6.36 (RXD0); also elsewhere on the board
SCL_0: R85.1, U6.25 (IO48), U12.22 (SCL)
SCL_1: R4.2, U2.1 (SCL), U3.13 (SCLK), U6.10 (IO17), U11.5 (SCL)
SCL_F1: D8.1 (K), J4.3 (SCL), R50.2, R52.2, U5.5 (TY), U5.6 (RY)
SCL_F2: D13.1 (K), J14.3 (SCL), R58.2, R64.2, U7.5 (TY), U7.6 (RY)
SCL_F3: D19.1 (K), J15.3 (SCL), R72.2, R76.2, U9.5 (TY), U9.6 (RY)
SC_0: R46.2, R50.1, U5.7 (SY), U12.5 (SC0)
SC_1: R55.2, R58.1, U7.7 (SY), U12.7 (SC1)
SC_2: R68.2, R72.1, U9.7 (SY), U12.9 (SC2)
SDA_0: R84.1, U6.24 (IO47), U12.23 (SDA)
SDA_1: R9.2, U2.4 (SDA), U3.14 (SDIO), U6.9 (IO16), U11.4 (SDA)
SDA_F1: D9.1 (K), J4.4 (SDA), R49.1, R53.2, U5.2 (RX), U5.3 (TX)
SDA_F2: D14.1 (K), J14.4 (SDA), R57.1, R65.2, U7.2 (RX), U7.3 (TX)
SDA_F3: D20.1 (K), J15.4 (SDA), R71.1, R77.2, U9.2 (RX), U9.3 (TX)
SD_0: R47.2, R49.2, U5.1 (SX), U12.4 (SD0)
SD_1: R56.2, R57.2, U7.1 (SX), U12.6 (SD1)
SD_2: R69.2, R71.2, U9.1 (SX), U12.8 (SD2)
TANK_LOW: C27.1, IC1.4 (2~OE), R54.2, U6.35 (IO42)
TCA9548A SCX >2: R89.2, U12.14 (SC4), U12.16 (SC5), U12.18 (SC6), U12.20 (SC7)
TCA9548A SCX >2D: R96.2, U12.11 (SC3)
TCA9548A SDX >2: R88.2, U12.13 (SD4), U12.15 (SD5), U12.17 (SD6), U12.19 (SD7)
TCA9548A SDX >2D: R95.2, U12.10 (SD3)
TXD0: U6.37 (TXD0); also elsewhere on the board
U2_VDD: C8.1, C12.1, R17.1, U2.2 (VDD)
U8_VCC: C30.1, R62.2, R63.1, U8.8 (VCC)
USB_D+: R5.2, U6.14 (IO20)
USB_D-: R6.1, U6.13 (IO19)
USB_VBUS: J1.A4/B9 (VBUS_A), J1.B4/AP (VBUS_B), U1.5
V24_SENSE: C20.1, R38.1, U6.4 (IO4)
VALVE_IMON: C18.1, R32.2, U6.5 (IO5)
VALVE_IMON_DIV: C19.2, R32.1, R39.1
VALVE_RAIL: C25.2, C79.1, C80.1, C81.1, D34.1 (K), D35.1 (K), D36.1 (K), J8.1, J9.1, J10.1, R27.1, R48.2, U4.5 (OUT), U4.6 (OUT), U4.7 (OUT)
VALVE_RAIL_EN: R40.1, U6.31 (IO38)
VALVE_RAIL_SENSE_DIV: C16.1, R26.2, U6.6 (IO6)
VIN: C43.1, D23.1, J5.1, J5.4, Q10.2, R33.2, R59.2, R63.2; also elsewhere on the board
VIN_FLT_N: R80.1, U6.32 (IO39), U8.13 (*FLT)
Valve_0: R119.1, U6.39 (IO1)
Valve_1: R120.1, U6.38 (IO2)
Valve_2: R121.1, U6.17 (IO9)
nRESET_1: D17.1 (K), J4.2 (nRESET); also elsewhere on the board
nRESET_1_D: Q4.3 (D); also elsewhere on the board
nRESET_2: D39.1 (K), J14.2 (nRESET); also elsewhere on the board
nRESET_2_D: Q5.3 (D); also elsewhere on the board
nRESET_3: D42.1 (K), J15.2 (nRESET); also elsewhere on the board
nRESET_3_D: Q6.3 (D); also elsewhere on the board
nRESET_DRV: U6.16 (IO46); also elsewhere on the board

Notes on the sheet:
Valve Driver
Pull-ups might be present at diff location
0R links: plain-I2C build only - DNP while U5/U7/U9 are fitted
Load Cell 30KG
100V X7R
Use separate via GND for each
INA226AIDGSR comes after LTC4364IS
TCA9548A Pull-up Out 3-7
Clamped at 32V
Floor Cables
Driver FETs
ESP32-S3-WROOM-1U Peripherals
ESD per line: Z6.0 = 5 V Z3.3 = 3.3 V
MCU
Magnet float switch Closed when wet
I2C Mux
I2C Buffer
Power Management 24V->5V 5V-3V3 Input Protection Controller Input current monitor
Floor boards (x3): separate KiCad project GrowHub_Floor (2-layer).
