Ajakovski/GrowHub/Hardware/Main_PCB/GrowHub_Elec.kicad_pcb

## KiCad design Hardware/Main_PCB/GrowHub_Elec.kicad_pcb (continued)

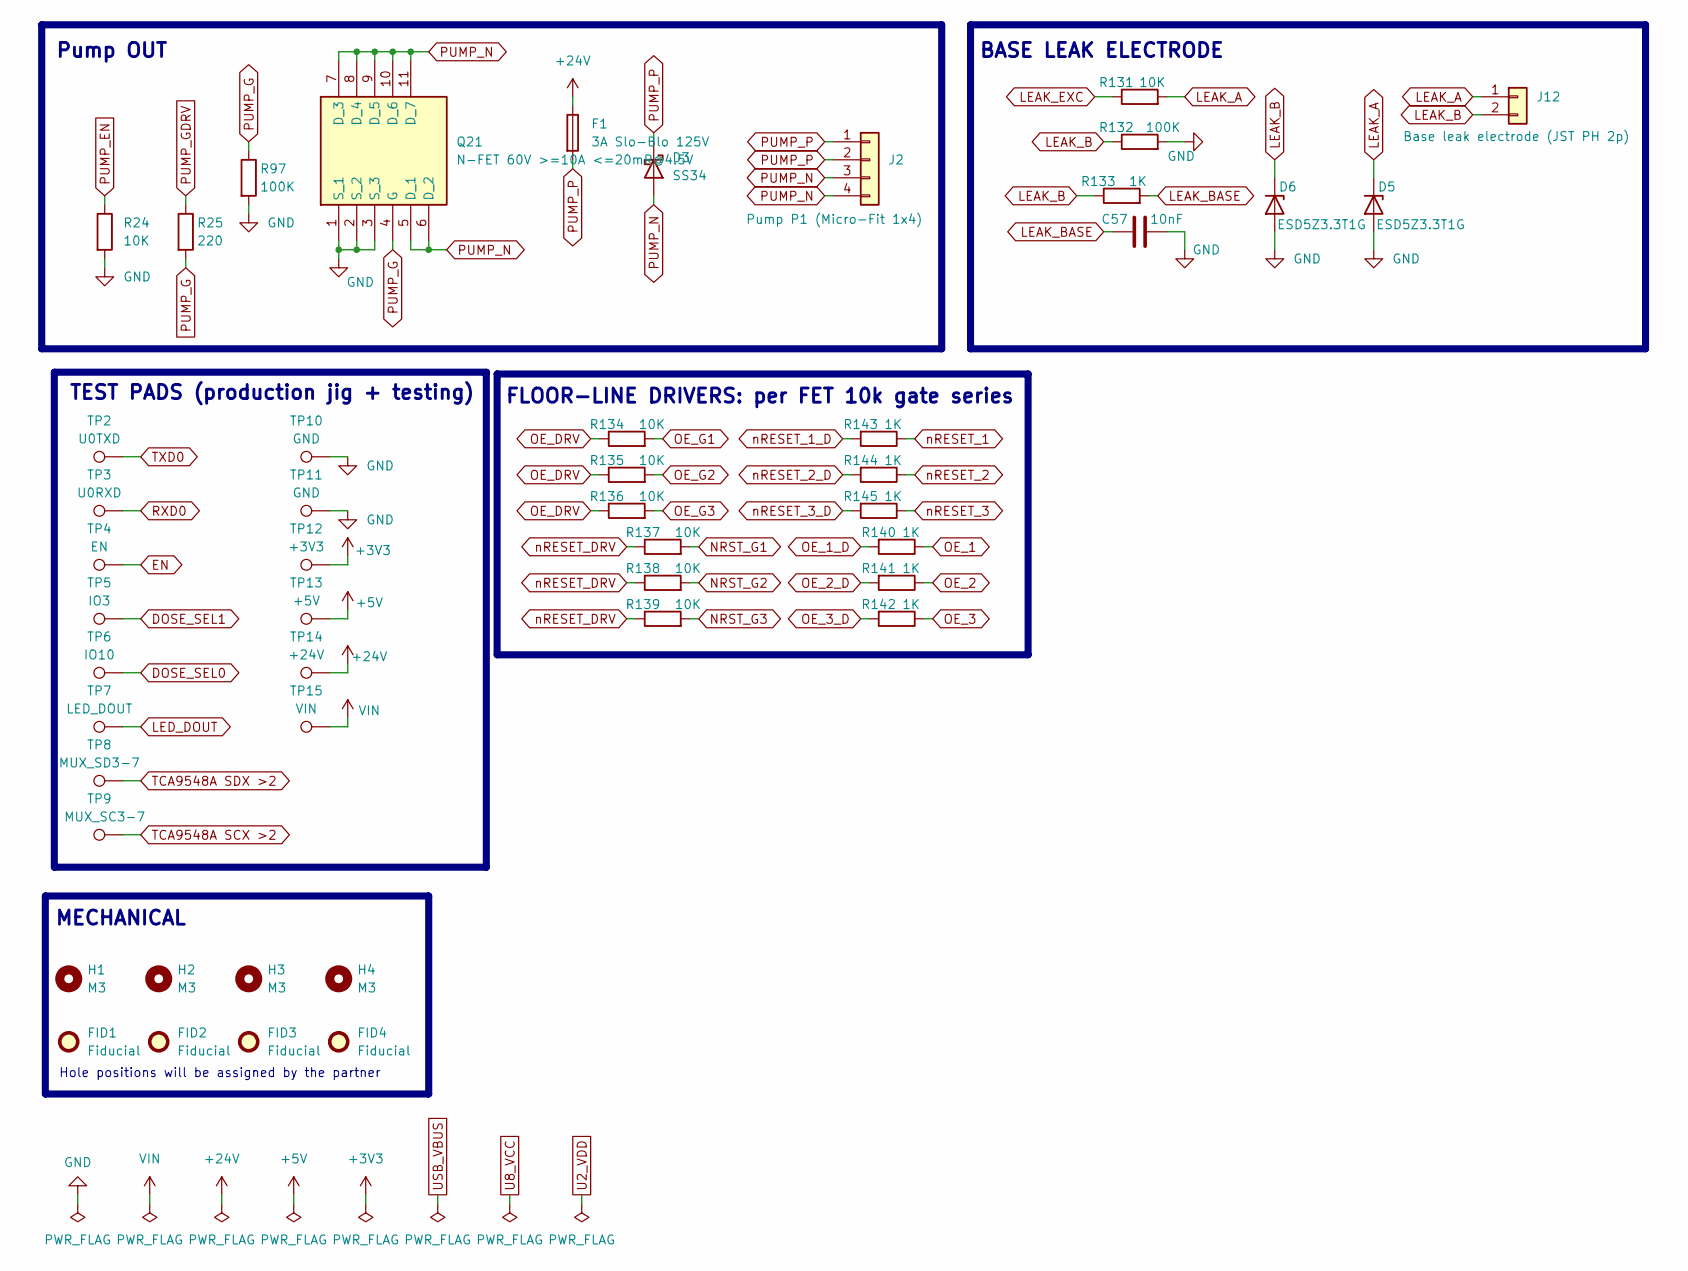
[picture p103: schematic Base_IO.kicad_sch]

Parts:
C57: 10nF; C_0603_1608Metric; Rating 16V X7R
D3: SS34; D_SMA
D5, D6: ESD5Z3.3T1G; D_SOD-523
F1: 3A Slo-Blo 125V; Fuse_Littelfuse-NANO2-451_453; Rating 3 A time-lag, 125 V, 50 A interrupting;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; MPN Littelfuse 0454003.MR (NANO2 454, 2410)
FID1, FID2, FID3, FID4: Fiducial; Fiducial_1mm_Mask2mm
H1, H2, H3, H4: M3; MountingHole_3.2mm_M3
J2: Pump P1 (Micro-Fit 1x4); Molex_Micro-Fit_3.0_43650-0400_1x04_P3.00mm_Horizontal
J12: Base leak electrode (JST PH 2p); JST_PH_B2B-PH-K_1x02_P2.00mm_Vertical
Q21: N-FET 60V >=10A <=20mR@4.5V; FDMS86252; Mouser Part Number 512-FDMS86500L
R24, R131, R134, R135, R136, R137, R138, R139: 10K; R_0603_1608Metric
R25: 220; R_0603_1608Metric
R97, R132: 100K; R_0603_1608Metric
R133: 1K; R_0603_1608Metric
R140, R141, R142, R143, R144, R145: 1K; R_2010_5025Metric
TP2: U0TXD; TestPoint_Pad_D1.5mm
TP3: U0RXD; TestPoint_Pad_D1.5mm
TP4: EN; TestPoint_Pad_D1.5mm
TP5: IO3; TestPoint_Pad_D1.5mm
TP6: IO10; TestPoint_Pad_D1.5mm
TP7: LED_DOUT; TestPoint_Pad_D1.5mm
TP8: MUX_SD3-7; TestPoint_Pad_D1.5mm
TP9: MUX_SC3-7; TestPoint_Pad_D1.5mm
TP10, TP11: GND; TestPoint_Pad_D1.5mm
TP12: +3V3; TestPoint_Pad_D1.5mm
TP13: +5V; TestPoint_Pad_D1.5mm
TP14: +24V; TestPoint_Pad_D1.5mm
TP15: VIN; TestPoint_Pad_D1.5mm

Connections:
+3V3: TP12.1 (1_1); also elsewhere on the board
+5V: TP13.1 (1_1); also elsewhere on the board
+24V: F1.1, TP14.1 (1_1); also elsewhere on the board
EN: TP4.1 (1_1); also elsewhere on the board
GND: C57.2, D5.2 (A), D6.2 (A), Q21.1 (S_1), Q21.2 (S_2), Q21.3 (S_3), R24.2, R97.2, R132.2, TP10.1 (1_1), TP11.1 (1_1); also elsewhere on the board
LEAK_A: D5.1 (K), J12.1, R131.2
LEAK_B: D6.1 (K), J12.2, R132.1, R133.1
LEAK_BASE: C57.1, R133.2; also elsewhere on the board
LEAK_EXC: R131.1; also elsewhere on the board
LED_DOUT: TP7.1 (1_1); also elsewhere on the board
NRST_G1: R137.2; also elsewhere on the board
NRST_G2: R138.2; also elsewhere on the board
NRST_G3: R139.2; also elsewhere on the board
OE_1: R140.1; also elsewhere on the board
OE_1_D: R140.2; also elsewhere on the board
OE_2: R141.1; also elsewhere on the board
OE_2_D: R141.2; also elsewhere on the board
OE_3: R142.1; also elsewhere on the board
OE_3_D: R142.2; also elsewhere on the board
OE_DRV: R134.1, R135.1, R136.1; also elsewhere on the board
OE_G1: R134.2; also elsewhere on the board
OE_G2: R135.2; also elsewhere on the board
OE_G3: R136.2; also elsewhere on the board
PUMP_EN: R24.1; also elsewhere on the board
PUMP_G: Q21.4 (G), R25.2, R97.1
PUMP_GDRV: R25.1; also elsewhere on the board
PUMP_N: D3.2 (A), J2.3, J2.4, Q21.5 (D_1), Q21.6 (D_2), Q21.7 (D_3), Q21.8 (D_4), Q21.9 (D_5), Q21.10 (D_6), Q21.11 (D_7)
PUMP_P: D3.1 (K), F1.2, J2.1, J2.2
RXD0: TP3.1 (1_1); also elsewhere on the board
TXD0: TP2.1 (1_1); also elsewhere on the board
VIN: TP15.1 (1_1); also elsewhere on the board
nRESET_1: R143.1; also elsewhere on the board
nRESET_1_D: R143.2; also elsewhere on the board
nRESET_2: R144.1; also elsewhere on the board
nRESET_2_D: R144.2; also elsewhere on the board
nRESET_3: R145.1; also elsewhere on the board
nRESET_3_D: R145.2; also elsewhere on the board
nRESET_DRV: R137.1, R138.1, R139.1; also elsewhere on the board

Notes on the sheet:
FLOOR-LINE DRIVERS: per FET 10k gate series
TEST PADS (production jig + testing)
BASE LEAK ELECTRODE
Pump OUT
MECHANICAL
Hole positions will be assigned by the partner

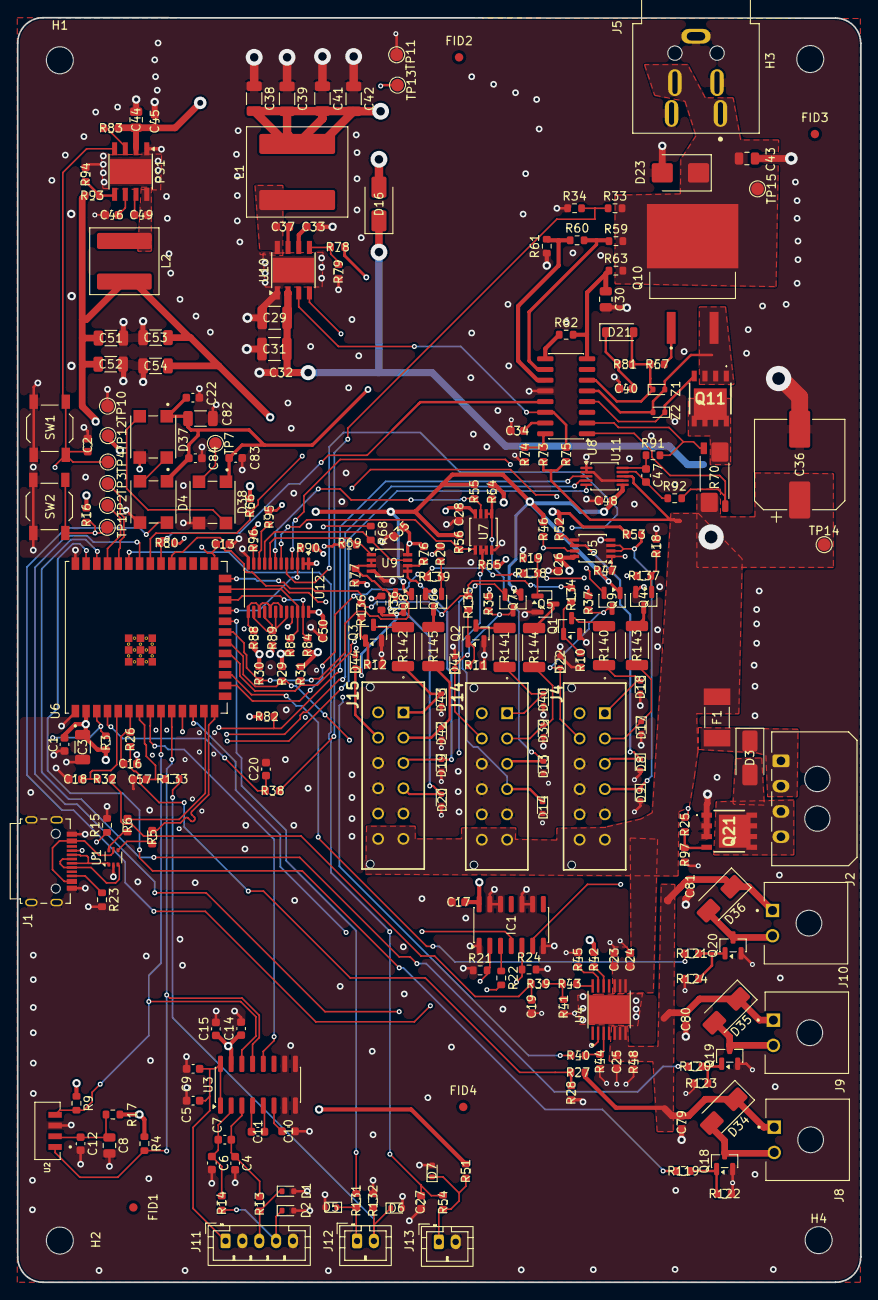
[picture p104: board GrowHub_Elec.kicad_pcb from above]

Board: 4 copper layers, 100.0 x 150.0 mm, 263 parts (0 on the bottom side), 143 nets.
