Ajakovski/GrowHub/(commit log)

2026-09-18 Main PCB
    [Floor.kicad_sch, GrowHub_Elec.kicad_pcb, GrowHub_Elec.kicad_sch]
2026-09-23 made a esp32 simulator sending fake data to the api for testing
2026-09-23 added a feature where you can switch between the hubs and tiles when looking at the dasboard
2026-09-23 Week 1 Schematics
    [GrowHub_Elec.kicad_sch, Main_Floor_PCB.kicad_sch]
2026-09-25 Updated schematic
    [Floor.kicad_sch, GrowHub_Elec.kicad_sch]
2026-09-25 Hardware Week 2
    [Floor.kicad_sch, GrowHub_Elec.kicad_sch]
2026-10-04 added the cad file
    [growhub_design_v4.FCStd]
2026-10-09 schematic newest
    [Floor.kicad_sch, GrowHub_Elec.kicad_sch, Main_Floor_PCB.kicad_sch]
2026-10-11 added a button to switch from webcam to stock images in dashboard
2026-10-11 added v4.1 cad model
2026-10-11 Week 4 Schematic
2026-10-17 Finished schematics
2026-10-17 lib schematic
2026-10-17 #19 Journal AJ
    Added detailed journal entries for PCB design progress, including tasks completed, problems encountered, and next steps.
2026-10-25 added a way for the ai to control lights heat and water flow
2026-10-31 #25 Journal AJ
    Document progress on PCB design and next steps.
2026-11-07 Imported Pictures for README and BOM
2026-11-07 Added newest KiCad files and PDFs
2026-11-07 Added both gerbers
2026-11-07 Main PCB step file
2026-11-07 Floor PCB step
2026-11-08 Updated README BOM table
2026-11-08 finished the scaffolding in actuators.c
2026-11-08 scaffolding for actuators.h
2026-11-08 added scaffolding for actuators_internal.h and actuators_pins_esp.c
2026-11-08 finished the scaffolding for the pcb firmware
2026-11-08 added the step files for the cad models of the planter
2026-11-10 added the v1.1 of the planter box and the floor pcb compartment step files
